vsulako/AFFBWheel/images/base_TLE5010.png

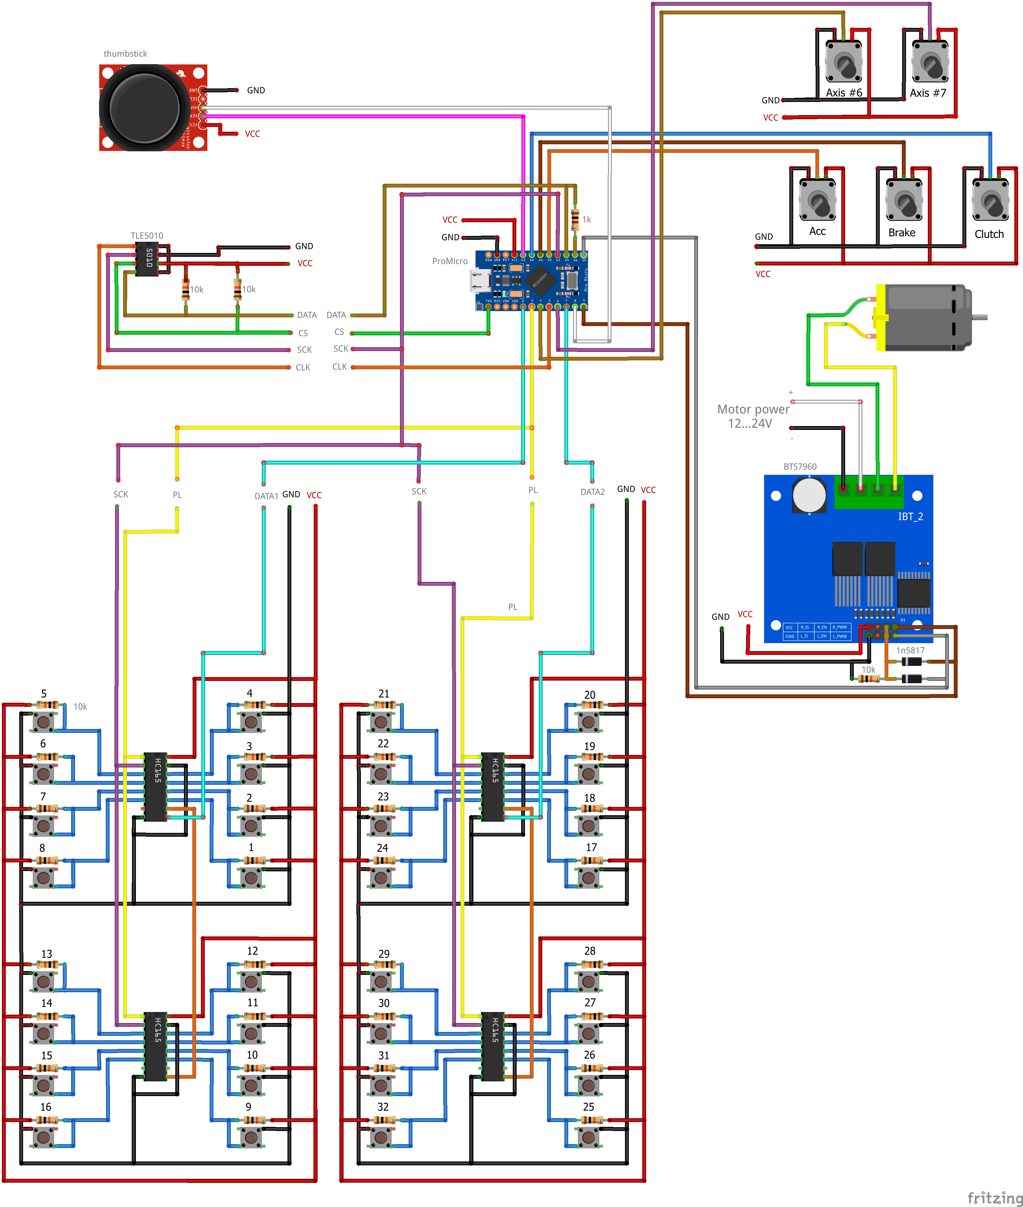
images/base_TLE5010.png
