vsulako/AFFBWheel/images/pedals_ADS1015_resistors.png

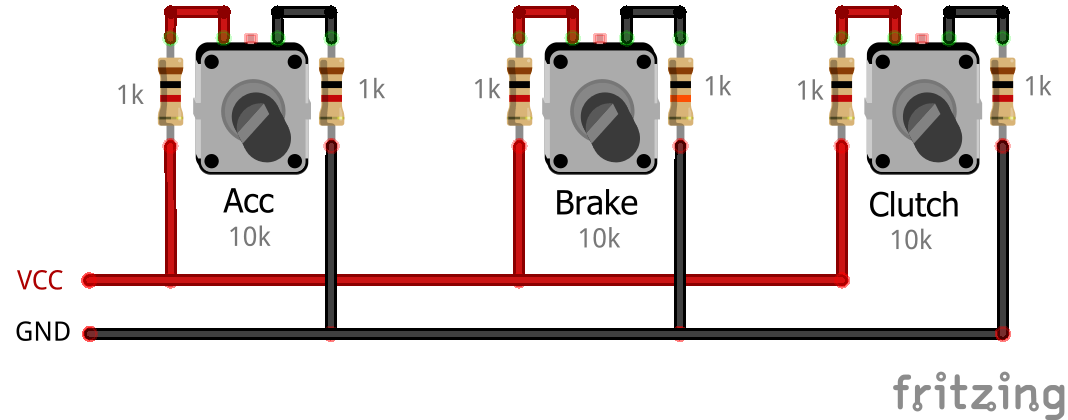
images/pedals_ADS1015_resistors.png
