vsulako/AFFBWheel/images/pedals_ADS1015_TL431.png

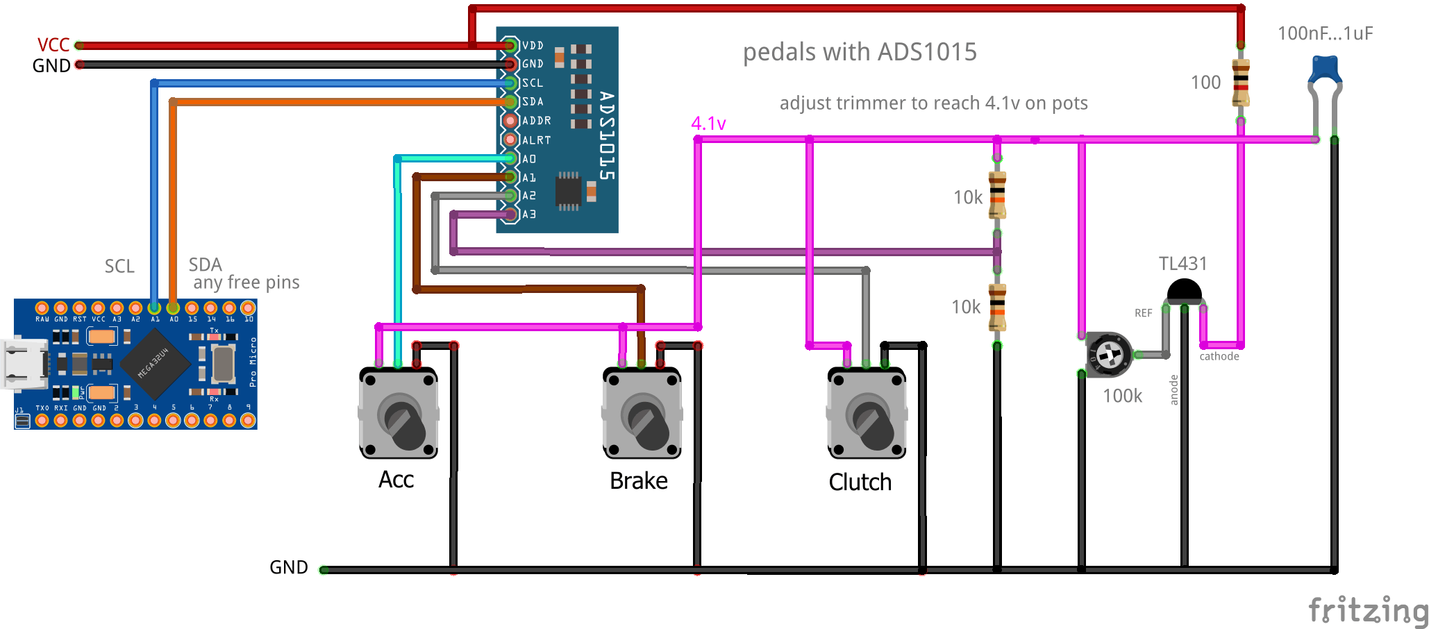
images/pedals_ADS1015_TL431.png
