vsulako/AFFBWheel/images/pedals_HC4052.png

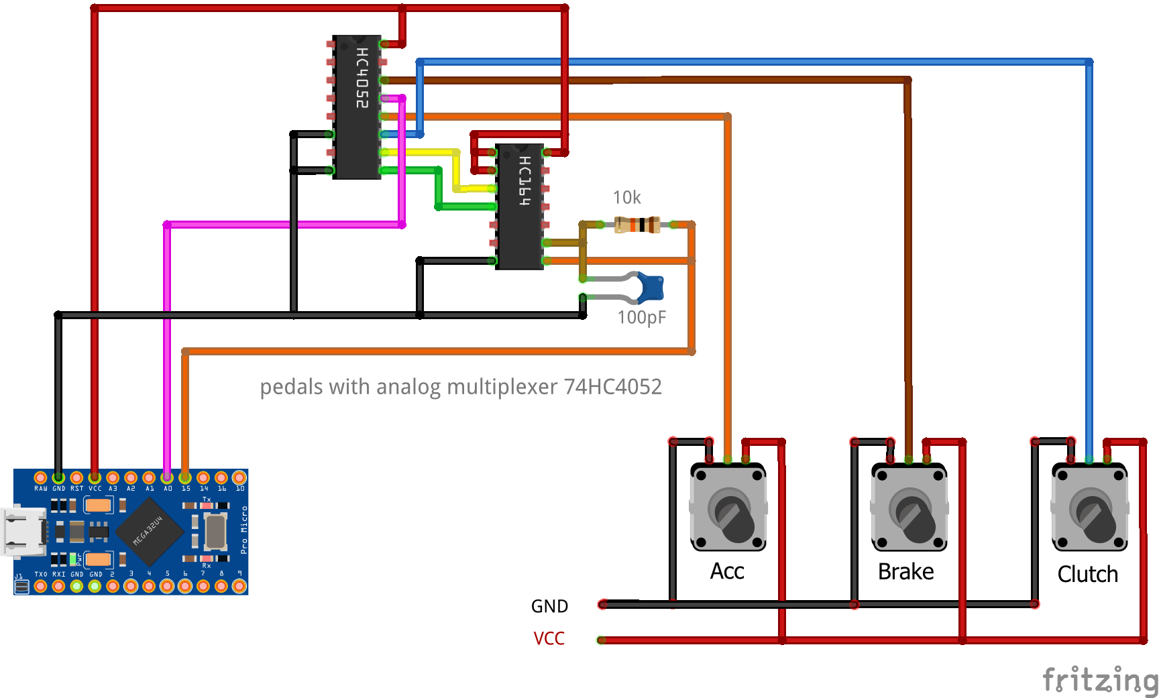
images/pedals_HC4052.png
