vsulako/AFFBWheel/images/pedals_HC4067.png

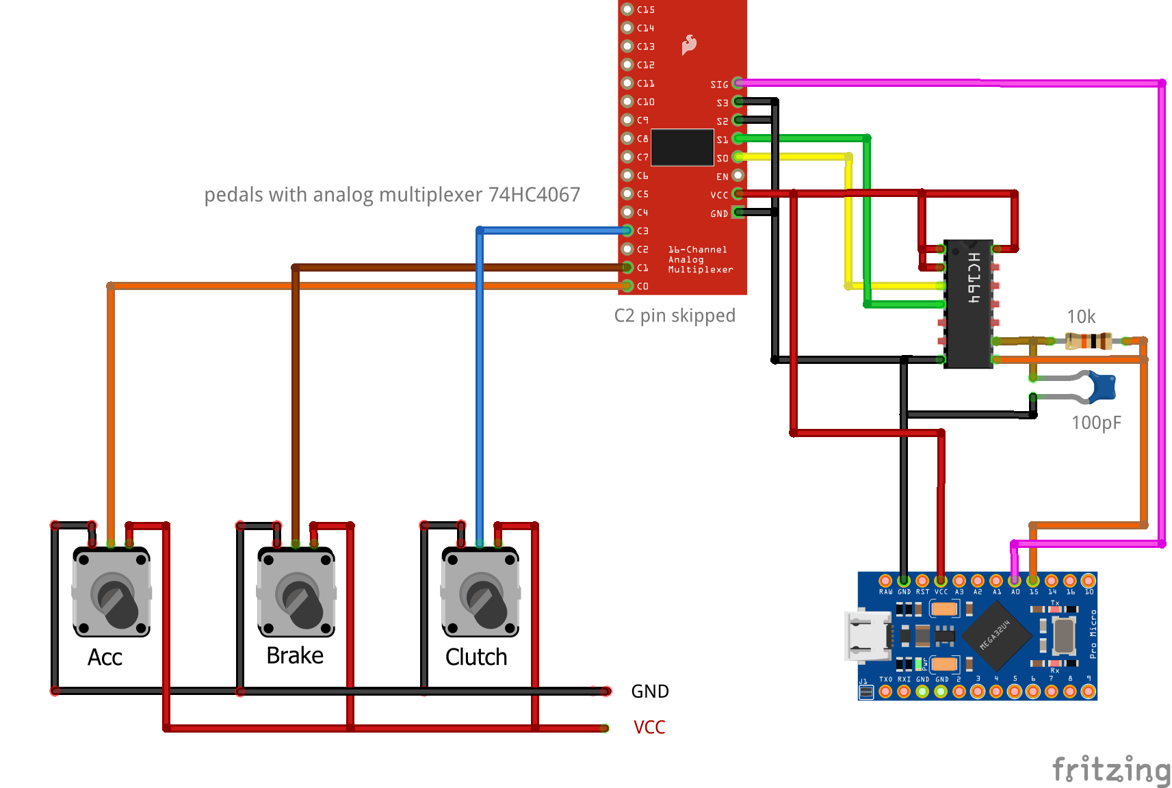
images/pedals_HC4067.png
