vsulako/AFFBWheel/images/pedals_MCP2304_4w_v3.png

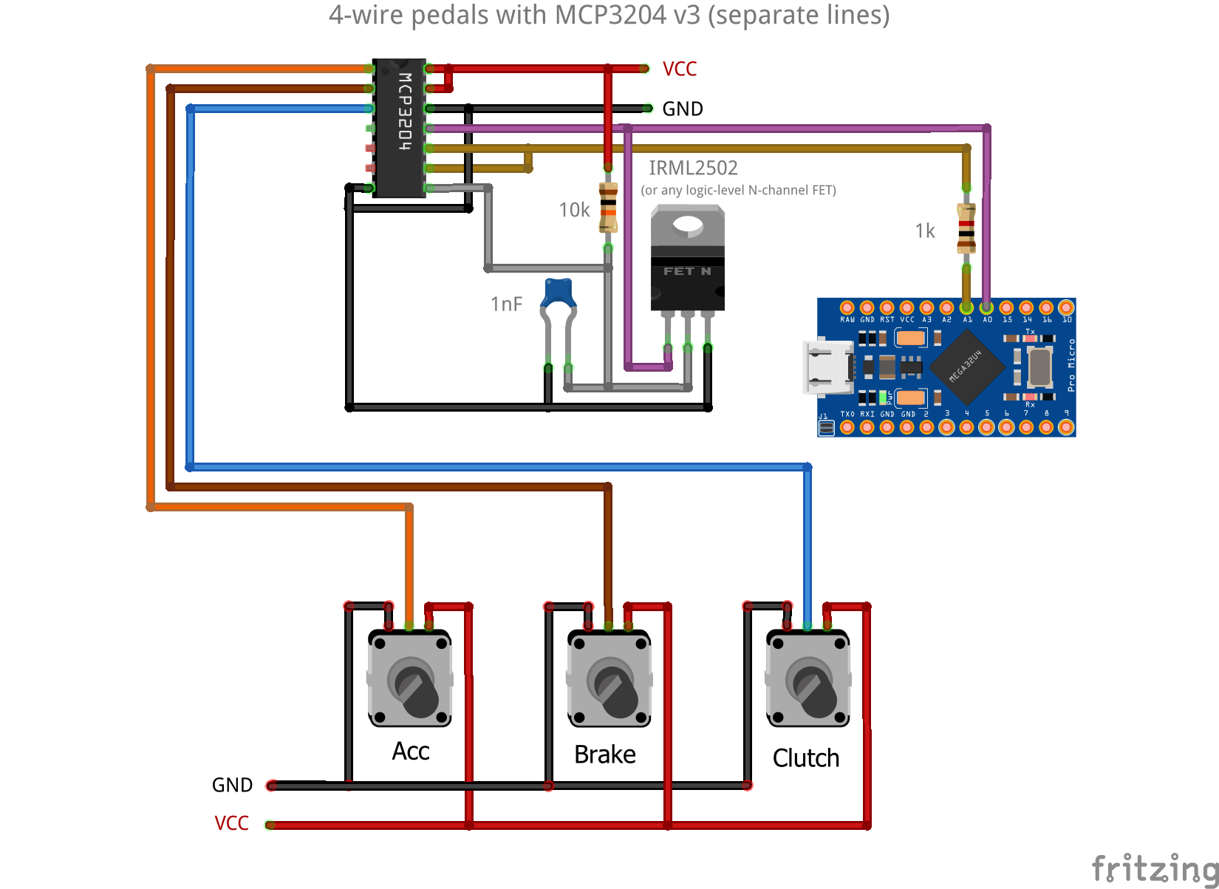
images/pedals_MCP2304_4w_v3.png
