vsulako/AFFBWheel/images/pedals_MCP2304_5w.png

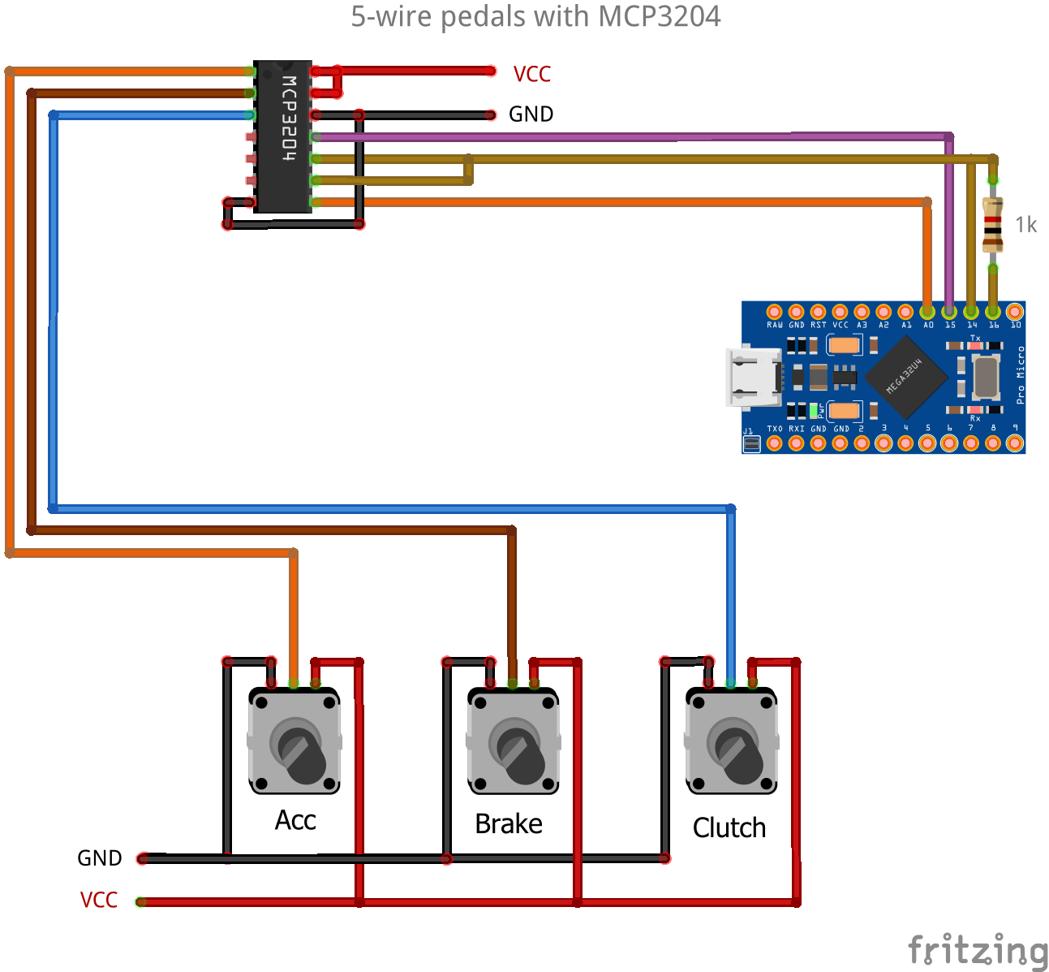
images/pedals_MCP2304_5w.png
