vsulako/AFFBWheel/images/pedals_MCP2304_6w.png

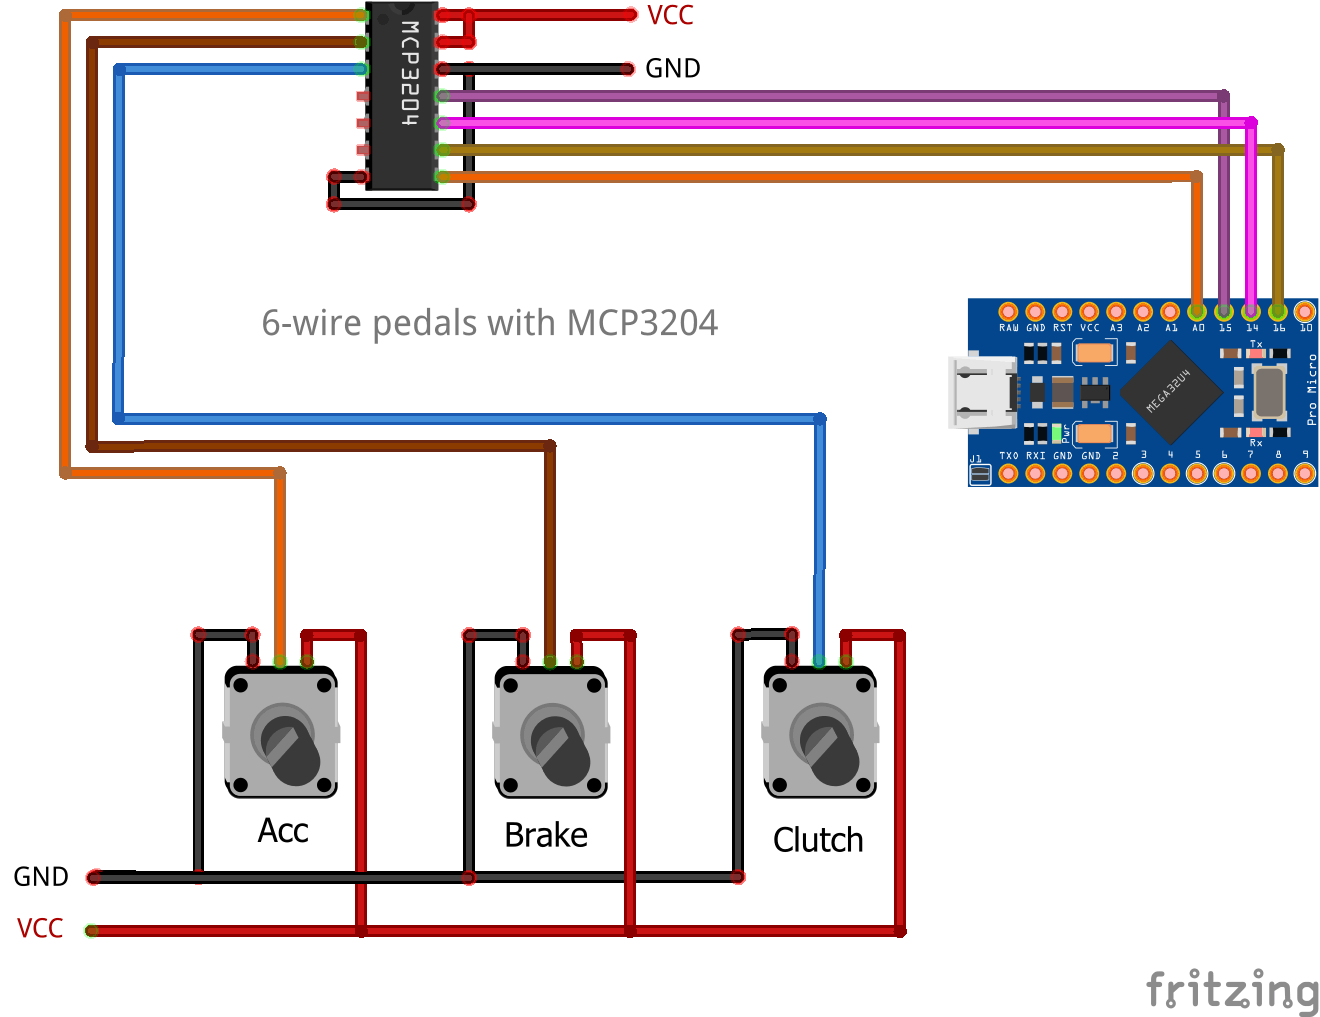
images/pedals_MCP2304_6w.png
