vsulako/AFFBWheel/images/pedals_MCP2304_TLE5010_4w_v1.png

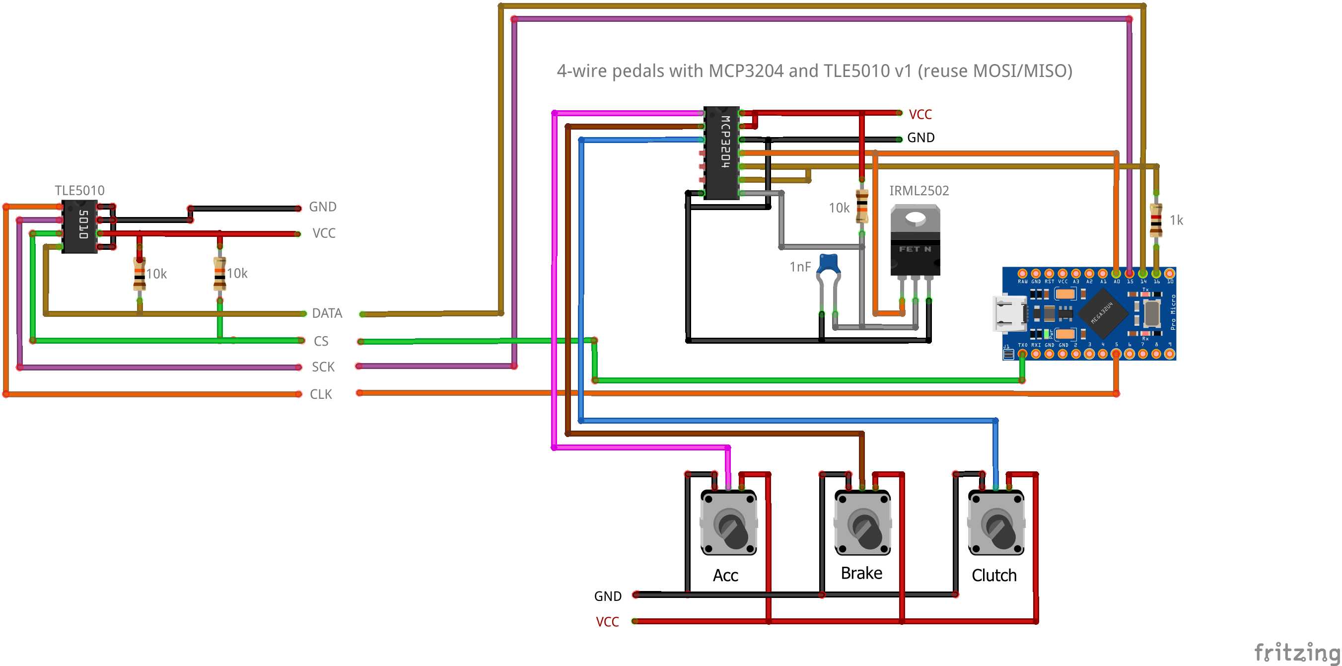
images/pedals_MCP2304_TLE5010_4w_v1.png
