vsulako/AFFBWheel/images/pedals_MCP2304_TLE5010_4w_v2.png

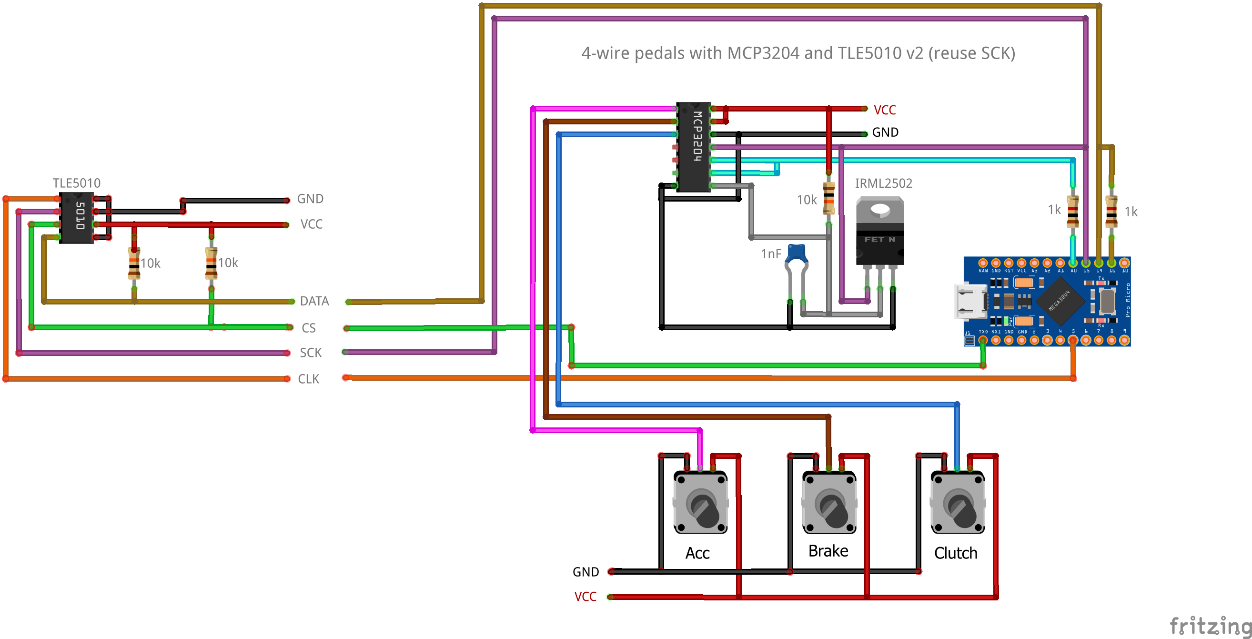
images/pedals_MCP2304_TLE5010_4w_v2.png
