vsulako/AFFBWheel/images/pedals_MCP2304_TLE5010_6w.png

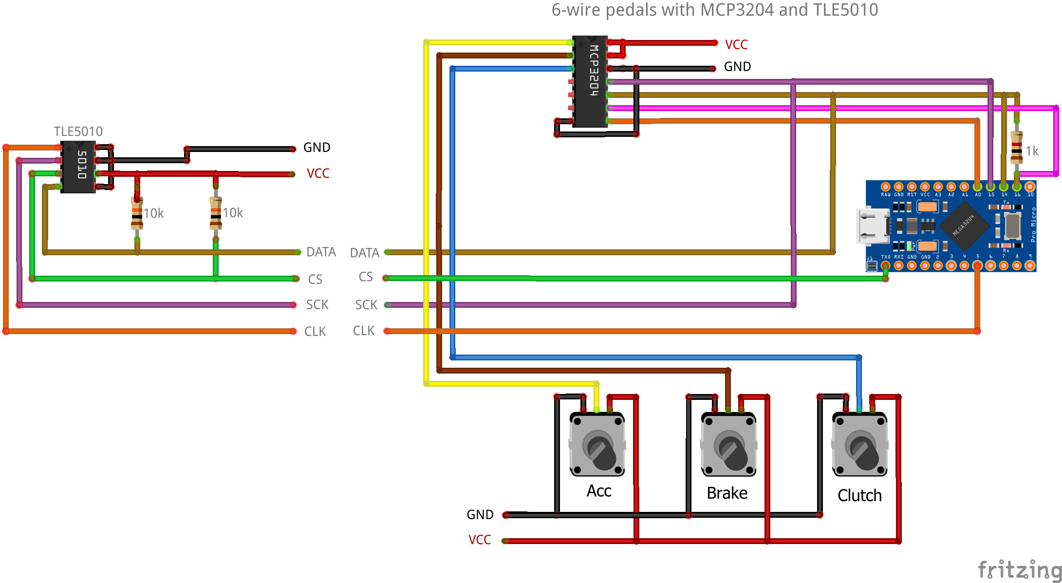
images/pedals_MCP2304_TLE5010_6w.png
