vsulako/AFFBWheel/(threads)

Thread 1 (2022-04-03):

stepper version???

gielbloks, 2022-04-03:
good day i am enjoying this info you share!

i have experience with steppers and power systems through
3d printing and cnc, this is the first sim rig i am building

i am building a sim wheel myself but want to use a double 3nm nema 23 beqause i have them lying around with open loop drivers,

for power i use 4 350 watt hp server psu's in series so 48 volt, otherwise the nema 23 are to slow
costing €20 euro per 10 pieces here

but can i use open loop system with an hall encoder you are using on the steering shaft? the steppers are going to be belt drive 1:4 so i have 24 nm at max, having a little reserve power is wished so the motors don't need to maxxed out and burn..

regards giel

vsulako, 2022-04-03:
Sorry, I think I do not understand your question well.

If you want to use stepper in sim wheel controller as feedback motor - I doubt it can be done easily.
I actually tried that once with disappointing results.
Usually, you can control stepper rotating speed and direction. When there's no control signal, it's standing still.
And it IS still - one almost cannot turn stepper's shaft by hand when it is powered.
So, who needs a sim wheel which only turns by itself, but cannot be turned by hand?
I tried to enable/disable stepper at high frequency, and also lower stepper's current. It somehow helped, but caused stepper to jerk a lot. It was unusable and I did not experiment further.
Of course, you can experiment yourself, but I cannot help with that.
At least, you will need to replace BTS7960 with stepper driver, and rewrite motor handling code to work with this driver.

"hall encoder" (I suppose, you mean TLE5010 or AS5600?) is merely a rotation angle sensor and have nothing to do with feedback motor.

gielbloks, 2022-04-03:
from the 3 d printing systems i always have the position the stepper is moved to
then it stays powered to prevent the moving when an other stepper is running ( the z axis height) is always holding position beqause otherwise it could fall down..sort of standby current ist is adjustable from 10 to 80% typically using 25..

my thoughts where change the pwm signal into a step /dir signal but as i read it isn't that easy..
i also have closed loop drivers but they will always move to the commanded position so i think this couldn't be used eighther or do you think it will?

i was thinking stepper motors are more rigid than dc.. i have a big wiper motor and a starter motor from a truck.. but if you put force on it i was thinking it would burn out in a very short time or am i afraid for nothing?

gielbloks, 2022-04-03:
ill work it out thanks

vsulako, 2022-04-03:
of course dc motor can burn if it is powered and blocked (stalls). I suggest to use external current limiter, or power source that will not exceed stall current of motor.

gielbloks, 2022-04-03:
thinking about another thing,is it also possible to add 10 potentiometers more on it for brake balance etc etc,i am building a full f1 wheel made the wheel itself in carbon/glass fiber when ready i can pull a mold from it so i can duplicate them for 30/50€ 80/100€ including pedalbox and steer base with room for a screen on the base or the steer itself,ill include a picture from the frontplate ( remember it is in the rough!!!)
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

vsulako, 2022-04-03:
You mean add 10 additional axes? No, there is a limit of 8 axes per generic controller.
But simplest solution is to use additional controller. a ProMicro with MMJoy2, or STM32F103C8 with FreeJoy firmware will allow to add 8 axes/128buttons more. If game/sim can use such number of axes, it will defininely work with multiple controllers.

gielbloks, 2022-04-04:
thankyou!!

Thread 2 (2022-04-06):

Hand brake axis.

lazenyuk-dmitry, 2022-04-06:
I haven't used your firmware yet. But it looks cool. I'm still waiting for accessories from AliExpress.

But I think it would be cool to add a pin to connect the handbrake potentiometer.

vsulako, 2022-04-06:
It is possible to add 2 more axes.
Will try to implement it later.

lazenyuk-dmitry, 2022-04-06:
> It is possible to add 2 more axes.

ok, that's what I'm planning to do now.

vsulako, 2022-04-06:
Added 2 analog axes similar to stick. No spare pins now :)

lazenyuk-dmitry, 2022-04-07:
А ты говоришь по русски. У меня с английским не очень. Напишу на руском.

Я думаю достаточно добавить только ручник. Я не понял у тебя совсем не осталось пинов свободных или не осталось свободных для осей? Вроде по схеме еще есть пины свободные. Потому что на свободный пин ты мог бы еще добавить подключение канала Z энкодера, как в этом проекте https://github.com/ranenbg/Arduino-FFB-wheel/issues/3. Можно искать автоматически центральное положение руля при подключении, по моему хорошая фича. Хотя ты может это планировал сделать. Правда энкодер с каналом Z стоит в 3 раза дороже.

Не знаю нужен ли thumbstick вообще. Можно конечно его вынести на руль для обзора в игре но можно так же это и кнопками в принципе делать. Возможно интереснее было бы использование этих осей в качестве КПП на осях, как здесь https://www.youtube.com/watch?v=aYYAbcPKN8g там в описании есть схема. Я слышал что есть КПП logitech которые именно так и работают на потенциометрах. Но опять же не знаю насколько это актуально и многим ли нужно. Ну а вообще тоже интересная фича. Или можно предоставить выбор использовать те оси как thumbstick или как shifter, например как настройку в программе или в прошивке.

Вот в общем добавить подключение Z канала энкодера и автоматический поиск центра. И можно сделать возможность подключения КПП на осях. И тогда в твоей прошивке неверно будет все)

vsulako, 2022-04-07:
Не осталось пинов ProMicro, которые оставались бы свободными во всех вариантах подключений. Дополнительные оси наверное не повредят (хотя увеличивается время опроса). Может быть, лучше сделать их отключаемыми.
Использовать Z канал энкодера и автопоиск центра не планировалось - у меня нет такого энкодера, проверять не на чем. Да и не вижу никакой проблемы выровнять руль вручную и нажать кнопку центровки.
Стик задумывался для обзора в ETS2. Это такие же оси как остальные, их можно использовать на что угодно.
Что до эмуляции КПП двумя осями... выглядит несколько сложно, в плане того как это все конфигурировать и настраивать. Тем более что непонятно, насколько это востребовано. Пока что этот проект использую только я, и то только в ETS2 :)

lazenyuk-dmitry, 2022-04-07:
> Пока что этот проект использую только я, и то только в ETS2 :)

Ну думаю будут пользоваться) Я обязательно попробую как получу arduino leonardo и прочие комплектующие.
Вообще не так много прошивок для arduino. А так вообще пины одни и те же что ProMicro что Leonardo?

Есть группа ВК с обсуждением самодельных рулей можешь заходить если интересно [Самодельный игровой руль. делимся опытом](https://vk.me/join/CbkLyOKf9HyRnVNvNuYgayWbtbIK9rxG7Yg=)

Closed 2022-04-07.

Thread 3 (2022-04-06):

As5600 incorrectly works

Fiesta228, 2022-04-06:
As5600 dont work with this sketch, but works good with testing skech.
Магнитный датчик угла не работает, даже не шумит при поднесении магнита на любое расстояние, вы сталкивались с таким? Может ли быть такое изза не подключенных других осей? Что делать?

Fiesta228, 2022-04-06:
> У вас не используются другие i2c устройства - ADS1015 или MCP23017?
> Обновил код  (файлы AFFBWheel.ino, bb_i2c.h, bb_i2c.cpp), попробуйте теперь.

Другие устройства не использовались, теперь все работает, спасибо.

Thread 4 (2022-04-22):

AS5600 Arduino Leonardo

mitiaborodada, 2022-04-22:
Приветствую! Никак не хочет работать датчик AS5600 с Arduino Leonardo. Подключаю пины датчика SDA и SCL к пинам ардуино - RXI TX0 соответственно.  В config.h прописываю:
#define I2C_PIN_SDA 0
#define I2C_PIN_SCL 1

Но ничего не работает, никакой реакции. Причём сам датчик работает на этой же ардуинке с проверочным кодом.
Естественно, SDA и SCL подключаю к ардуино к соответствующим пинам SDA и SCL:

#include <AS5600.h>
AS5600 encoder;
int Wheel;
void setup() {
Serial.begin(115200);
}
void loop() {
Wheel = encoder.getPosition();
Serial.println(Wheel);
}

Уже голову сломал. Буду очень благодарен за помощь.

vsulako, 2022-04-22:
Используете последний код прошивки? Ранее была проблема изза которой AS5600 не работал.

mitiaborodada, 2022-04-23:
Да, скачивал буквально вчера. Может быть проблема из-за того, что кроме датчика AS5600 больше ничего не подключаю при этом? Сначала думал, что датчик сгорел, на этой же ардуинке с тестовым кодом работает и данные читаются.

vsulako, 2022-04-23:
Нет, должно работать и без всего остального. Попробуйте подключить к другим пинам.
Строчки для энкодера комментировать не обязательно, они используются только если в  STEER_TYPE указан ST_ENCODER.

mitiaborodada, 2022-04-23:
Да, спасибо, всё получилось! Я исправил предыдущее свое сообщение.
 Остался последний вопрос.
Как мне использовать AS5600 на всех осях: руль + педали?

vsulako, 2022-04-23:
Датичк еще может не работать, если его подключить после старта (или в процессе работы у него пропадет питание), потому что при старте идет инициализация, а далее только опрос.
В этой прошивке поддержка AS5600 планировалась только на оси руля. На педалях можно разве что вместо потенциометров поставить датчики Холла.
а чтобы AS5600 ставить на педали и другие оси, понадобится доработка. AS5600 еще и не позволяет менять I2C адрес, так что понадобятся ухищрения - что-то вроде TCA9548, либо на каждый датчик хотя бы по отдельной SDA линии, либо что-то еще - а это будет много изменений и в подключениях, и в коде. А у меня всего один датчик, я даже попробовать не могу :)

vsulako, 2022-04-23:
Вообще ведь у AS5600 есть еще аналоговый выход, так что дополнительные датчики можно подключать как потенциометры - выход OUT вместо среднего контакта потенциометра. Но я это не пробовал.

mitiaborodada, 2022-04-24:
Кстати, пробовал использовать 4 датчика с помощью TCA9548A. Отлично всё работает.

Всё таки, что-то не так и не пойму пока источник проблемы. Вчера всего лишь перепаял другой провод на датчике. Подключаю к ардуинке и снова ничего не работает - никаких сигналов! Тут же заливаю тестовую прошивку, переключаю SDA и SCL на соответствующие пины Arduino SDA и SCL и вуаля - всё работает! Переключаю обратно и ничего не работает. Пробовал с другими пинами, тоже ничего не работает.
Ещё помучаюсь с этим датчиком и наверное буду переходить на обычный энкодер.

vsulako, 2022-04-24:
Есть предположение. Попробуйте в файле bb_i2c.cpp сверху изменить 4 строчки:

```
#define I2C_SDA_LOW   {pinModeFast(I2C_PIN_SDA, OUTPUT);__builtin_avr_delay_cycles(4);}
#define I2C_SDA_HIGH  {pinModeFast(I2C_PIN_SDA, INPUT);__builtin_avr_delay_cycles(4);}
#define I2C_SCL_LOW   {pinModeFast(I2C_PIN_SCL, OUTPUT);__builtin_avr_delay_cycles(4);}
#define I2C_SCL_HIGH  {pinModeFast(I2C_PIN_SCL, INPUT);__builtin_avr_delay_cycles(4);}
```
и посмотреть не заработает ли.

mitiaborodada, 2022-04-26:
Да, всё получилось! Спасибо огромное!
Вроде понял в чём была проблема. У меня датчики на 3,3 вольта. Я изначально подключал его к Arduino micro через преобразователь напряжения на 3.3 вольта. Всё работало без проблем, но на leonardo при подключении к пину 3.3 вольта и к RX TX работает не стабильно. Можно сказать, что вообще не работает. Даже с преобразователем не захотел работать. Но на свой страх и риск попробовал на 5 вольт подключить и о чудо, заработал на leonardo! Но лучше всё таки на 3.3. В итоге с вашими последними рекомендациями заработало на leonardo на 3.3 вольта, как и положено.

И всё таки хочу попробовать помучиться подключить AS5600 через TCA9548A и КПП по двум проводам (на каждую кнопку у меня резистор добавлен), опять же, если получится.

Ещё раз, большое спасибо!

vsulako, 2022-04-26:
Код в последнем сообщении увеличивает задержки при обмене по I2C, я предложил его для диагностики. Если работает и без него, то лучше задержки (__builtin_avr_delay_cycles) убрать.
Я был уверен что AS5600 (белый квадратный модуль) работает от 5в, так как контакт VCC соединен с первой ножкой чипа, и сразу его подключал к 5в. А оказывается, еще и со второй. Надо подумать что с этим делать. Вообще говоря, у меня он на леонардо и на 3.3в работает, но в руле promicro, там преобразователя 3.3 нет.
TCA9548A у меня нет в наличии, с ним помочь не могу. Для минимизации проблем можно повесить его на пины для аппаратного i2c и использовать готовые библиотеки. Код работы с осями педалей, по моему, должен быть вполне понятен, если что - спрашивайте.

vsulako, 2022-04-26:
Нашел - чтобы безопасно подключать модуль AS5600 к 5в, надо убрать резистор R1 (0ом).

vsulako, 2022-04-27:
Тут вот в чем дело. Я работаю с i2c устройствами через ручную манипуляцию пинами, так получается быстрее, и можно брать любые пины.
Но не все устройства могут работать достаточно быстро, поэтому приходится немного притормозить обмен, кое-где вставляя задержки. Я подобрал задержки под свои устройства, предполагая что все они одинаковые. Видимо, нет.
Предложенный код добавляет задержку в 4 такта на каждое действие с i2c. Попробуйте поуменьшать в нем значение для __builtin_avr_delay_cycles, от 4 до 1.

mitiaborodada, 2022-04-28:
Уменьшил задержку с 4 сразу до 1 - работает - так и оставлю! Видимо это особенность моих устройств, в первую очередь  моего экземпляра Arduino Leonardo, т.к. на микро всё работает по дефолту.

mitiaborodada, 2022-05-01:
Удалось реализовать педали на датчике AS5600 вместо резисторов. Удалил на плате датчиков 2 резистора: R1 (0 Ом) и R4

mitiaborodada, 2022-07-02:
Приветствую!
Я не знаю, что у меня происходит с датчиком AS5600, но он перестал работать на руле. (заказал себе TLE, посмотрю как он будет себя вести)
Суть в том, что AS5600 в один прекрасный день просто перестал реагировать на поворот магнита. Вообще никакие показания не считывает, как будто датчик мертв. Причём за день до этого было всё нормально.
При этом, заливаю тестовый скетч и просто "перетыкиваю" коннекторы с датчика на SDA и SCL на соответствующие пины Leonardo - датчика работает. Всё четко считывает. Что за магия, понять не могу!

Может есть какие-то идеи?

#include <AS5600.h>
AS5600 encoder;
int Wheel;
void setup() {
Serial.begin(115200);
}
void loop() {
Wheel = encoder.getPosition();
Serial.println(Wheel);
}

vsulako, 2022-07-02:
А задержки о которых тут речь выше, есть? которые __builtin_avr_delay_cycles
забыл их добавить, может, вы обновили прошивку?

если использовать "родные" i2c пины, то надо бы добавлять и "родной" i2c.
Примерно так: ищем код
```
#if STEER_TYPE == ST_AS5600
  #include "bb_i2c.h"
  #include "multiturn.h"

  AS5600_BBI2C AS5600;
  MultiTurn MT;

  #define SETUP_WHEEL_SENSOR setupAS5600();
  #define GET_WHEEL_POS (MT.setValue((AS5600.readAngle()-2048)<<(STEER_BITDEPTH-12)))
  #define CENTER_WHEEL MT.zero();

  void setupAS5600()
  {
     AS5600.begin();
  }
#endif
```
и меняем на
```
#if STEER_TYPE == ST_AS5600
  #include <AS5600.h>
  #include "multiturn.h"
  AS5600 encoder;

  MultiTurn MT;

  #define SETUP_WHEEL_SENSOR
  #define GET_WHEEL_POS (MT.setValue((encoder.getPosition()-2048)<<(STEER_BITDEPTH-12)))
  #define CENTER_WHEEL MT.zero();

#endif
```
В работе не проверено, просто поменял соответственно вашему коду.
И еще придется освободить пины 2 и 3, так как они и есть "родные" SCL/SDA (те которые выведены отдельно на Leonardo - это они же), если на них что-то будет - будет мешать.

mitiaborodada, 2022-07-02:
Семён Семёныч, точно!  Я же обновился, а про эти настройки забыл. Причём после обновления датчик какое-то время работал, а потом просто "сдох".
Спасибо тебе, добрый человек!

Closed 2022-07-02.

Thread 5 (2022-04-27):

Compilation errors.

lazenyuk-dmitry, 2022-04-27:
Привет. У меня есть ошибки во время компиляции. Но мой arduino leonardo прошивается и определяется в устройствах. Но не работает программа для настройки руля, ошибка при старте. Я скачал все дополнительные библиотеки для компиляции. Сейчас у меня подключен только энкодер.

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

vsulako, 2022-04-27:
Компилятор предупреждает о мелочах(повторные определения, убрал их), это не мешает компиляции и не связано с этой ошибкой. Не знаю в чем может быть дело.  Устройство видно, данные идут, связь должна быть. А что если запустить от администратора?

lazenyuk-dmitry, 2022-04-27:
> А что если запустить от администратора?

Пробовал не помогает. Все так же. Может быть дело в определении порта?
Порт выбирается после подключения? Или как это реализовано у тебя?

vsulako, 2022-04-27:
Порты там не используются, связь через HID-репорты. Есть возможность проверить на другом компьютере?

lazenyuk-dmitry, 2022-04-28:
Проверил на ноутбуке там работает. На моем компе не хочет. Даже если я не подключаю arduino к ПК то все равно ошибка "Device cannot be opened", а на ноутбуке такой ошибки нет при отключенном arduino, там открывается программа без ошибок и просто написано "No connection". Похоже на то что он пытается подключиться к какому то устройству но не к arduino. Я уже и удалил драйвера лишние и все устройства отключил кроме мыши и клавиатуры и пробовал удалять устройства в диспетчере и пробовал загружать в безопасном режиме... Все так же в "Device cannot be opened". Есть идеи?) Не хочу переустанавливать винду. Да и нет 100% гарантии что это поможет.

vsulako, 2022-04-28:
Идей пока нет. Похоже, это как-то связано с ОС, почему-то windows не дает доступа к USB HID. Или в компоненте, который использую для связи, какой-то плавающий глюк. Пока не повторю у себя, ничего не могу сказать, а на моих компьютерах работает. Можно же настраивать и через компорт, командами - там тоже самое, хотя не так наглядно.
Какая версия Windows?

lazenyuk-dmitry, 2022-04-28:
Windows 10. И я проверял на ноутбуке с  windows 10 там работает.

Мы можем связаться с вами в телеграм или вк может как то выявить этот баг. Может смогу как то дебаг запустить у себя и предоставить инфу вам. В общем можно связаться более удобным способом и разобраться с этим возможно)

lazenyuk-dmitry, 2022-04-28:
Я выяснил что это не связанно с твоей программой)

На этом форуме https://issuetracker.delphi-jedi.org/view.php?id=5894 скачал HID tester и он выдает ту же ошибку.

Вот есть детальная информация) Может ты хоть что то поймешь. Буду копаться.
```
------------------------------------------------------------------------------
Exception log with detailed tech info. Generated on 28.04.2022 23:02:17.
You may send it to the application vendor, helping him to understand what had happened.
 Application title: Melloware HID Tester
 Application file: C:\Users\Dima\AppData\Local\Temp\Rar$EX00.442\HIDTester.exe
------------------------------------------------------------------------------
Exception class: EControllerError
Exception message: Device cannot be opened.
Exception address: 00535FDE
------------------------------------------------------------------------------
Main thread ID = 12068
Exception thread ID = 12068
------------------------------------------------------------------------------
Exception stack
Stack list, generated 28.04.2022 23:02:17
[00535FD9]{HIDTester.exe} JvHidControllerClass.TJvHidDevice.CtlCreate (Line 735, "JvHidControllerClass.pas" + 46)
[00537A8D]{HIDTester.exe} JvHidControllerClass.FillInList (Line 1709, "JvHidControllerClass.pas" + 28)
[00537AEA]{HIDTester.exe} JvHidControllerClass.TJvHidDeviceController.DeviceChange (Line 1725, "JvHidControllerClass.pas" + 5)
[00537961]{HIDTester.exe} JvHidControllerClass.TJvHidDeviceController.EventPipe (Line 1651, "JvHidControllerClass.pas" + 8)
[004575B8]{HIDTester.exe} System.Classes.StdWndProc (Line 13878, "System.Classes.pas" + 8)
[0051A25F]{HIDTester.exe} Vcl.Forms.TApplication.ProcessMessage (Line 10164, "Vcl.Forms.pas" + 23)
[0051A2A2]{HIDTester.exe} Vcl.Forms.TApplication.HandleMessage (Line 10194, "Vcl.Forms.pas" + 1)
[0051A5E1]{HIDTester.exe} Vcl.Forms.TApplication.Run (Line 10332, "Vcl.Forms.pas" + 26)
[00598710]{HIDTester.exe} HIDTester.HIDTester (Line 16, "" + 4)
------------------------------------------------------------------------------
Call stack for main thread
Stack list, generated 28.04.2022 23:02:17
[77E10C2C]{ntdll.dll   } ZwGetContextThread
------------------------------------------------------------------------------
System   :  Workstation, Version: 6.2, Build: 23F0, ""
Processor: AMD, AMD Ryzen 5 1400 Quad-Core Processor           , 3200 MHz MMXex MMX SSE SSE2 SSE3 SSE41 SSE42 SSE4A 64 bits DEP
Memory: 16311; free 10712
Display  : 1920x1080 pixels, 32 bpp
------------------------------------------------------------------------------
List of loaded modules:
[00400000] C:\Users\Dima\AppData\Local\Temp\Rar$EX00.442\HIDTester.exe
           1.0.0.0 - 1.0.0.0
           Unit versioning information:
             JCL\source\common JclResources.pas 3717 2012-02-12 08:43:23 +0100 (dim. 12 fÃ©vr. 2012)
             JCL\source\common JclBase.pas 3759 2012-03-04 19:39:47 +0100 (dim. 04 mars 2012)
             JCL\source\windows JclWin32.pas 3796 2012-05-23 15:57:30 +0200 (mer. 23 mai 2012)
             JCL\source\common JclLogic.pas 3599 2011-09-03 00:07:50 +0200 (sam. 03 sept. 2011)
             JCL\source\common JclStringConversions.pas 3599 2011-09-03 00:07:50 +0200 (sam. 03 sept. 2011)
             JCL\source\common JclCharsets.pas 3599 2011-09-03 00:07:50 +0200 (sam. 03 sept. 2011)
             JCL\source\common Jcl8087.pas 3599 2011-09-03 00:07:50 +0200 (sam. 03 sept. 2011)
             JCL\source\common JclMath.pas 3599 2011-09-03 00:07:50 +0200 (sam. 03 sept. 2011)
             JCL\source\common JclStreams.pas 3773 2012-04-08 18:49:18 +0200 (dim. 08 avr. 2012)
             JCL\source\common JclAnsiStrings.pas 3668 2012-01-03 20:03:51 +0100 (mar. 03 janv. 2012)
             JCL\source\windows Snmp.pas 3599 2011-09-03 00:07:50 +0200 (sam. 03 sept. 2011)
             JCL\source\windows JclSecurity.pas 3599 2011-09-03 00:07:50 +0200 (sam. 03 sept. 2011)
             JCL\source\common JclDateTime.pas 3599 2011-09-03 00:07:50 +0200 (sam. 03 sept. 2011)
             JCL\source\common JclFileUtils.pas 3771 2012-03-22 17:29:05 +0100 (jeu. 22 mars 2012)
             JCL\source\windows JclShell.pas 3599 2011-09-03 00:07:50 +0200 (sam. 03 sept. 2011)
             JCL\source\common JclIniFiles.pas 3599 2011-09-03 00:07:50 +0200 (sam. 03 sept. 2011)
             JCL\source\common JclSysInfo.pas 3759 2012-03-04 19:39:47 +0100 (dim. 04 mars 2012)
             JCL\source\common JclUnicode.pas 3772 2012-04-08 18:32:43 +0200 (dim. 08 avr. 2012)
             JCL\source\common JclWideStrings.pas 3759 2012-03-04 19:39:47 +0100 (dim. 04 mars 2012)
             JCL\source\common JclStrings.pas 3770 2012-03-11 18:27:44 +0100 (dim. 11 mars 2012)
             JCL\source\windows JclRegistry.pas 3660 2011-12-29 01:21:39 +0100 (jeu. 29 dÃ©c. 2011)
             JCL\source\common JclSynch.pas 3759 2012-03-04 19:39:47 +0100 (dim. 04 mars 2012)
             JCL\source\common JclUnitVersioning.pas 3653 2011-12-27 22:47:24 +0100 (mar. 27 dÃ©c. 2011)
             JCL\source\windows JclConsole.pas 3724 2012-02-12 23:30:08 +0100 (dim. 12 fÃ©vr. 2012)
             JCL\source\common JclSysUtils.pas 3794 2012-05-15 12:16:16 +0200 (mar. 15 mai 2012)
             JCL\source\windows JclPeImage.pas 3797 2012-05-23 15:57:42 +0200 (mer. 23 mai 2012)
             JCL\source\common JclUnitVersioningProviders.pas 3599 2011-09-03 00:07:50 +0200 (sam. 03 sept. 2011)
             JCL\source\windows JclTD32.pas 3599 2011-09-03 00:07:50 +0200 (sam. 03 sept. 2011)
             JCL\source\windows JclHookExcept.pas 3757 2012-03-04 19:12:39 +0100 (dim. 04 mars 2012)
             JCL\source\windows JclDebug.pas 3783 2012-04-20 22:48:14 +0200 (ven. 20 avr. 2012)
[65B50000] C:\Windows\System32\CoreUIComponents.dll
           6.2.17763.1 - 10.0.17763.1
           Microsoft Core UI Components Dll
[6C9D0000] C:\Windows\SYSTEM32\wintypes.dll
           6.2.17763.1 - 10.0.17763.2920 (WinBuild.160101.0800)
           Библиотека DLL основных типов Windows
[6D8A0000] C:\Windows\System32\dbghelp.dll
           6.2.17763.1 - 10.0.17763.1 (WinBuild.160101.0800)
           Windows Image Helper
[6E930000] C:\Windows\System32\CoreMessaging.dll
           6.2.17763.55 - 10.0.17763.55
           Microsoft CoreMessaging Dll
[701F0000] C:\Windows\SYSTEM32\HID.dll
           6.2.17763.1 - 10.0.17763.2920 (WinBuild.160101.0800)
           Библиотека пользователя HID
[70200000] C:\Windows\System32\TextInputFramework.dll
           6.2.17763.1 - 10.0.17763.1 (WinBuild.160101.0800)
           "TextInputFramework.DYNLINK"
[72A80000] C:\Windows\WinSxS\x86_microsoft.windows.common-controls_6595b64144ccf1df_6.0.17763.55_none_07590d51410af084\comctl32.dll
           6.10.17763.1 - 6.10 (WinBuild.160101.0800)
           Библиотека элементов управления взаимодействия с пользователем
[73400000] C:\Windows\SYSTEM32\WINSTA.dll
           6.2.17763.1 - 10.0.17763.1 (WinBuild.160101.0800)
           Winstation Library
[73E00000] C:\Windows\SYSTEM32\DEVOBJ.dll
           6.2.17763.1 - 10.0.17763.1 (WinBuild.160101.0800)
           Device Information Set DLL
[74820000] C:\Windows\SYSTEM32\ntmarta.dll
           6.2.17763.1 - 10.0.17763.2920 (WinBuild.160101.0800)
           Поставщик Windows NT MARTA
[74A80000] C:\Windows\system32\dwmapi.dll
           6.2.17763.1 - 10.0.17763.2920 (WinBuild.160101.0800)
           Интерфейс API диспетчера окон рабочего стола (Майкрософт)
[74B70000] C:\Windows\SYSTEM32\apphelp.dll
           6.2.17763.1 - 10.0.17763.2920 (WinBuild.160101.0800)
           Клиентская библиотека совместимости приложений
[74E00000] C:\Windows\SYSTEM32\PROPSYS.dll
           7.0.17763.1 - 7.0.17763.2920 (WinBuild.160101.0800)
           Система страниц свойств (Майкрософт)
[74FC0000] C:\Windows\SYSTEM32\version.dll
           6.2.17763.1 - 10.0.17763.1 (WinBuild.160101.0800)
           Version Checking and File Installation Libraries
[75050000] C:\Windows\SYSTEM32\IPHLPAPI.DLL
           6.2.17763.1 - 10.0.17763.2920 (WinBuild.160101.0800)
           API вспомогательного приложения IP
[75290000] C:\Windows\SYSTEM32\wtsapi32.dll
           6.2.17763.1 - 10.0.17763.1 (WinBuild.160101.0800)
           Windows Remote Desktop Session Host Server SDK APIs
[752D0000] C:\Windows\system32\uxtheme.dll
           6.2.17763.1 - 10.0.17763.2920 (WinBuild.160101.0800)
           Библиотека тем UxTheme (Microsoft)
[75380000] C:\Windows\SYSTEM32\winspool.drv
           6.2.17763.1 - 10.0.17763.1 (WinBuild.160101.0800)
           Драйвер диспетчера очереди Windows
[753F0000] C:\Windows\SYSTEM32\msimg32.dll
           6.2.17763.1 - 10.0.17763.1 (WinBuild.160101.0800)
           GDIEXT Client DLL
[75400000] C:\Windows\System32\CRYPTBASE.dll
           6.2.17763.1 - 10.0.17763.1 (WinBuild.160101.0800)
           Base cryptographic API DLL
[75410000] C:\Windows\System32\SspiCli.dll
           6.2.17763.1 - 10.0.17763.1 (WinBuild.160101.0800)
           Security Support Provider Interface
[75550000] C:\Windows\System32\oleaut32.dll
           6.2.17763.1 - 10.0.17763.1 (WinBuild.160101.0800)
           OLEAUT32.DLL
[755F0000] C:\Windows\System32\SetupApi.dll
           6.2.17763.1 - 10.0.17763.2920 (WinBuild.160101.0800)
           Windows Setup API
[75A40000] C:\Windows\System32\MSCTF.dll
           6.2.17763.1 - 10.0.17763.2920 (WinBuild.160101.0800)
           Серверная библиотека MSCTF
[75B80000] C:\Windows\System32\combase.dll
           6.2.17763.1 - 10.0.17763.1 (WinBuild.160101.0800)
           Microsoft COM для Windows
[75E00000] C:\Windows\System32\comdlg32.dll
           6.2.17763.1 - 10.0.17763.2920 (WinBuild.160101.0800)
           Библиотека общих диалоговых окон
[75F00000] C:\Windows\System32\bcryptPrimitives.dll
           6.2.17763.1 - 10.0.17763.1 (WinBuild.160101.0800)
           Windows Cryptographic Primitives Library
[75F70000] C:\Windows\System32\user32.dll
           6.2.17763.1 - 10.0.17763.2920 (WinBuild.160101.0800)
           Многопользовательская библиотека клиента USER API Windows
[76110000] C:\Windows\System32\KERNELBASE.dll
           6.2.17763.1 - 10.0.17763.1 (WinBuild.160101.0800)
           Библиотека клиента Windows NT BASE API
[76370000] C:\Windows\System32\gdi32full.dll
           6.2.17763.55 - 10.0.17763.55 (WinBuild.160101.0800)
           GDI Client DLL
[76650000] C:\Windows\System32\shlwapi.dll
           6.2.17763.1 - 10.0.17763.2920 (WinBuild.160101.0800)
           Библиотека небольших программ оболочки
[766A0000] C:\Windows\System32\shcore.dll
           6.2.17763.1 - 10.0.17763.2920 (WinBuild.160101.0800)
           SHCORE
[76730000] C:\Windows\System32\msvcrt.dll
           7.0.17763.1 - 7.0.17763.1 (WinBuild.160101.0800)
           Windows NT CRT DLL
[768B0000] C:\Windows\System32\MSASN1.dll
           6.2.17763.1 - 10.0.17763.1 (WinBuild.160101.0800)
           ASN.1 Runtime APIs
[768C0000] C:\Windows\System32\ole32.dll
           6.2.17763.1 - 10.0.17763.1 (WinBuild.160101.0800)
           Microsoft OLE для Windows
[769C0000] C:\Windows\System32\bcrypt.dll
           6.2.17763.1 - 10.0.17763.2920 (WinBuild.160101.0800)
           Библиотека криптографических примитивов Windows
[76A40000] C:\Windows\System32\shell32.dll
           6.2.17763.55 - 10.0.17763.1 (WinBuild.160101.0800)
           Общая библиотека оболочки Windows
[76F90000] C:\Windows\System32\msvcp_win.dll
           6.2.17763.1 - 10.0.17763.1 (WinBuild.160101.0800)
           Microsoft® C Runtime Library
[77010000] C:\Windows\System32\powrprof.dll
           6.2.17763.1 - 10.0.17763.2920 (WinBuild.160101.0800)
           DLL модуля поддержки профиля управления питанием
[77070000] C:\Windows\System32\advapi32.dll
           6.2.17763.1 - 10.0.17763.2920 (WinBuild.160101.0800)
           Расширенная библиотека API Windows 32
[770F0000] C:\Windows\System32\ucrtbase.dll
           6.2.17763.1 - 10.0.17763.1 (WinBuild.160101.0800)
           Microsoft® C Runtime Library
[77220000] C:\Windows\System32\sechost.dll
           6.2.17763.1 - 10.0.17763.1 (WinBuild.160101.0800)
           Host for SCM/SDDL/LSA Lookup APIs
[772A0000] C:\Windows\System32\win32u.dll
           6.2.17763.1 - 10.0.17763.1 (WinBuild.160101.0800)
           Win32u
[772C0000] C:\Windows\System32\CRYPT32.dll
           6.2.17763.1 - 10.0.17763.2920 (WinBuild.160101.0800)
           API32 криптографии
[77460000] C:\Windows\System32\cryptsp.dll
           6.2.17763.1 - 10.0.17763.1 (WinBuild.160101.0800)
           Cryptographic Service Provider API
[774E0000] C:\Windows\System32\PSAPI.dll
           6.2.17763.1 - 10.0.17763.1 (WinBuild.160101.0800)
           Process Status Helper
[774F0000] C:\Windows\System32\windows.storage.dll
           6.2.17763.1 - 10.0.17763.2920 (WinBuild.160101.0800)
           API хранения Microsoft WinRT
[77B00000] C:\Windows\System32\IMM32.DLL
           6.2.17763.1 - 10.0.17763.1 (WinBuild.160101.0800)
           Multi-User Windows IMM32 API Client DLL
[77B30000] C:\Windows\System32\profapi.dll
           6.2.17763.1 - 10.0.17763.1 (WinBuild.160101.0800)
           User Profile Basic API
[77B50000] C:\Windows\System32\RPCRT4.dll
           6.2.17763.1 - 10.0.17763.2920 (WinBuild.160101.0800)
           Библиотека удаленного вызова процедур
[77C10000] C:\Windows\System32\GDI32.dll
           6.2.17763.1 - 10.0.17763.1 (WinBuild.160101.0800)
           GDI Client DLL
[77C40000] C:\Windows\System32\cfgmgr32.dll
           6.2.17763.1 - 10.0.17763.1 (WinBuild.160101.0800)
           Configuration Manager DLL
[77C80000] C:\Windows\System32\imagehlp.dll
           6.2.17763.1 - 10.0.17763.1 (WinBuild.160101.0800)
           Windows NT Image Helper
[77CA0000] C:\Windows\System32\KERNEL32.DLL
           6.2.17763.1 - 10.0.17763.1 (WinBuild.160101.0800)
           Библиотека клиента Windows NT BASE API
[77D80000] C:\Windows\System32\kernel.appcore.dll
           6.2.17763.1 - 10.0.17763.1 (WinBuild.160101.0800)
           AppModel API Host
[77DA0000] C:\Windows\SYSTEM32\ntdll.dll
           6.2.17763.1 - 10.0.17763.1 (WinBuild.160101.0800)
           Системная библиотека NT
------------------------------------------------------------------------------
Active Controls hierarchy:
TListBox "DevListBox"
TUsagesForm "UsagesForm"
```

lazenyuk-dmitry, 2022-04-28:
Это короче жесть) Е..на рот этого казино) Иначе и не сказать.

Нашел решение на этом форуме каким то чудом)
https://stackoverflow.com/questions/53761417/createfile-over-usb-hid-device-fails-with-access-denied-5-since-windows-10-180

Установил эти обновления https://support.microsoft.com/en-us/topic/march-1-2019-kb4482887-os-build-17763-348-f7a9f207-0627-1fb9-cca7-29bb7b26027f для винды и все заработало. Я уже что только не делал) И по удалял все лишнее.

В общем теперь работает)

lazenyuk-dmitry, 2022-04-29:
> Какая у вас точно версия win 10, до номера сборки?

```
Название ОС:                      Майкрософт Windows 10 Pro
Версия ОС:                          10.0.17763 Н/Д построение 17763
Тип системы:                       x64-based PC
```

Вот какие обновления стоят:
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

KB4482887 - исправило проблему.

vsulako, 2022-04-29:
1) Если речь  о замене VID/PID и имени устройства, то это можно сделать, заменив значения в hardware/arduino/avr/boards.txt :

```
	leonardo.build.vid=....
	leonardo.build.pid=...
	leonardo.build.usb_product="..."
```
Вот [тут](https://cxem.net/mc/mc207.php) (в комментариях) я сделал прошивку для leonardo, для имитации Logitech G25, с драйвером. Была проблема что драйвер вставал со сложностями. И протокол обратной связи там был свой, я его частично реализовал но что-то он мне не очень понравился. Тогда стал делать этот вариант, уже под стандартный драйвер. Тем временем ту прошивку уже без меня доработали под энкодер, и устранили проблему с драйвером, ценой отключения com-порта.
2) Да можно было бы, в той прошивке как раз и был D-pad. Просто подумал что d-pad это же  такие же  4 кнопки, только данные о нем немного иначе передаются. А в играх кнопки все равно назначать, так какая разница - что  "кнопка N", что "Dpad влево". По крайней мере в ETS, а в другое я особо не играл :) Если надо, то можно бы добавить.

lazenyuk-dmitry, 2022-04-29:
> hardware/arduino/avr/boards.txt

Это где находится?

lazenyuk-dmitry, 2022-05-02:
Привет. Я тут поэкспериментировал.

Меняю VID PID название руля. Прошиваю прошивку которая эмулирует G25 и руль видит Forza Horizon 4 даже без драйверов видит. Пока не могу протестить обратную связь, жду запчасти. Интересно будет ли без драйверов работать. И так же руль видит Logitech Gaming Software но не видит твоя программа AFFBWheelGUI для конфига руля.

Затем все делаю так же но прошиваю твою прошивку AFFBWheel. Если поставить драйвера то Logitech Gaming Software видит руль и так же видит его AFFBWheelGUI но не видит руль FH 4 и с драйверами и без. Так думаю тут еще что то нужно изменить в прошивке. Ты можешь подсказать что? Я хотел бы добиться чтобы руль видела AFFBWheelGUI и FH 4 и протестить что будет с FFB.

Я еще нашел как вариант через эмуляцию контроллера XBOX360 можно в FH 4 на руле поиграть. Но тут тоже вопрос как будет работать FFB и вообще как будет управляться. Как все соберу конечно проверю.

Проблема в том что FH 4 если не распознает руль то и никак его настроить не дает. Например dirt 2, 3. Дает настроить руль в раскладке для клавиатуры. И FFB работать должен) Я играл давно в dirt на дешевом руле вибрация там работала)

lazenyuk-dmitry, 2022-05-02:
> 2) Да можно было бы, в той прошивке как раз и был D-pad. Просто подумал что d-pad это же такие же 4 кнопки, только данные о нем немного иначе передаются. А в играх кнопки все равно назначать, так какая разница - что "кнопка N", что "Dpad влево". По крайней мере в ETS, а в другое я особо не играл :) Если надо, то можно бы добавить.

Проверил в dirt на дешевом руле. Там если просто через реeстр поменять название руля на Logicool G25 Racing Wheel USB например то в настройках выбираешь руль и крестовина дает возможность перемещаться по пунктам в меню. Но все равно нужно через какой то Xpadder биндить ESC и ENTER чтобы полноценно рулем в меню управлять, ну тогда можно и крестовину забиндить) Разницы особо нет.

lazenyuk-dmitry, 2022-05-02:
я подменил wheelHIDDescriptor на тот который в G25Wheelenc проекте и тогда FH 4 видит руль. Но понятно что тогда AFFBWheelGUI не видит руль) Вот как бы изменить так дескриптор чтобы и там и там работало

lazenyuk-dmitry, 2022-05-02:
Ты можешь изменить дескриптор в файле [hidDescriptor.h](https://github.com/vsulako/AFFBWheel/blob/master/AFFBWheel/hidDescriptor.h) в своем проекте таким образом чтобы в свойствах контроллера появился Dpad пусть он не работает. Я хочу проверить не поэтому ли игра FH 4 не видит руль с твоей прошивкой. Просто можешь скинуть мне код или измененный файл? У меня не получается перестает определяться устройство.

Я пробовал удалить из проекта G25Wheelenc Dpad в дескрипторе, но у меня еще и кнопки пропали в свойствах) Но руль перестал в FH 4 определяться. Думаю возможно с Dpad ом он будет определяться и на твоей прошивке.

vsulako, 2022-05-02:
Добавил возможность включить крестовину, и заодно еще аналоговый шифтер и кнопки на резисторах.
Драйвер Logitech с этой прошивкой работать, по моему, не будет, у Logitech свой протокол обратной связи.
Тут лучше бы наверное найти другой известный руль поддерживаемый играми, с обратной связью по стандартному протоколу (который работает и без установки собственных драйверов) и представляться им.

lazenyuk-dmitry, 2022-05-03:
Спасибо!) Как появилась крестовина в FH 4 стал определяться руль подменой VID PID без установки драйверов) Пока под Logicool G25. Только пока не знаю будет ли FFB работать в таком раскладе, если что можно поискать другие VID PID рулей как вы и сказали.

У меня вопрос еще как рассчитывать `ENCODER_PPR` ? У меня должен быть 600 P/R это типа за один оборот. Но я вписывал 600 как то маловато. Я запутался `PPR` `PR`.

Смотрю прошивку допиливаешь) Люди интересуются. Не думаешь для донатов реквизиты оставить? Я думаю кто ни будь может поддержать копейкой.

mitiaborodada, 2022-05-03:
@lazenyuk-dmitry Дмитрий, я с тобой согласен! Это один из лучших открытых проектов, где автор любезно откликается и допиливает свою прошивку. Готов донатить! Так что, автор @vsulako, давай реквизиты.

vsulako, 2022-05-04:
PPR должно быть написано на самом энкодере.
Это количество импульсов одного датчика на один оборот, иначе говоря - количество щелей в диске энкодера.
Маловато - это как? При вращении руля на один оборот, насколько изменяется значение Raw? Должно примерно на 8тыс (8192).

насчет донатов - пока об этом не думал. Руль так-то делал для себя, сюда выложил просто на случай если кому будет интересно, или может коллективный разум чего умное посоветует. А какой сервис можно в нынешнее время использовать? просто номер карты - как-то стремно, да и менять ее скоро.

RockKenny, 2022-05-04:
> PPR должно быть написано на самом энкодере. Это количество импульсов одного датчика на один оборот, иначе говоря - количество щелей в диске энкодера. Маловато - это как? При вращении руля на один оборот, насколько изменяется значение Raw? Должно примерно на 8тыс (8192).
>
> насчет донатов - пока об этом не думал. Руль так-то делал для себя, сюда выложил просто на случай если кому будет интересно, или может коллективный разум чего умное посоветует. А какой сервис можно в нынешнее время использовать? просто номер карты - как-то стремно, да и менять ее скоро.

Наши сервисы:
https://www.donationalerts.com/
https://boosty.to/boostbg

lazenyuk-dmitry, 2022-05-04:
> А какой сервис можно в нынешнее время использовать?

В наше время не понятно немного) Ну я не думаю что тебе нужен прям для донатов сервис типа бусти. Думаю хватит каких нибудь Яндекс деньги. Ну Гугл думаю поможет выбрать.

lazenyuk-dmitry, 2022-05-27:
> найти другой известный руль поддерживаемый играми, с обратной связью по стандартному протоколу

Можешь помочь в этом вопросе? Что то я ничего такого найти не могу. Даже как загуглить не знаю)

Мои варианты не работают) Как логитек не работает отдача.

lazenyuk-dmitry, 2022-05-27:
Вот такое нашел. Наверно стоит попробовать сделать. https://gimx.fr/wiki/index.php?title=Main_Page
Должно работать вроде. Выдать можно руль за Logitech и не только.

vsulako, 2022-05-30:
С gimx как я понял нужно их устройство.
как будет время попробую поэкспериментировать с рулями из списка поддерживаемого форзой https://support.forzamotorsport.net/hc/en-us/articles/360001984148-FH4-Supported-Wheels-and-Devices надо бы найти их VID/PID. (вообще довольно странно, что симулятор поддерживает только определенный список рулей).
Есть еще мысль добавить в прошивку поддержку логитековской ОС, чтобы могло работать как G25. Но тут, возможно, придется пожертвовать ком-портом.

lazenyuk-dmitry, 2022-05-30:
Gimx можно собрать самом ещё. У них есть инструкция. Нужно Teensy 2.0 но он
дорогой. Дешевле на Arduino Leonardo или Pro Micro и ещё CP2102. Не так и
дорого выходит

пн, 30 мая 2022 г., 15:01 vsulako ***@***.***>:

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

lazenyuk-dmitry, 2022-05-31:
> Есть еще мысль добавить в прошивку поддержку логитековской ОС, чтобы могло работать как G25. Но тут, возможно, придется пожертвовать ком-портом.

Ну лишь бы потом ваш код не превратился в "ГОВНОКОД" из за кучи ифов и излишней нагруженности)

Я пишу только на Java Script) Опыта в плюсах и ардуино нету. Но вот думал может быть как то можно получать сигналы по протоколу логитека и скармливать той логике что у вас есть? Я потестил немного через Serial.print() если поменять vid pid на твоей прошивке, тогда все определяется как нужно и руль крутится в софте логитека и твоя прога работает для настройки. Но значения -16383..16383 не приходят. Вот может как то это поправить только можно. Тестил через [WheelCheck](https://www.beamng.com/threads/where-to-dl-wheelcheck-or-force-curve-modifier-without-registering-to-iracing-etc.56754/).

Кстати тестил прошивку под G25 опять же через WheelCheck и фидбек работает как с драйвером догитека так и без него.

lazenyuk-dmitry, 2022-05-31:
И опять же на лету я так понимаю не поменять pid vid придется прошивать или под G25 или нет. Если PID VID поменять то тогда не работает фидбек для твоей прошивки. Я так понимаю сразу по другому идут команды от пк.

vsulako, 2022-06-01:
Попробовал vid/pid от  других рулей - трастмастеры, фанатеки, логитеки. Похоже, что ОС по спецификации HID/PID никто не использует (кроме DIY проектов), у всех какой-то свой обмен данными. В лучшем случае было что форза видела руль и можно было управлять, но без ОС.

> как то можно получать сигналы по протоколу логитека и скармливать той логике что у вас есть

такая вот мысль и была, благо что логитековский протокол имеется и драйвер G25 более-менее работает.

lazenyuk-dmitry, 2022-06-01:
> В лучшем случае было что форза видела руль и можно было управлять, но без ОС.

У меня такой же результат.

vsulako, 2022-06-02:
Вот еще что есть: https://forzatools.weebly.com/
Правда, проверить не удалось - в FH4 из стима не помогает, а FH5 у меня не запускается.

lazenyuk-dmitry, 2022-06-02:
> Вот еще что есть: https://www.youtube.com/watch?v=29EQNUGKFFk

Я и думал найти эмулятор руля какой то... Но по этой теме нет ничего или я не нашел.

vsulako, 2022-06-04:
Таки сделал режим G25 отдельной [веткой](https://github.com/vsulako/AFFBWheel/tree/g25test). Пока для пробы.
Прописываем VID/PID 0x046D и 0xC299, устанавливаем драйвер версии 5.10. Обнаружится как неработающее устройство, ставим на него драйвер "Составное устройство", появится компорт и игровой контроллер. На контроллер может потребоваться поставить драйвер "Logitech G25 Racing Wheel USB (HID)" Логитековская панель в свойствах джойстика может не появиться, но это ничего, там все равно ничего интересного. FH4 видит, ОС есть.
логитековский протокол ОС транслируется в стандартные эффекты. там есть некоторые особые, но в реальности ни разу не видел чтобы они применялись.
Получаемые команды от ОС выводятся в компорт, можно посмотреть что там игры говорят.
GUI пока не работает. У G25 другой дескриптор без ReportID, скрестить не вышло. надо переделывать работу с GUI и
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

Thread 6 (2022-04-28):

H-Shifter with 2 wires

mitiaborodada, 2022-04-28:
Пытаюсь разобраться в коде (если честно не силён в этом), чтобы понять как можно использовать h-shifter на 2 провода.
У меня на выходе шифтера , при переключении передач,  образуется сопротивление, которое зависит от номера передачи.
Я пробовал в тестовых программах, использующие библиотеку joystic, ипользовать мой h-shifter. Там очень легко можно реализовать под мои нужды. В вашем коде, пока не понимаю как это сделать. Пока только понял, что нужно сделать изменения в AFFBWheel.ino в секции  "reading buttons".

vsulako, 2022-04-28:
Для начала понадобится пин с аналоговым входом. На promicro лишних нет, но на Leonardo есть еще три незадействованных. Например, пусть это будет A4.
Далее, пусть схема подключений условно такова:

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

Ваша может отличаться, но принцип одинаков.
При нажатии одной из кнопок напряжение на A4 меняется. Измерив его, можно узнать, какая из кнопок нажата.
Если нажато несколько кнопок, понять это будет сложно, но для КПП сойдет - там одномоментно нажимается только одна.
Если измерять это напряжение функцией analogRead(A4), получится примерно так:
1 кнопка - 720, 2 - 670, 3 - 600, 4 - 495, 5 - 330, ни одна кнопка не нажата - 1023. (вообще это можно просто взять и проверить отдельным скетчем)

теперь к коду.
Опрос кнопок проходит в функции readButtons.
Состояние кнопок хранится в виде битовой маски в переменной wheel.buttons, это 32-битное целое число.
Каждый бит означает одну кнопку, 1 - кнопка нажата, 0 - не нажата.
К концу выполнения функции состояние всех кнопок записывается в эту переменную.
У нас 5 кнопок, так что выделим под них 5 бит под номерами, скажем, 27-31.
Чтобы не заморачиваться, вставим наш код в самый конец функции и будем перезаписывать состояние кнопок новыми данными, вне зависимости от того что там прочиталось до этого. Антидребезг тоже будет игнорирован, ну да и ладно.

Так что, идем в самый конец функции readButtons, и добавляем чтение A4, выяснение какая кнопка нажата (добавим еще допуск плюс-минус 20) и установку соответствующих бит в wheel.buttons:

```
int val=analogRead(A4);
bitWrite(wheel.buttons, 27, ((val>700) && (val<740)));
bitWrite(wheel.buttons, 28, ((val>650) && (val<690)));
bitWrite(wheel.buttons, 29, ((val>580) && (val<620)));
bitWrite(wheel.buttons, 30, ((val>475) && (val<515)));
bitWrite(wheel.buttons, 31, ((val>310) && (val<350)));

```
Навскидку как то так. Для другого количества кнопок все будет аналогично.

mitiaborodada, 2022-04-28:
Ну как готовый... Сам делал))) 6 передач + задняя.
Спасибо за подсказку. Первая проба прошла почти удачно. Все кнопки работают, фиксируются, но при этом почему-то также срабатывают оси  Y и Z  При этом всё отключено - руль и педали.
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

vsulako, 2022-04-28:
Оси срабатывают, как раз потому что к ним ничего не подключено, Так они висят в воздухе и ловят каждый чих. Это нормально. Когда будут подключены, ничего такого не будет.

mitiaborodada, 2022-05-01:
Подключил все оси. Всё работает как надо! Спасибо за подсказку как сделать КПП на 2 провода.

mitiaborodada, 2022-05-09:
Оказалось, что у меня был комплекс проблем и главная из них БП. Он просто давал чудовищные шумы! Из-за этого аналоговые входы давали непредсказуемые значения. Когда заменил БП, то всё встало на свои места.

По данной схеме КПП у меня получились такие данные резисторов (может кому пригодится, кто будет делать такой же.): подтягивающий резистор - 10 кОм, резисторы на кнопках взял по 2.2 кОм. Работает идеально!

Closed 2022-05-01.

Thread 7 (2022-05-01):

Педали на датчиках AS5600

mitiaborodada, 2022-05-01:
На Arduino Leonardo с вашей помощью  удалось реализовать педали на датчиках AS5600.
При запуске программы AFFBWheelGUI всё работает как надо: руль, педали, кнопки.
Но, когда запускаю тот же ETS2, то в ней педали работают как кнопки - либо педаль включена, либо выключена.
Проверил и откалибровал в стандартной виндосовской настройке игровых устройств.  Тут тоже как и в  AFFBWheelGUI  всё настраивается и калибруется.
Но в игре не работает. Пробовал в игре BeamNG - та же история, что и в ETS.
В чём может быть проблема?

vsulako, 2022-05-02:
Очень странно. Если в свойствах контроллера Windows ось работает правильно, то и игры должны ее так видеть. Не знаю, в чем дело.
С шумом осей от мотора тоже не сталкивался. Питание мотора отвязано от питания контроллера? У меня контроллер питается от USB, а мотор от отдельного БП.

mitiaborodada, 2022-05-03:
Вот и мне странно. Проект затянулся, всякий раз вылазит новый баг :)  Контроллер питается от USB, мотор от своего БП.
Ещё помучаюсь и проверю как будет рнаботать на Arduino micro.
Сейчас основная проблема - это шум педалей и при подключении КПП постоянный дрейф на аналоговом входе, даже когда не включена ни одна передача. Должно быть значение 1023, а оно постоянно дрейфует.

vsulako, 2022-05-03:
А когда передачи включены, шум есть?
И если вместо AS5600 на педали подключить потенциометр, будет ли шум?

vsulako, 2022-05-04:
Если это только на аналоговом выходе, а цифровой в порядке - то можно его на ось руля применить.

Thread 8 (2022-05-01):

Обратная связь не работает (?)

mitiaborodada, 2022-05-01:
Приветствую!
Почему-то в играх не работает обратная связь. Т.е. она ка бы есть, руль при крайних положениях останавливается - мотор его удерживает. При столкновениях и каких-то неровностях тоже дёргается, но нет возврата руля, когда на скорости делаешь поворот. Колёса должны возвращать руль в прямое положение, но этого не происходит.
Есть идеи, почему так? Если бы обратная связь не работала, то всё остальное так же бы не работало.

vsulako, 2022-05-02:
Остановка руля на крайних положениях сделана независимо от команд обратной связи, игры ею не управляют.
Для проверки работы ОС можно использовать Fedit, ссылка есть в readme - там можно создать и запустить все доступные эффекты ОС.
В играх которые я пробовал, тоже не было этого эффекта возврата руля на повороте, как на реальном автомобиле. Сопротивление на поворотах было, тряска при столкновениях была, а возврата не было. Честно говоря, не знаю - то ли игры этого не умеют, то ли дело в чем-то другом.

lazenyuk-dmitry, 2022-05-03:
Я спросил в группе в ВК у ребят, они говорят что должен быть такой эффект как на реальном авто. Предполагают что проблема в прошивке.

@mitiaborodada в какой игре у вас проблема такая проблема? И вы можете это проверить на других прошивках? Я пока не могу этого сделать не все детали есть.
https://github.com/ranenbg/Arduino-FFB-wheel вот эта с открытым кодом, будет удобнее исправить если там все работает.
https://www.youtube.com/watch?v=aYYAbcPKN8g&t=6s а эта уже условно бесплатная, здесь в коде покопаться не получиться если что.

Если на этих прошивках работает все тогда проблема в прошивке. А возможно что то в настройках нужно покрутить.

mitiaborodada, 2022-05-03:
@lazenyuk-dmitry я проверял в ETS, BeamNG и TestDrive Unlimited, везде результат один и тот же.
На других прошивках пока не могу проверить, т.к. у меня нет обычного энкодера, есть только датчики AS5600.
https://github.com/ranenbg/Arduino-FFB-wheel  с этой можно попробовать, если удастся приспособить мои датчики.
Всё таки, думаю, что всё дело в прошивке. Прошивка vsulako меня вполне устраивает, но хотелось бы возврат руля после поворотов.  В любом случае спасибо @vsulako за открытый проект и что очень быстро отвечаете!

lazenyuk-dmitry, 2022-05-04:
Я тут немножко почитал по эффектам.

За возврат руля в положение в котором стоят колеса должен отвечать эффект `SPRING` или `DAMPER`. Больше по описанию похоже что SPRING должен возвращать руль в нужноное положение. Нужно проверить работу этих эффектов наверно.

@mitiaborodada  попробуйте сделать следующие.
- через [AFFBWheelGUI](https://github.com/vsulako/AFFBWheelGUI), на вкладке `Force Feedback` сделайте больше `Min Force`, `All` возможно появится нужный эффект и в игре можно эти настройки проверить.
- само собой [протестите эффекты](https://github.com/vsulako/AFFBWheel#testing-software)
- ну и можно поиграться с ползунками в настройках.
Возможно что то получиться.

@vsulako есть еще настройка, например у Logitech:
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
`centering spring` - я так понял это в играх где плохо работает FFB или не реализован возврат руля. То есть даже когда машина стоит на месте и ты поворачиваешь руль то он стремиться в центральное положение вернуться. Обычно ее не включают. Но реализовать можно, может в каких то играх понадобится.

https://support.thrustmaster.com/en/kb/107-en/#:~:text=A%20damper%20force%20controls%20how,on%20a%20spring%2Dmass%20system.
https://www.reddit.com/r/simracing/comments/9oqd7g/question_regarding_centering_spring/

vsulako, 2022-05-04:
Про эффекты.
Есть вот такой документ: https://www.usb.org/sites/default/files/pid1_01_0.pdf
Там вот как раз все об эффектах обратной связи, и как они должны описываться в HID-дескрипторе.
Таких эффектов придумали аж 12 штук.
Вот скажем CONSTANT - элементарно, игра просто говорит "нужно такое-то усилие в такую-то сторону" и все.
А вот RAMP - тут усилие должно в течение некоторого времени изменяться от одного значения к другому.
SINE - усилие изменяется по синусоиде с задаваемыми параметрами.
SPRING - усилие зависит от отклонения от некоторого условного центра, чем больше значение оси отклоняется от центра, тем больше возвращающее усилие, по линейной зависимости.
DAMPER - тут усилие зависит от разницы угловых скоростей, иначе говоря - чем больше скорость отклоняется от некоторой заданной, тем больше противодействующее усилие.
FRICTION - это должно ощущаться как трение, на практике - это усилие постоянной величины, всегда направленное против движения.
И игры должны давать команды устройству на управление этими эффектами, создавать их, удалять, изменять параметры.
В программе Fedit с этим прямо наглядно можно поиграться.

Ирония в том, что по сути, почти все эти эффекты не нужны.
Ну вот та же пружина. Ну хорошо, этот эффект возвращает ось в центр. А толку-то? В реальности все действует совсем не так.
Вот автомобиль стоит. Выворачиваем руль в сторону - он не возвращается. Теперь плавно нажимаем на газ - и только тогда колеса начинают испытывать сопротивление, выравнивающее их, что и передается на руль, когда он возвращается в центр. Такое усилие зависит от скорости движения, от свойств дороги (на льду, например, будет совсем не так как на асфальте, и если яма попадется - должно дернуть), и может еще от чего . На простой эффект возвращающей пружины это никак не походит. С остальными эффектами то же самое - они все синтетические.
Больше всего знает от том, что должно происходить с обратной связью, какое усилие должно возникать на руле - только сама игра. Только там можно все это просчитать правильно, учитывая все параметры.
Вот и выходит, что из всего набора эффектов игре по сути нужен только самый простой - CONSTANT. Чтобы игра могла получить данные о положении руля, и обратно сообщить, какое усилие создать. И все это как можно чаще, этак раз в миллисекунду. Быстродействия компьютера на это вполне хватит. И так можно проэмулировать вообще все эти эффекты.
BeamNG, к примеру, ровно так и делает. Это даже у них в справке написано. Так делает ETS2 последних версий - ранее там все еще использовались эффекты пружины и демпфера, а теперь - только CONSTANT.
Я это смотрел выводя все поступающие команды.

И потому совершенно непонятно, почему, например, в современном ETS2 нет этого эффекта возврата руля. Если хоть какие-то эффекты есть - должно работать все, потому что оно все делается через одну и ту же команду создания эффекта CONSTANT. Такое впечатление что игра этого не умеет.
Кстати, не помню, было ли так в BeamNG, там как мне показалось, самая продвинутая модель. надо попробовать.

насчет centering spring - это в драйверах заводских рулей бывает такая опция. Что можно включить дополнительный эффект возвращающей в центр пружины, которым игры управлять не будут. Обычно это советуют выключать, потому что этим должна командовать сама игра. А вообще оно существует для игр без обратной связи, чтобы получить эффект как на руле без ОС, с обычной пружиной для возврата.
В стандарте HID/PID ничего такого нет, и на совсем старые игры я и не рассчитывал, так что такого добавлять не стал.

Кстати, готового руля с ОС у меня никогда не было, я потому и начал делать свой :) Потому нет образца для подражания.
Я пробовал пару доступных тогда других прошивок - RFR Ai-Wave и EMC, и насколько помню, в ETS они действовали довольно похоже.

lazenyuk-dmitry, 2022-05-04:
У меня тоже нет руля с ОС) Сегодня пришли основные запчасти. Буду собирать)

RockKenny, 2022-05-04:
Проверил BeamNG на Logitech momo. Эффект выравнивания руля при движении есть. Если я правильно понял задачу. На стопе повёрнутый руль не выравнивается.

vsulako, 2022-05-04:
Да, сейчас опробовал - в BeamNG работает. На скорости руль сам старается выровняться, чем больше скорость - тем сильнее.

mitiaborodada, 2022-05-04:
> Да, сейчас опробовал - в BeamNG работает. На скорости руль сам старается выровняться, чем больше скорость - тем сильнее.

Т.е. на вашей прошивке возврат в центр на скорости работает? Видимо я в игре достаточную скорость не набирал. Всё пока тестирую на не закрепленных КПП, руле и педалях (((

vsulako, 2022-05-04:
В BeamNG - определенно. Хотя я там в настройках задрал для нее уровень.
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
А вот в ETS2 что-такое есть если выкрутить на максимум настройку "возврат руля на низкой скорости", будто бы пытается, но никак не может. Там еще есть "возврат руля на высокой скорости", и эта как будто даже не работает. Есть сопротивление на поворотах, но возврата не происходит.

mitiaborodada, 2022-05-04:
Ага, понятно! Настройки беру на заметку. Как только всё закреплю, тоже видео выложу. Есть что показать в плане механики)))  Много чего хочется реализовать, например, механизм автоматического отщёлкивания поворотников. Можно конечно готовый механизм использовать от каких-нибудь Жигулей, но это не наш метод) Но это уже другая тема.

mitiaborodada, 2022-05-30:
У меня ещё такой вопрос по обратной связи. В ETS2 и ATS, когда у грузовика заглушешь двигатель, то руль начинает дёргаться мелкой дрожью, даже. Это присходит, даже если после этого выйти в меню. Как только снова запускаешь движок, дрожь прекращается. Почему так, с чем может быть связано? Это только у меня?

lazenyuk-dmitry, 2022-05-30:
У меня так же в city car driving вроде. Попробуй в программе для настройки убавить эффект friction, он второй снизу. Я уменьшал процентов на 20 можно вообще вырубить попробовать. На emc прошивке так же у меня)

vsulako, 2022-05-30:
У меня вроде такого нет.

mitiaborodada, 2022-05-31:
А вот у меня вопрос-идея. Можно ли сделать искусственную "пружину" для тех игр, где нет возврата руля в центр, как например, в ETS2? Допустим по нажатию кнопки во время игры включать этот эффект.

lazenyuk-dmitry, 2022-05-31:
> А вот у меня вопрос-идея. Можно ли сделать искусственную "пружину" для тех игр, где нет возврата руля в центр, как например, в ETS2? Допустим по нажатию кнопки во время игры включать / отключать этот эффект.

А вот с этим фиксом можете проверить? https://github.com/vsulako/AFFBWheel/commit/c49b4807198ac339c320e7df1ce2ae53413ceba4

Возможно будет работать этот эффект.

Пружину в принцине можно сделать.. Но я думаю это не так прикольно будет.

Thread 9 (2022-05-23):

Помехи от отключенных осей.

lazenyuk-dmitry, 2022-05-23:
Привет. Я тут начал собирать базу. Планирую еще сделать КПП которую можно будет отключать и подключать. И у меня еще остается свободная одна ось. Я думаю вынести оставшиеся кнопки на КПП и ось как крутилку, может пригодиться. Но я так понимаю что я буду ловить помехи если не подключу КПП с этой осью? А оси отключаются только в прошивке или замыканием на минус? Можно ли что то с этим сделать? Или можно было бы возможность в GUI отключить оси.

vsulako, 2022-05-23:
да запросто. Можно в прошивке, можно замыканием на минус, а можно и в  GUI - просто поставьте для оси максимум равным минимуму и все.

Closed 2022-05-23.

Thread 10 (2022-05-28):

Подключение драйвера мотора

lazenyuk-dmitry, 2022-05-28:
Привет @vsulako, заполни что ли профиль на гите а то не знаем даже как тебя звать)

В общем потестил я еще прошивку EMC и был немного удивлен, руль стал более тугим, пропала пустота в центре, и в целом отдача стала лучше и мощнее в раза так 2-3. Стал лучше эффект возврата руля в центр, да и вообще руль более нагруженным стал, стало заметно тяжелее крутить руль когда машина стоит на месте. В Dirt 2 по гравию у меня на твоей прошивке руль работает как перфоратор) На EMC лучше стало. И вот решил я попробовать немного по экспериментировать со схемой подключения на твоей прошивке. И так подключаю я `-5 v` на контакты `L_EN` и `R_EN`, вместо подтяжки, и стал фидбек мощнее и приятнее как то как на EMC прям. Еще можно просто перекинуть резистор подтяжки с `GND` на `VCC` на драйвере мотора, если захочешь проверить, но мне так нравиться отдача больше.  Но есть нюанс, на твоей прошивки при таком подключении руль постоянно тяжелый, нагружен, а на EMC на рабочем столе или в настройках игры он легкий. Ниже расскажу почему так, ну я предполагаю) Но это не точно)

Вот как это выглядит на схеме EMC:
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

На схеме EMC есть провод от контакта `8` до контактов `L_EN R_EN` я думаю что в нем все дело. Я померял тестером и на контакте  `8` появляется +5V именно тогда когда должны включаться моторы, наверно поэтому руль свободный вне игры.
Ты можешь добавить такой же контакт в прошивку? Вроде еще есть свободные пины на плате? Просто попробуй выдавать +5V на L_EN и R_EN именно когда должны включаться моторы. Можешь это сделать в отдельной ветке? Я потестирую, да и ты тоже можешь, а потом смержишь в мастер ветку. Ну и попробуй так реально отдача мощнее и приятнее.

И вот еще момент... Есть эффект `Endstop` он отвечает за ограничение угла руля? Если я правильно понял) Так вот мне не хватает этого эффекта и он ведет как то себя странно. Я ставлю его до 200 процентов, например 150 и тогда становится чуть мощнее, но если ставлю выше, например 300-400 то тогда есть небольшой упор и потом руль прокручивается без усилия. Так вот можно ли как то этот эффект сделать мощнее? Я хотел бы более сильного ограничения в упоре.

У меня если что два мотора 775 остальное ка на схеме драйвер мотора  BTS  и Arduino Leonardo.

lazenyuk-dmitry, 2022-05-28:
Если есть вопросы пиши или в ВК.

lazenyuk-dmitry, 2022-05-29:
Я сделал вывод 5V на 5 пин когда включается отдача и стало работать как на EMC один в один. Эффект возврата руля в центр стал прям намного сильнее и теперь я думаю в  beamng drive не придется повышать настройки фитбека чтобы все работало. Может на неделе попробую сделать получше и сделать пул реквест.

vsulako, 2022-05-30:
> на контакте 8 появляется +5V именно тогда когда должны включаться моторы
Так у меня же это сделано электрически. Два диода и резистор рядом с BTS7960. Когда на одном из каналов PWM есть +5 - на L_EN/R_EN тоже присутствует +5, когда на обоих 0 - на EN тоже 0 и питание с мотора снимается. Как раз против постоянной "нагруженности", странно что у вас она есть.
Я пробовал управление через отдельный пин, но не понравилось то что руль становится "нагруженным" при любом значении ОС отличном от 0. Впрочем если надо то добавить несложно.

Эффект Endstop посмотрю.

> два мотора 775
интересно, как это механически сделано? оба мотора крутят один вал? Не получается ли так что один из них всегда халявит?

vsulako, 2022-05-30:
Добавил возможность задать пин для управления мотором (+5в когда усилие есть, 0 когда нет) в config.h (раскомментировать `#define MOTOR_ENABLE_PIN      5`) и поправил работу усиления эффектов.

lazenyuk-dmitry, 2022-05-31:
> поправил работу усиления эффектов

Спасибо стало лучше) Прокручиваться руль перестал в упоре.

lazenyuk-dmitry, 2022-05-31:
> Так у меня же это сделано электрически. Два диода и резистор рядом с BTS7960. Когда на одном из каналов PWM есть +5 - на L_EN/R_EN тоже присутствует +5, когда на обоих 0 - на EN тоже 0 и питание с мотора снимается. Как раз против постоянной "нагруженности", странно что у вас она есть.

Я это понял схему с диодами) Но когда напрямую подается питание на EN контакты тогда правда фидбек мощнее.
Если у вас как то получиться иначе решить это то было бы интересно. Наверно через диоды с контакта 9 и 10 не хватает питания на EN контакты.

lazenyuk-dmitry, 2022-05-31:
> Я пробовал управление через отдельный пин, но не понравилось то что руль становится "нагруженным" при любом значении ОС отличном от 0. Впрочем если надо то добавить несложно.

Так может так и должно быть?) Когда на месте машина стоит и крутишь руль он должен туго крутиться.

lazenyuk-dmitry, 2022-05-31:
> интересно, как это механически сделано? оба мотора крутят один вал? Не получается ли так что один из них всегда халявит?

Да тут все просто) Я так вот сделал.
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

Вроде не филонят моторы. Проверял по отдельности моторы в половину где то меньше по одному давят.

vsulako, 2022-05-31:
Ну это игра должна решать, насколько тяжело или легко должен крутиться руль. Рулю неизвестно, грузовик там в игре или велосипед, есть усилитель или нет :)
Я подумал что торможение при подаче питания на руль получается паразитное, и хорошо бы от него избавиться.
Ну вот при 0% все понятно - мотор надо выключить. При 100% - включить на всю. А если скажем игра говорит что нужно усилие 1% направо, она чего хочет? Наверное, очень слабое усилие вправо по сравнению с 0%.
Но из-за особенностей реализации получается что в нагрузку с 1% вращения направо остальные 99% периода ШИМ происходит торможение, которого нет при 0%. Должно ли быть так? Не знаю.

Насчет падения на диодах - не думаю, по даташиту BTS7960 у него цифровые входы, все что больше примерно 1.75в считается за 1.

lazenyuk-dmitry, 2022-06-01:
> Насчет падения на диодах - не думаю, по даташиту BTS7960 у него цифровые входы, все что больше примерно 1.75в считается за 1.

Я думал что там падение идёт. Я думал что там маловато напряжения.

А получается 5 пин это ШИМ? А можно ли как то не тупо 0 или 5В подорвать, а ШИМ сигнал?

vsulako, 2022-06-01:
>как то не тупо 0 или 5В подавать, а ШИМ сигнал

В теории можно (кроме случая когда применяется TLE5010, там на 5м пине выход тактового сигнала), только зачем? Попробовать сделать настраиваемую "тяжесть" руля?

lazenyuk-dmitry, 2022-06-01:
> В теории можно (кроме случая когда применяется TLE5010, там на 5м пине выход тактового сигнала), только зачем? Попробовать сделать настраиваемую "тяжесть" руля?

Да нет. Просто вы писали выше про паразитное торможение руля. Вот я и подумал может как то можно сделать интереснее а не подавать 0 или 5В.

Типа так как сейчас вы сделали на 5 пин подачу сигнала если есть усилие. Так вот возможно можно регулировать это усилие с помощью ШИМ сигнала? И прилагать усилие которое хочет игра.

vsulako, 2022-06-01:
Ну да, можно, это же еще один способ подключения BTS7960, когда есть только один канал ШИМ.
Тогда ШИМ подается на оба EN, а вот на L_PWM/R_PWM - напротив, подаются 0 или 5в без ШИМ в зависимости от требуемого направления. В этом случае мотор будет отпускаться в холостой части периода. Я так не пробовал, но по моему, будет то же самое что и в случае с диодами.

vsulako, 2022-06-01:
ну вот [измененный файл](https://github.com/vsulako/AFFBWheel/blob/altmotorpwm/AFFBWheel/motor.cpp), можно пробовать.  пин 5 на EN,  9 и 10 - на PWM.

lazenyuk-dmitry, 2022-06-01:
> ну вот [измененный файл](https://github.com/vsulako/AFFBWheel/blob/altmotorpwm/AFFBWheel/motor.cpp), можно пробовать. пин 5 на EN, 9 и 10 - на PWM.

Да все так как вы и говорили, работает как на диодах. Мне больше нравится вариант с питанием по 5 пину. И кажется это более правильный вариант. В Assetto Corsa так лучше чувствуется авто и легче управлять. А ещё если выключить ABS то когда давишь по тормозам на скорости, то руль становиться лёгким.

lazenyuk-dmitry, 2022-06-01:
А вот ещё момент небольшой. Когда в край выкручивает руль до упора с усилием, а endstop эффект стоит на 100%, то вроде все хорошо стопорит прям. А вот если выкручивает до упора с маленькими усилием, то руль как бы упирается а потом отскакивает назад и снова упирается и отскакивает, и снова, и это похоже на перфоратор) дребезжит в крайнем положении. Можно ли как то это сделать получше? Чтобы не было такого дребезга а держало руль.

lazenyuk-dmitry, 2022-06-02:
> Есть предположение.
> в основном файле, в строке 295 попробуйте поменять

Вроде помогло) Вы это добавите в мастер ветку?

Closed 2022-06-01.

Thread 11 (2022-05-31):

Программное отключение поворотников, используя обычные кнопки.

mitiaborodada, 2022-05-31:
Я тут сделал механизм отщёлкивания поворотников, поставил 2 кнопки, но они естественно работают не так как нужно, пришлось придумывать алгоритм. В этом деле не силён, но главное работает и алгоритм  себя отлично показал в игре.

Суть его проста. Когда включается поворотник, замыкается соответствующая кнопка. Когда при возврате руля кнопка отщёлкивается нужно, чтобы в игре поворотник выключился. Програмно реализовал повторное виртуальное кратковременное включение кнопки, чтобы отключить сигнал поворота. Автор, может моя идея понравится и реализуете данную функцию лучшим образом, чем я.

В начале файла AFFBWheel.ino поставил глобальные переменные:
bool wr = false;
bool wl = false;
bool flag = false;
int my_timer = 0;
bool Flag_RightSwitch = false;
bool Flag_LeftSwinch = false;

В файле AFFBWheel.ino в конце секции readButtons() прописал такой код:

bool RR = digitalRead(4)^1; //если включен правый поворот, то состояние = 1
bool RL = digitalRead(7)^1; //если включен левый поворот, то состояние = 1

if ((RR) && (flag==0) && (Flag_RightSwitch==0)) {
  flag = true;
  Flag_RightSwitch = true;
  my_timer = 0;
  wr = 1;
} else
 if ((RL) && (flag==0) && (Flag_LeftSwinch==0)) {

   flag = true;
   Flag_LeftSwinch = true;
   my_timer = 0;
   wl = 1;
 }

 if(Flag_RightSwitch){
  if ((flag)&&(RR!=1)){
    if(my_timer < 200){
      wr = 0;
    } else wr = 1;
  my_timer++;
  }

  if(my_timer >= 400){
    wr = 0;
    my_timer = 0;
    flag = false;
    Flag_RightSwitch = false;
  }
 } else

 if(Flag_LeftSwinch){
  if ((flag)&&(RL!=1)){

    if(my_timer < 200){
      my_timer++;
      wl = 0;
    } else wl = 1;
  my_timer++;
  }

  if(my_timer >= 400){
    wl = 0;
    my_timer = 0;
    flag = false;
    Flag_LeftSwinch = false;
  }
 }

bitWrite(wheel.buttons, 10, wr);
bitWrite(wheel.buttons, 11, wl);

lazenyuk-dmitry, 2022-05-31:
@mitiaborodada, вы можете сделать пул реквест. Тогда автору будет проще понять что вы сделали и где что написали. Так же он может там прокомментировать ваш код или улучшить, или даже принять ваши изменения. Это будет удобнее)

https://git-scm.com/book/ru/v2/GitHub-%D0%92%D0%BD%D0%B5%D1%81%D0%B5%D0%BD%D0%B8%D0%B5-%D1%81%D0%BE%D0%B1%D1%81%D1%82%D0%B2%D0%B5%D0%BD%D0%BD%D0%BE%D0%B3%D0%BE-%D0%B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

Информацию найти не сложно. Да и делается это тоже просто все.

vsulako, 2022-05-31:
Насколько понимаю, в механизме у вас кнопки поворота нажаты, когда рычаг поворотника находится в крайнем положении, когда возвращается в среднее - кнопки отпускаются.
А в играх поворотники включаются и выключаются кратким нажатием кнопки.
Так что вы имитируете короткое нажатие кнопки руля всякий раз как реальная кнопка нажимается или отпускается, так?

По моему, подобная функция есть в Joytokey и ей подобных программах.

mitiaborodada, 2022-06-01:
> Насколько понимаю, в механизме у вас кнопки поворота нажаты, когда рычаг поворотника находится в крайнем положении, когда возвращается в среднее - кнопки отпускаются. А в играх поворотники включаются и выключаются кратким нажатием кнопки. Так что вы имитируете короткое нажатие кнопки руля всякий раз как реальная кнопка нажимается или отпускается, так?
>
> По моему, подобная функция есть в Joytokey и ей подобных программах.

Да, совершенно верно - кнопка отпускается, после кратковременной паузы происходит короткое нажатие кнопки. Не стал использовать таймер с прерыванием (да и не силён в этом), а использовал обычный счётчик. Главное, что работает. Главное в настройках игры убрать галку автоматическое отключение поворотников.

Thread 12 (2022-06-10):

Потенциометры и группа для обсуждений

lazenyuk-dmitry, 2022-06-10:
Привет. У меня тут два вопроса есть.

1. Что можно использовать вместо дешевых потенциометров для педалей? Какие то магнитные датчики может? И может что то даже что было бы удобнее монтировать в педали. Или может какие то хорошие потенциометры можешь рекомендовать?

2. Ты не думал завести группу для обсуждений и тд? Думаю было бы нормально. У кого то может есть вопросы или сложности или какие то идеи интересные и не только по прошивке. И было бы еще интересно таким способом получать уведомления о каких то фиксах и новых фичах в прошивке. А то я смотрю ты много чего исправил, а я и не знаю) Мне лично нравиться то как группы в "телеграмм" работают, там и закреплять сообщения можно, что удобно было бы для каких то оповещений и тд. Ну и не создавать issues по мелким вопросам.

vsulako, 2022-06-10:
1. ну даже не знаю. У меня в педалях самые обычные потенциометры WH148 (да и сами педали от б\у руля, пробовал делать полностью свои - получилось неудобно). Понятно что скользящий контакт стирается и со временем будут работать хуже, но поменять их легко и стоят дешево. И монтировать удобно (хотя много зависит от конструкции педали)  - сверлим отверстие, вкручиваем, связываем с педалью через тягу или зубчатую передачу, все. Хотя все равно сложно рассчитать так чтобы использовать все 270 градусов поворота. Как то пробовал датчики Холла (OH49, SS495) - ничего, работают, тоже дешевые, потенциально вечные, подключаются прямо вместо потенциометров, но там больше требований к монтажу (отдельно магнит на оси закрепить, отдельно датчик, да чтобы зазор был одинаковый, да чтобы рядом ничего магнитного...) Вроде есть датчики Холла в виде крутилки, но чего-то очень дорогие. Еще тензодатчики есть (loadcell), могут замерять давление. Есть несколько штук, поигрался с ними, в планах добавить поддержку. Одни плоские - эти, похоже, можно прямо на педаль прикрутить под накладку и готово. Другие в виде бруска, работают на изгиб - но тут не знаю, как их в педаль вкрутить.
2. а вот прямо тут чего то такое есть: https://github.com/vsulako/AFFBWheel/discussions

lazenyuk-dmitry, 2022-06-10:
> 1. Еще тензодатчики есть (loadcell), могут замерять давление

Ну это на педаль тормоза актуально. И да можно добавить поддержку.

lazenyuk-dmitry, 2022-06-10:
> 1. да и сами педали от б\у руля, пробовал делать полностью свои - получилось неудобно)

Как сделаю свои попробую поделюсь чертежами если что)

mitiaborodada, 2022-06-10:
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

Я на педали поставил датчик AS5600 в режиме аналогового варианта, подключается как  переменный резистор. С корпусом не стал заморачиваться и использовал обычные крышки от пластиковых бутылок - датчики как раз отлично там сидят
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
.

lazenyuk-dmitry, 2022-07-18:
@vsulako, Все же думаю как бы сделать педали так чтобы они более плавно передавали сигнал. У меня педали на потенциометрах WH148. Так вот все же сложно задействовать весь оборот потенциометра, поэтому как то немного рвано выглядят показания с потенциометра. AS5600 крепить как то сложновато. Вот есть были бы решения типа ужу готовые на AS5600. Типа потенциометр но магнитный. И вообще может можно сопротивление потенциометра попробовать меньше или больше, чтобы более плавный сигнал получить?

lazenyuk-dmitry, 2022-07-18:
> 1. Как то пробовал датчики Холла (OH49, SS495)

А как вы их подключали и как можно установить на педали?

lazenyuk-dmitry, 2022-07-19:
@vsulako, спасибо. Все вроде понятно и без рисунков. Попробую заказать потенциометры на 180 градусов и SS49E. Поэкспериментировать.

Closed 2022-06-10.

Thread 14 (2022-06-27):

??

Brunno93, 2022-06-27:
wich version of delphi may i use to open GUI without errors? or, maybe you can create an exe program for calibrations

vsulako, 2022-06-27:
I used delphi 10.4.
complied exe are here: https://github.com/vsulako/AFFBWheelGUI/releases

Brunno93, 2022-06-28:
Many thanks, now i can adjust as i wish. i was using arduino IDE to adjust.
so, is it possible to add Multiplexers (ex: 4051) for buttons instead of HC165 (its difficult to find in my country) and a way to active, configure H_shifter on GUI.

vsulako, 2022-06-28:
With 4051 at least 7 pins are required to read 32 buttons, it seems too much.
What about ordering online? HC165 and MCP23017 are available worldwide on Ebay or Aliexpress.
also I think of adding support for i2c expanders PCF857x.
configuring h-shifter in GUI - you mean analog h-shifter? maybe sometime later.

Brunno93, 2022-06-28:
4051 was for example only, but there is 4067 that have 16 in/output pins.
yes, analog H-Shifter, its looks perfect for me in particular.
I'm trying to understand each peace of code, i was thinking in a way that the program auto detect if some components are attached or not, for example, Analog H-shifter, pedals (accelerator, brake and clutch)

vsulako, 2022-06-28:
Still, 4067 need 4 pins for addressing and 1 for input, that takes at least 6 pins for 32 buttons. My setup (with Promicro) even does not have so much free pins.
Sure, it can be done, but for me, shiftin registers and i2c expanders look way more convenient for buttons input.

I think autodetecting is not possible. Components are too simple to tell something like 'i'm here'. Analog input will measure voltage, no matter if it has potentiometer connected or not. Only difference - if nothing is connected, it will receive noise which is not reliably distinguishable from useful signal.

Thread 15 (2022-06-29):

HC165

lazenyuk-dmitry, 2022-06-29:
Привет. Я тут подключил кнопки пока только по 1линии (DATA1)

И они работают но не правильно. У меня постоянно нажата кнопка 9 а вместо кнопки 13(вроде бы 13) нажимается кнопка 1.
И перепутаны кнопки вместо кнопки 1 нажимается 2 и тд 2 это 3, 3-4, 4-5....

Я использую  `SN74HC165N`.
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

В чем может быть дело. Вроде собрано все правильно. Или у меня неправильный какой то HC165 но я нашел только такой.
Не охото все разматывать) Но вроде все правильно. Как будто смещены кнопки.

vsulako, 2022-06-29:
ой, похоже закралась ошибка. Обновил код, попробуйте теперь.

lazenyuk-dmitry, 2022-06-29:
Вот здесь https://github.com/vsulako/AFFBWheel/commit/4360836bd9587b872d9a16cf1384bb67b19e3e8c инпут лаг у кнопок начинается, в этом коммите.

vsulako, 2022-06-29:
странно. я лага не наблюдаю. и коммит этот никак с кнопками не связан...
а если загрузить настройки по умолчанию?

lazenyuk-dmitry, 2022-06-30:
У меня похоже как то выставился Debounce у кнопок, я не выставлял. Теперь все нормально) Спасибо.

Closed 2022-06-30.

Thread 20 (2022-08-01):

Совместимость с оптическим энкодером

Mozasvit, 2022-08-01:
Возможно ли, использовать в качестве энкодера родной оптический энкодер?

vsulako, 2022-08-01:
Родной - то есть от руля? насколько я знаю, там обычные энкодеры и используются, так что должно работать.

lazenyuk-dmitry, 2022-08-01:
@Mozasvit , не понятно немного, про что вы? Вы хотите оптический энкодер как в принтере использовать? На схеме энкодер тоже оптический. Принцып лишь бы был одинаков '+', '-' и фазы 'А' и 'В'.

Вот схема с энкодером от принтера но это из другого проекта. Но принцып тот же.

http://steeringwheel.aggress.ru/index.php?cmtx_sort=2&fl=electro

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

Mozasvit, 2022-08-01:
Здравствуйте, я не электронщик. Вот и интересуюсь. Нашел проект на странице мододелов Logitech MOMO.
В руле используется оптический энкодер,  а в описании оговариваются инкрементальные и магнитные.

vsulako, 2022-08-01:
Это разные свойства.
Есть инкрементальные, а есть абсолютные, отличаются тем что у абсолютных есть определенное нулевое положение, они сложнее, дороже, и подключаются тоже сложнее.
Скорее всего, у вас и есть инкрементальный оптический энкодер. У него должен быть диск со щелями, которые расположены в радиальном направлении - от центра к краям, без каких-либо мудреных рисунков. Количество этих щелей на диске - PPR энкодера. И 4-5 выходов: плюс, минус, и два-три датчика, скорее два чем три.

Mozasvit, 2022-08-01:
Так и есть!
Спасибо!

Closed 2022-08-02.

Thread 21 (2022-08-16):

Сдвиговые регистры.

Mozasvit, 2022-08-16:
Здравствуйте. Это снова я - неэлектронщик.

В инструкции написано брать 4 сдвиговых регистра 74hc165. На AliExpress продаются всякие разные. Взял sn74hc165n. Они подходят, или надо другие искать?

lazenyuk-dmitry, 2022-08-16:
@Mozasvit, у меня такие же. Все работает отлично.

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

Mozasvit, 2022-08-16:
Я собрал частичный макет схемы, но руль выдает какую то ахинею.

lazenyuk-dmitry, 2022-08-16:
Если интересно, я распаявал сразу на минус перемычку и сопротивления 10к сразу на регистре а потом припаявал провода. Так удобнее. Фото жаль нету.

lazenyuk-dmitry, 2022-08-16:
> Я собрал частичный макет схемы, но руль выдает какую то ахинею.

Какую?

Mozasvit, 2022-08-16:
Фото будет позже. Нет доступа.

Показания энкодера руля скачут как бешеные. Допускаю неправильное подключение его в схему, там немного иная цветовая маркировка.

Показания осей педалей скачут. Возможно из-за шума. Я подцепил для пробы только один потенциометр.

Но GUI приложение из описания говорит мне, что кнопки 25, 26 нажаты, хотя кнопки не подключались вообще.

vsulako, 2022-08-16:
> В инструкции написано брать 4 сдвиговых регистра 74hc165. На AliExpress продаются всякие разные. Взял sn74hc165n. Они подходят, или надо другие искать?

Если в названии есть 74hc165 - это все одно и то же: https://www.chipfind.ru/crossreference/search.htm?s=74hc165 (разница в производителе и в несущественных мелочах)
Но для неэлектронщика, наверное, было бы проще использовать I2c расширители - меньше соединений и меньше возможности что-то напутать.

Mozasvit, 2022-08-16:
С учётом времени на доставку китайцами, этот вариант я опробую не скоро.

vsulako, 2022-08-16:
С энкодером: попробуйте добавить подтяжки на линии A и B энкодера. (т.е. резисторы 1-10кОм, от A/B к +5в)
С осями: неподключенные оси будут ловить шум, а что с подключенной?
С кнопками: вы случайно не включили ли функцию аналоговых кнопок? (не раскомментировано ли `#define APB`) В файле конфигурации для примера как раз стоят кнопки 25 и 26.

Mozasvit, 2022-08-16:
Аналоговы кнопки в настройках вроде не  трогал.

Позже проверю все методы. Сейчас нет доступа к плате.

Потенциометр, подключенный к пину педали газа, не реагирует на прокручивания.

Mozasvit, 2022-08-16:
Ещё нюанс.
Я как истинный неэлектронщик развел плату для этого проекта.
Это могло сказаться на конечном результате

lazenyuk-dmitry, 2022-08-16:
> Ещё нюанс.
> Я как истинный неэлектронщик развел плату для этого проекта.
> Это могло сказаться на конечном результате?

Что значит "развел плату"?

lazenyuk-dmitry, 2022-08-16:
> Показания осей педалей скачут. Возможно из-за шума. Я подцепил для пробы только один потенциометр.

В GUI можно пока отключить не используемые оси. Там галочка ставиться. Чтобы не мешало.

Mozasvit, 2022-08-16:
Я - "нарисовал", китайцы - "распечатали".

lazenyuk-dmitry, 2022-08-16:
> Потенциометр, подключенный к пину педали газа, не реагирует на прокручивания.

Странно. Если можете покажите как подключили.

Mozasvit, 2022-08-16:
Все посмотрю когда прийду домой.
Спасибо.

Closed 2022-08-18.

Thread 25 (2022-09-11):

Что то не понятное с кнопками.

lazenyuk-dmitry, 2022-09-11:
@vsulako, привет. Я тут сделал КПП это кнопки с 17 по 32. Теперь при подключении КПП перестают работать кнопки на руле 9-16, работает только 16 кнопка а 15 кнопка тригерит кнопку 9... Вобще какая то дичь. После отключения КПП все нормально.
На на КПП у меня кнопки 17,19 и 18,20 это преключатели ВКЛ-ВКЛ. Теперь когда нажимаю 29 кнопку то все остальные отключаются, а при нажатии  кнопки 28 включается 29, 31, 32. Не понятно что то. Проблема с кнопками с 17 по 32. Что то с прошивкой или у меня?

vsulako, 2022-09-11:
Кнопки на регистрах HC165? Проверил у себя, ничего такого нет. Наверное, что-то в соединениях.

lazenyuk-dmitry, 2022-09-11:
> Кнопки на регистрах HC165? Проверил у себя, ничего такого нет. Наверное, что-то в соединениях.
>

Да на регистрах HC165... Странно. Вроде как то проверял было нормально.... Вроде бы.

lazenyuk-dmitry, 2022-09-12:
@vsulako я нашел баг. Смотри регистры работают по парно можно сказать. Баг проявляется если подключить все кнопки, то есть все 4 регистра. Проблема проявляется при постоянном зажатии одной, двух кнопок.

1. Подключите все 4 регистра все 32 кнопки.
2. На одном из регистров зажмите одну или две кнопки на постоянно.
3. На втором парном регистре понажимайте кнопки, при нажатии некоторых кнопок проявляется баг. То есть если зажали на постоянно кнопки 17-24 то при нажатии некоторых кнопок 25-32 будут глючить кнопки.

Если подключить только кнопки 1-16 то этот баг я не видел. Проверьте пожалуйста. У меня вроде последняя версия прошивки и GUI.

vsulako, 2022-09-12:
У меня не повторяется. Зажимаю 17-18, все 25-32 работают как ожидается, хоть по одной, хоть все вместе.
Проверьте нет ли плохого контакта на линии PL (ножки 1 на микросхемах, желтые линии на схеме) и на линии от ножки 10 первого регистра на ножку 9 второго (оранжевый цвет на схеме).
Возможны глюки, если второй регистр в цепочке отсутствует, но у вас как я понимаю все четыре на месте.

lazenyuk-dmitry, 2022-09-12:
А PL SCK никак не прозвонить мультиметром? Начал прозванивать провода, да вроде все нормально... Не понятно в чем дело.

vsulako, 2022-09-12:
К сожалению, мультиметром  разве что только прозвонить. А посмотреть что там происходит - это нужно осциллограф с памятью, а лучше логический анализатор.
Кнопки 1-16, когда подключены отдельно, работают правильно?

lazenyuk-dmitry, 2022-09-13:
Я вообще не понимаю в чём дело. Все правильно вроде.

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

Вот так вот все у меня распаяно на регистрах. Больше вроде и путаться нечему.

Все нормально работает но вот кнопки 25-32 ни в какую. Бесовщина какая то.

lazenyuk-dmitry, 2022-09-13:
> Кнопки 1-16, когда подключены отдельно, работают правильно?

1-16 все правильно... А не может быть то что у меня длинный кабель до КПП? 130 см кабель. Может конденсатор нужно больше припаять? Или что? Я уже не знаю.

lazenyuk-dmitry, 2022-09-13:
Попробовал конденсатор больше... Такая же фигня.

vsulako, 2022-09-13:
Да, 104 это 100нф. Его должно быть вполне достаточно.
Впрочем для проверки можно попробовать подключить проводами покороче.
Именно 25-32 не работают? А 17-24 как?
Попробуйте подключить заведомо рабочую цепочку, которые у вас сейчас на 1-16 на место 17-32, и посмотреть как будет работать. Вроде у вас там разъем на них есть так что это должно быть несложно.

lazenyuk-dmitry, 2022-09-13:
> Именно 25-32 не работают? А 17-24 как?

Да вот пока не трогаю 25-32 все нормально вроде. Например зажимаю 18-19 все норм. Жму 27 гаснут 18-19 и загораются 27, 29-30.

lazenyuk-dmitry, 2022-09-13:
> которые у вас сейчас на 1-16 на место 17-32

Это блин сложно будет... Я уже поменял регистры на 17-32 кнопках.

lazenyuk-dmitry, 2022-09-13:
Да нет... Вроде не может быть такого я уже и кнопки отпаял. Причем если кнопки 17-24 не трогать то 25-32 работают нормально...

lazenyuk-dmitry, 2022-09-13:
Поменял местами линии data1 и data2 результаты такие же только наоборот. Теперь глюки на кнопках 1-16

lazenyuk-dmitry, 2022-09-13:
> И впрямь непонятно.
> А посмотрите мультиметром, что на ногах у регистров когда это происходит.
> Зажать 18, 19, 27, чтобы 18-19 погасли и загорелись 27,29,30 и посмотреть какое напряжение на ножках соответствующих 18,19,27,29,30. По идее на тех кнопках что действительно нажаты должно быть 0, а на ненажатых около +5.  Вряд ли будет иначе но вдруг.

Да все так и есть как и ожидается...

vsulako, 2022-09-13:
Выходит, глюки привязаны именно к этой цепочке регистров, что-то там не так.
Насчет длины кабеля - непонятно. По идее не должно так быть, но надо пробовать, подключите проводами покороче.
Может, все разобрать и снова собрать? Поменяв местами регистры например

lazenyuk-dmitry, 2022-09-13:
Нашел я кажется в чем дело.... От части вы были правы... Это провод PL. Я кинул перемычку 20см от базы до КПП на PL линию и все вроде стало работать корректно.

Что делать?

vsulako, 2022-09-13:
То есть если подключить другими проводами то все работает? Может, с длинным кабелем что-то не так, один провод скажем перебит где-то?

lazenyuk-dmitry, 2022-09-13:
> То есть если подключить другими проводами то все работает? Может, с длинным кабелем что-то не так, один провод скажем перебит где-то?

Сомневаюсь.. я использую провода от интернет кабеля покупал в магазине. И я их уже звонил. Я только на PL сделал перемычку и все. Может не хватает мощи?

Щас прозвонил провод на PL все ок. Выходит дело в длине.

vsulako, 2022-09-13:
Странно что SCK работает а PL нет.  А сопротивления у всех жил одинаковые? она может звониться но иметь большое сопротивление. Если там есть запасные жилы можно другую взять, или несколько в параллель.
И еще непонятно почему глючит именно после нажатия кнопки.  Сопротивления резисторов на кнопках какие?

vsulako, 2022-09-13:
Проверьте заодно и эти резисторы, вдруг там какой бракованный попался.

lazenyuk-dmitry, 2022-09-13:
> Проверьте заодно и эти резисторы, вдруг там какой бракованный попался.

Проверял. На кнопках резисторы 8.9, 9.15, 10. Ну это я думаю погрешность. И норма. Наверно)

Провода жилы что PL что SCK 1ом сопротивление. Не в силах дело.

lazenyuk-dmitry, 2022-09-13:
Нельзя там просто подтяжку сделать? Или что?

vsulako, 2022-09-13:
Да попробовать можно, только не уверен что поможет. Еще один резистор 1-10к с PL регистра к +5в. Хуже быть не должно, во всяком случае.

lazenyuk-dmitry, 2022-09-13:
> Да попробовать можно, только не уверен что поможет. Еще один резистор 1-10к с PL регистра к +5в. Хуже быть не должно, во всяком случае.
>
> а так-то можно вообще обойтись без PL, поставив еще резистор, диод и конденсатор.

Блин ну кажется все работает. На 10к не помог а на 1к все пошло. Можно даже не на сами регистры а на линию PL прицепить подтяжку. А как подобрать сопротивление? Или это собо ни на что не влияет?

На SCK тоже можно подтяжку сделать? Я погугли немного вроде подтяжки можно и на PL и SCK сделать. Что то похожее находил. Можете это узнать? Если что можно ссылочку или картинку.

Я на днях буду все в порядок приводить.

Спасибо.

lazenyuk-dmitry, 2022-09-13:
И не плохо было бы добавить подтяжки в документацию.

vsulako, 2022-09-13:
Можно и на SCK. Точно так же - через резистор к 5в. Хуже не будет. С 1к работает - ну и ладно, чего там еще подбирать. обычно для сигналов годится что угодно в районе 1-50к (выше уже помехи может ловить, а ниже - потребление становится ощутимым)
Вообще я в недоумении. Подтяжки там не должны требоваться нигде кроме кнопок, выход ардуино должен без проблем справляться. Попробовал у себя на двухметровом кабеле - все работает. Правда, у меня регистры в SMD исполнении, но по моему разницы быть не должно. И PL с SCK сигнальные входы, потреблять должны самый мизер. Не понимаю.

lazenyuk-dmitry, 2022-09-13:
Я тоже не знаю почему так) но ещё все соберу с подтяжками и протестирую.

lazenyuk-dmitry, 2022-09-13:
Пишут вроде что на каких то регистрах есть внутри уже подтяжки) я хз я не сильно электронщик.

lazenyuk-dmitry, 2022-09-15:
У меня продолжается какая то фигня с кнопками.... Я уже не знаю что делать с ними. Подпаял подтяжки припаял кнопки. Глючат по прежнему. Половина кнопок нормально работает а половина гонит. Поэтому мне показалось что работают. Но на самом деле нет.

vsulako, 2022-09-15:
может, это микросхема? что если их поменять местами?

lazenyuk-dmitry, 2022-09-15:
Уже нету идей никаких

vsulako, 2022-09-15:
Одна цепочка работает а вторая нет.  надо искать чем вторая отличается от первой.
Подключить короткими проводами чтобы исключить влияние кабеля.
временно убрать второй регистр в цепочке, ногу 10 первого притянуть резистором к VCC. Должны работать первые 8 кнопок.
потом подключить второй регистр, без кнопок. все также должны работать первые 8, а вторые 8 - не работать.
потом по одной добавлять кнопки.

lazenyuk-dmitry, 2022-09-15:
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

А вротой регистр подпаять с подтяжками на кнопки?

vsulako, 2022-09-15:
Наверное лучше сначала без, а потом их постепенно добавлять. Тогда эти кнопки без подтяжек будут видеться как нажатые.

lazenyuk-dmitry, 2022-09-15:
Первый регистр в цепочке работает нормально. Подключаю второй на втором включены все кнопки. Тыкаю подтяжку на 3 ногу и все кнопки гаснут, на двух регистрах. И вообще как то второй регистр живёт своей жизнью.

lazenyuk-dmitry, 2022-09-15:
Вообще все как гирлянда мигает на втором гегистре

vsulako, 2022-09-15:
А есть возможность заменить второй полностью? вместе с резисторами, проводами - чтобы все другое?

lazenyuk-dmitry, 2022-09-15:
> А есть возможность заменить второй полностью? вместе с резисторами, проводами - чтобы все другое?

Да. Но я его менял до этого в паре с первым. Почему то даже просто пальцами до ножек дотрагиваясь начинается какая то не понятная фигня.

vsulako, 2022-09-15:
Без подтяжек реагирование на пальцы - это нормально, для того там подтяжки и нужны.

lazenyuk-dmitry, 2022-09-15:
Все так же и с другим регистром. Только цепляю подтяжку на 3 ногу. Гаснут пару кнопок на втором регистре и те что были включены на первом тоже гаснут. Бесовщина какая-то.

vsulako, 2022-09-15:
А до этого первый регистр и другая цепочка работают как положено? отрабатывают все кнопки в любых комбинациях
и только после того как прицепляется подтяжка ко второму регистру, даже без нажатия соответствующей кнопки начинаются глюки?

lazenyuk-dmitry, 2022-09-15:
> А до этого первый регистр и другая цепочка работают как положено? отрабатывают все кнопки в любых комбинациях
> и только после того как прицепляется подтяжка ко второму регистру, даже без нажатия соответствующей кнопки начинаются глюки?
>

Да все регистры кроме последнего работают хорошо. Постедний даже если без подтяжек подключить и проживать на остальных кнопки, то на последнем мигают кнопки. Но остальные при этом работают отлично.

vsulako, 2022-09-15:
Очень странно. С подтяжками что-то не так, что ли?
Ну а если его подключить без подтяжек и на входы для кнопок подавать GND или VCC?
GND должно включать соответствующую кнопку а VCC гасить. Остальные кнопки на нем могут моргать, но та к которой подключается - должна работать, и не влиять на кнопки на других регистрах.

lazenyuk-dmitry, 2022-09-15:
> Очень странно. С подтяжками что-то не так, что ли?
> Ну а если его подключить без подтяжек и на входы для кнопок подавать GND или VCC?
> GND должно включать соответствующую кнопку а VCC гасить. Остальные кнопки на нем могут моргать, но та к которой подключается - должна работать, и не влиять на кнопки на других регистрах.

То же самое. Подаю vcc так же отрубает кнопки другого регистра. Без понятия что делать.

vsulako, 2022-09-15:
Я тоже...
Эксперимент: отсоединить от второго регистра поочередно PL, SCK  и ту что идет к 9й ноге. Будет ли также отрубать кнопки у первого?

lazenyuk-dmitry, 2022-09-15:
Смотри... Почему то иногда нормально работает второй регистр, а  иногда глючит, как будто зависит от того как его держишь. Как будто какие то помехи.

И есть такой глюк гадание 29-32 тригерит 25-28, то есть нажатие 29 так же нажимает 25 и так далее. Как будто один ряд на регистре тригерит второй. А иногда все нормально работает. Что такое не понимаю.

lazenyuk-dmitry, 2022-09-15:
То вообще на втором регистре часть кнопок не срабатывает то работает. Не понимаю нифига в чем проблема. Может какие помехи ловит?

lazenyuk-dmitry, 2022-09-15:
Я не совсем разобрался но там вроде бы есть вроде как цикл который опрашивает регистры. Так вот я читал что стоит делать паузу в опросах небольшую 40мс где то чтобы фильтровать помехи то ли что. У вас это реализовано? Я просто не знаю уже в чем дело.

vsulako, 2022-09-16:
Если зависит от того как держать то это похоже на плохой контакт.
Паузы там вообще ни к чему. Это разве что против дребезга на кнопках, но тут явно не то.  У меня работает без пауз, да и у вас три из четырех работают. Очевидно же что проблемный этот четвертый. Если бы была проблема в коде - она проявлялась бы на обеих цепочках. Ну или не переезжала бы при замене цепочек местами.
Пересоберите всю эту часть заново из всего нового, включая провода. Есть же первая цепочка которая работает правильно, вот точно такую же надо сделать вторую. Конденсатор можно пока убрать.

lazenyuk-dmitry, 2022-09-16:
В чем может быть дело? Я дотрагиваясь до провода PL и все работает тогда.

lazenyuk-dmitry, 2022-09-16:
Блин похоже что дело в кабеле. У меня кабель от интернета и концевики RJ45, кабель 8 жил проволоки медной. Заменил на кабель от usb простой. И все работает. Ну и он по короче. Что получается что кабель не подходит почему то? А у меня так все хорошо складывалось на этих кабелях и разъёмах... Обидно... Теперь что то переделывать нужно. На интернетовской кабеле работают педали и ручник нормально и остальные оси тоже. У вас какой кабель используется? Мне нужно 8 жил на КПП.

lazenyuk-dmitry, 2022-09-16:
Ты можешь объяснить почему на витой паре не работает а с обычным usb кабелем работает? Я не понимаю... Вроде провод да провод чего такого...

lazenyuk-dmitry, 2022-09-16:
Странно... Если по два провода витой пары пустить на PL SCK DATA вместо одного то тоже все работает.

Я даже так предполагаю что хватит два провода только на PL и все будет работать. Может у тебя есть идеи по этому поводу) дичь какая то.

vsulako, 2022-09-17:
У меня кабель телефонный плоский, КСПВ 4х0.4, и телефонные разъемы RJ12.
Восьмижильная витая пару UTP5 показалась слишком жесткой.
Причин чтобы на UTP5 не работало не вижу вообще никаких. Кроме подозрений что одна из жил повреждена.

lazenyuk-dmitry, 2022-09-17:
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

Я уже менял провод. Оно то работает но глючит.

lazenyuk-dmitry, 2022-09-18:
Вообще интересно как то... Подключаю DATA и PL на одну пару, то есть голубой и бело-голубой. И у меня глючат кнопки но стоит только перенести подключение на разные витые пары так все отлично работает. Это какие то помехи?

lazenyuk-dmitry, 2022-09-18:
Я тут уже начал фигнёй страдать. Подрубаю сопротивление 1к 10к в разрыв линии PL и все работает. Ещё можно и на DATA кинуть в разрыв сопротивление. Я не понимаю почему но работает. Думаю даже так и оставить.

Василий, может быть напишем научную работу по дичи с витой парой? 😄

lazenyuk-dmitry, 2022-09-18:
Короче установил сопротивление 1к в разрыв PL, все собрал и все работает. Странно. Очень интересно но ничего не понятно.

Подскажи форум электронщиков где можно задать такой вопрос. Интересно есть ли разумное объяснение этому.

vsulako, 2022-09-18:
Мне тоже непонятно. Посмотреть бы что там происходит, но нечем. И сам потыкать не могу.
форумы.. ну наверное radiokot.ru easyelectronics.ru cxem.net

lazenyuk-dmitry, 2022-09-18:
Пробовал играть в Assetto Corsa с КПП все отлично Буг ушел. В разрыв сопротивление 1к на PL.

Closed 2022-09-18.

Thread 26 (2022-09-14):

Подключение двух двигателей на один вал.

lazenyuk-dmitry, 2022-09-14:
@vsulako Василий снова привет) я что то задался все же вопросом правильно ли я подключил два двигателя. У меня просто они смотанны параллельно и подключены к BTS. Вопрос, работают ли они на полную? Как это можно проверить? И может быть есть варианты подключения более грамотные? Например драйвер мотора с выходами на два двигателя?

Наверно можно замерить ампераж или что на моторах под нагрузкой?

lazenyuk-dmitry, 2022-09-14:
Было бы хорошо если можно снять больше мощности с моей конструкции)

vsulako, 2022-09-14:
К сожалению, тут не могу сказать, не знаю. У меня двигатель один и тот слабый. По моему, параллельного подключения достаточно. Не думаю что BTS чем-то может ограничивать.
Ну можно наверное сравнить как работает с BTS и если напрямую подключить моторы к БП. Измерить ток через каждый мотор.

lazenyuk-dmitry, 2022-09-15:
Кстати, я заказывал вот здесь.

https://sl.aliexpress.ru/p?key=g8CNF2

3000 оборотов 24В блока питания на 10А вроде хватает, все работает. Вышло не дорого два мотора.

Говорят вроде лучше брать меньше оборотов для руля.

vsulako, 2022-09-15:
Меньше оборотов - видимо, чтобы не городить чересчур большой или многоступенчатый редуктор.
Судя по табличке в описании, 775 на 24в под обычной нагрузкой жрет 2А, а в пике при заблокированном роторе -13А. Как в реальности - неизвестно.
Получается в пике 26А на два двигателя, БП может не вытащить, да и контакты на BTS поплавиться могут.
Может, имело бы смысл добавить еще один такой же БП, и заодно еще один BTS, по одному на каждый двигатель.
Еще тут вопрос - возможно ли будет удержать такой руль, он еще вырвется да чего-нибудь поломает, ладно если свой вал, а если пальцы?

Вообще это тема для исследований - два мотора на один вал.
https://electronix.ru/forum/index.php?app=forums&module=forums&controller=topic&id=122546#comments
Вроде как при этом один мотор получается ведущий а другой ведомый, и часть мощности может теряться.
Зачем-то предлагают добавлять подбираемое сопротивление на один из двигателей, или соединять их последовательно. Даст ли это что-нибудь - не знаю.

lazenyuk-dmitry, 2022-09-18:
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

Скорее всего советую последовательно подключить потому что для последовательного соединения I=I1=I2 то есть типа сила тока на каждом моторе должна быть одинаковая и максимальная, в теории. Но напряжение делиться U=U1+U2.

Ну вроде у меня, ни блок, ничего не греется, ни соединения. Думаю ничего пока делать не буду. Ну я смотрел вроде таблицу для двигателя 3000 оборотов 24В там 3.2А потребление. Поэтому блок на 10 взял. Да и большее что я нашел это блок на 10А я взял модель блока типа от ноутбука чтобы все компактно и аккуратно было.

Closed 2022-09-20.

Thread 27 (2022-09-20):

База директ драйв с мотор колесом от гироскутера.

Iurii-Dolgorukii, 2022-09-20:
Добрый день. Перейду сразу к делу)))
Собрал базу ДД использовав мотор колесо от гироскутера. Работает, вроде не плохо. Но у меня две платы стм, на одной прошивка ВНМ, другая управляет мотором. Управляющий сигнал аналоговый, имеет много шумов, да и не хорошо это, два мк тратить на это дело.
Вопрос в следующем:
-Можно ли эту прошивку применить на стм32? (для тестов имеется Ф401, 407, 411. Ф103с8т6).
-если убрать из прошивки все оси, алгоритм управления бтс, оставив только ось руля, на сколько меньше памяти в ардуино она станет занимать? (библиотека, которую я применил для бк мотора, занимает тоже много места).
ну и кратенькое видео)))
баранка блютуз, с есп32
https://youtu.be/760Q2IoW_f8

vsulako, 2022-09-20:
- на STM32 не получится.
- думаю, можно освободить минимум треть флеша(около 10к), а может и больше.

Iurii-Dolgorukii, 2022-09-20:
А можете подсказать, где именно распологаются данные для направления руля? Я не силён в программировании, по этому сложно разобраться, что именно в Вашей прошивке я должен оставить))

vsulako, 2022-09-20:
Что такое - данные для направления руля?

Вот тут: https://github.com/vsulako/AFFBWheel/blob/master/AFFBWheel/AFFBWheel.ino

В строке 224 начинается основной цикл.
Данные о положении руля передаются в строке 246 -  `wheel.axisWheel->setValue(GET_WHEEL_POS);`
(GET_WHEEL_POS определяется ранее в зависимости от используемого датчика положения)
`readAnalogAxes();` и `readButtons();` - это опрос других осей и кнопок, можно убрать.
`processUsbCmd();` - работа с GUI.
Из важного остается `wheel.update();` - это обмен данных по USB с компьютером, и `processFFB();` - обработка обратной связи.
Далее  `processSerial();` - обработка команд из компорта.

Управление двигателем находится в https://github.com/vsulako/AFFBWheel/blob/master/AFFBWheel/motor.cpp

vsulako, 2022-09-20:
Что у вас за библиотека для мотора?

Iurii-Dolgorukii, 2022-09-20:
Мне сложно сформулировать.
для управления мотором у меня переменная (int S;), максимальное усилие равно -50/50. вращение влево/вправо.
[code]
    motor.move(S);

[/code]
можно из вашего кода получить информацию подобного рода?))

Iurii-Dolgorukii, 2022-09-20:
но может возникнуть проблема с энкодером наверно, этой библиотеке как и вашей он нужен. Возможен кофликт?

lazenyuk-dmitry, 2022-09-20:
@vsulako, у него библиотека для управления мотором эта https://simplefoc.com/ она поддерживает STM и говорит там она всего 20 процентов а на ардуино 70 вроде занимает.

Я нашел такую библиотеку, кто то перенес библиотеку для ардуино на СТМ, https://github.com/billydragon/STM32_FFBJoystick думаю можно по быстрому склепать из двух библиотек прошивку)

Вожножно можно договориться с Василием если ему это интересно)

Iurii-Dolgorukii, 2022-09-20:
спасибо, буду пробовать)

vsulako, 2022-09-20:
> Возможен кофликт?
С бесколлекторными двигателями не работал, но как я понимаю, там нужно знать абсолютное положение оси руля?
Возможно, придется чтото переписывать.
Может, будет проще взять за основу нечто вроде вот этого? https://github.com/YukMingLaw/ArduinoJoystickWithFFBLibrary

lazenyuk-dmitry, 2022-09-20:
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

Эта библиотека как раз есть под СТМ я кинул ссылку выше.

Iurii-Dolgorukii, 2022-09-20:
при первом включении контроллер вращает двигатель параллельно считывая энкодер, для определения электрического угла. Далее работает по командам.

Iurii-Dolgorukii, 2022-09-20:
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

она выглядит вроде просто, но куда энкодер подключать?)) игре он ведь нужен

Iurii-Dolgorukii, 2022-09-20:
> Что у вас за библиотека для мотора?

https://simplefoc.com/

lazenyuk-dmitry, 2022-09-20:
> она выглядит вроде просто, но куда энкодер подключать?)) игре он ведь нужен

Наверно через библиотеку. https://github.com/bubulindo/STM32Encoder типа этой.

lazenyuk-dmitry, 2022-09-20:
И кстати если у вас получиться можно выложить проект на гитхаб. Будет полезно.

Iurii-Dolgorukii, 2022-09-20:
Попробую как и раньше, методом тыка))))
Если будут идеи, то мой стенд всегда готов к испытаниям. Микроконтроллеры тоже

vsulako, 2022-09-20:
> она выглядит вроде просто, но куда энкодер подключать?)) игре он ведь нужен
Это же только основа. Энкодер или другой датчик надо добавлять вручную, там есть примеры.

Хотя наверное все равно ничего не выйдет. Попробовал собрать минимальный скетч с библиотекой SimpleFOC - заняло 89% флеша. Не влезет.

lazenyuk-dmitry, 2022-09-20:
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

Это на ардуино? А у тебя нету СТМ?

Iurii-Dolgorukii, 2022-09-20:
На стм бы влезло я думаю...

vsulako, 2022-09-20:
Вот с STM к сожалению не знаком. Валяются пара F103С8T6, но пока до них не добрался чтобы поизучать :(

Iurii-Dolgorukii, 2022-09-20:
> И кстати если у вас получиться можно выложить проект на гитхаб. Будет полезно.

Это разумеется

Iurii-Dolgorukii, 2022-09-20:
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

А что значит минимальный?
Simplefoc считывает энкодер, у ребят надо спросить, может можно вывести данные энкодера, чтобы не подключать ещё одну библиотеку

vsulako, 2022-09-20:
> А что значит минимальный?
Только то что описано тут: https://docs.simplefoc.com/code
и то пришлось убрать датчик тока.

lazenyuk-dmitry, 2022-09-20:
Я попробую что нибудь написать под СТМ на библиотеках) правда никогда не писал на плюсах. Ну может быть что то получиться с библиотеками. Стало чёт интересно поковыряться)

Просто если что можно объединить усилия если кто то тоже думает склепать проектик)

Iurii-Dolgorukii, 2022-09-20:
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

Там если за комментировать все строчки связанные с serial Port, то можно немного памяти сэкономить

Iurii-Dolgorukii, 2022-09-20:
У меня занимает 74 процента.

vsulako, 2022-09-20:
> Там если за комментировать все строчки связанные с serial Port, то можно немного памяти сэкономить

```
#include <SimpleFOC.h>

BLDCMotor motor = BLDCMotor(11, 9.75);
// Encoder(pin_A, pin_B, PPR)
Encoder sensor = Encoder(2, 3, 2048);
// channel A and B callbacks
void doA(){sensor.handleA();}
void doB(){sensor.handleB();}
// instantiate motor
BLDCDriver3PWM driver = BLDCDriver3PWM(9, 5, 6, 8);

// instantiate sensor
// instantiate current sensor
//InlineCurrentSense current_sense = InlineCurrentSense(0.01, 50, A0, A2);

void setup() {

    sensor.init();
  // hardware interrupt enable
  sensor.enableInterrupts(doA, doB);

  //current_sense.linkDriver(&driver);
  // init current sense
  //current_sense.init();

  // init sensor
  // link motor and sensor

// pwm frequency to be used [Hz]
  driver.pwm_frequency = 20000;
  // power supply voltage [V]
  driver.voltage_power_supply = 12;
  // Max DC voltage allowed - default voltage_power_supply
  driver.voltage_limit = 12;
  // driver init
  driver.init();

  // link motor and driver
  // link driver and the current sense

  // link motor and current sense
  motor.linkSensor(&sensor);

  // init driver
  // link the motor to the driver
  motor.linkDriver(&driver);
  // link driver and the current sense

  // link the motor to current sense
//  motor.linkCurrentSense(&current_sense);

  // set control loop type to be used
  motor.controller = MotionControlType::velocity;
  // initialize motor
  motor.init();

  // init current sense

  // align encoder and start FOC
  motor.initFOC();
}

void loop() {
  // FOC algorithm function
  motor.loopFOC();

  // velocity control loop function
  // setting the target velocity or 2rad/s
  motor.move(2);
}
```
Вот это я собирал. Энкодер, мотор, драйвер, больше ничего. И все равно 89%.
Оно конечно можно вынести все это в отдельную ардуину и с ней как-то общаться, но у вас и сейчас как я понимаю то же самое.

Iurii-Dolgorukii, 2022-09-21:
Да, тоже самое. Но через analogRead. А он шумит зараза. В нулевой точке нет отключения драйвера стабильного. Мотор дрожит. А если канал отключения драйвера исключить, то тяжело вращать мотор. Так как мосфеты нижних плечей открыты и обмотки мотора между собой замкнуты

Iurii-Dolgorukii, 2022-09-21:
А вы можете из прошивки вашей исключить всё лишнее, сколько она интересно займёт

Iurii-Dolgorukii, 2022-09-21:
Кстати я датчик тока не использую, я подобрал значение в Limit. voltage при котором максимальное потребление не привыкает 4 ампера. У меня бп при 4,5 в защиту уходит))))

Iurii-Dolgorukii, 2022-09-21:
Кстати я датчик тока не использую, я подобрал значение в Limit. voltage при котором максимальное потребление не привыкает 4 ампера. У меня бп при 4,5 в защиту уходит))))

Iurii-Dolgorukii, 2022-09-21:
// pwm frequency to be used [Hz] driver.pwm_frequency = 20000;
На ардуино частота фиксированная, эта строчка не сработает

vsulako, 2022-09-21:
> Да, тоже самое. Но через analogRead. А он шумит зараза. В нулевой точке нет отключения драйвера стабильного. Мотор дрожит. А если канал отключения драйвера исключить, то тяжело вращать мотор. Так как мосфеты нижних плечей открыты и обмотки мотора между собой замкнуты

Хм. А зачем через analogRead? Прошивка с контроллером закрыта и приходится тупо измерять что она выдает на канал управления двигателем? Что такое прошивка ВНМ мне чего-то найти не удалось.
По идее если на выходе сигнал ШИМ, то можно его анализировать и получать более точное значение.

> А вы можете из прошивки вашей исключить всё лишнее, сколько она интересно займёт

могу, но это надо повозиться. Мне кажется даже если оставить только самое основное, будет не меньше 35-40%.
Но вариант с двумя контроллерами мне кажется можно было бы сделать. Со связью не аналоговым сигналом а скажем через SPI. Туда значение усилия для мотора, обратно данные с энкодера. Второй контроллер может быть каким-нибудь Uno или Nano - для них кстати SimpleFOC меньше получается, около 70%.

vsulako, 2022-09-21:
Ориентировочно:
Если оставить только ось руля и ОС - получается около 45%.
Если еще порезать ОС до одного эффекта - около 35%
В лучшем случае, думаю, еще до 30% можно довести.

Iurii-Dolgorukii, 2022-09-21:
Да, прошивка закрыта.
https://github.com/hoantv/CarSimulatorFirmware
Я не знаю, получится ли получить точные значения не теряя в скорости. По выходному pwm работает у меня

vsulako, 2022-09-21:
Зависит от частоты. Будет задержка в один период, т.к. определить значение можно только после окончания периода. И чем выше частота, тем больше будет потеря в точности.

lazenyuk-dmitry, 2022-09-21:
> могу, но это надо повозиться. Мне кажется даже если оставить только самое основное, будет не меньше 35-40%.
> Но вариант с двумя контроллерами мне кажется можно было бы сделать. Со связью не аналоговым сигналом а скажем через SPI. Туда значение усилия для мотора, обратно данные с энкодера. Второй контроллер может быть каким-нибудь Uno или Nano - для них кстати SimpleFOC меньше получается, около 70%.

Может быть это разумнее решение будет? Если что то новое пилить это много очень работы будет. Плюс еще бы хорошо сделать GUI для всего этого дела. А тут все готовое. Тем более если Василий готов помочь. Это только написать проект для управления двигателем получается нужно? Ну и допилить прошивку AFFBWheel чтобы она могла взаимодействовать со вторым МК? Так получается? И это наверно будет лучше. Уже есть готовый проверенный проект, оттестирован.

@Iurii-Dolgorukii И что у вас с педалями? Они не они работают как отдельное устройство? Кнопки на руле я так понимаю работают отдельно от базы?

Чтобы для STM что то годное делать научиться это наверно только учиться пол года нужно) Так что вот такие мои мысли. Это будет надежнее, две платы ардуино и нормальное общение между ними реализовать, и получите все фишки и плюшки данной прошивки и так же какие то обновления и какаю никакую поддержку.

Если урезать прошивку все равно не поможет то и не нужно)

Iurii-Dolgorukii, 2022-09-21:
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

Ну оно у меня так и работает на двух мк. Педали, кнопки на руле это не проблема, можно отдельно на про микро реализовать. В управлении двигателем ничего допиливать не надо, библиотека работает из коробки)))
Ей точные данные необходимо подавать

Iurii-Dolgorukii, 2022-09-21:
Попробую через spi, у гайвера на сайте вчера попадалась библиотека с примерами

lazenyuk-dmitry, 2022-09-21:
> Ну оно у меня так и работает на двух мк. Педали, кнопки на руле это не проблема, можно отдельно на про микро реализовать. В управлении двигателем ничего допиливать не надо, библиотека работает из коробки)))\nЕй точные данные необходимо подавать

Ну просто можно все сделать лучше. Добиться лучшей работы.

Iurii-Dolgorukii, 2022-09-21:
Не просто можно, а необходимо)))

lazenyuk-dmitry, 2022-09-21:
Вся надежда только на Василия если хочешь все сделать хорошо и быстро.

lazenyuk-dmitry, 2022-09-23:
https://github.com/o-devices/bldc-ffb-wheel

Нашел такой проект.

Iurii-Dolgorukii, 2022-09-24:
> [https://github.com/o-devices/bldc-ffb-колесо](https://github.com/o-devices/bldc-ffb-wheel)
>
> Нашел такой проект.

видел, он тоже закрыт

Thread 34 (2023-04-12):

Пропуск шагов энкодера

neSecret, 2023-04-12:
Использовал в схеме энкодер 600 импульсов на оборот. Соотношение поворотов руля к энкодеру примерно 3.75. При резких поворотах ардуино начинает пропускать шаги энкодера и центр руля сбивается. Если проблема в высоком разрешении энкодера, то как её можно решить без его замены?

vsulako, 2023-04-12:
К сожалению, у меня такого энкодера нет, проверить не могу.
Но и при таких параметрах должно бы работать нормально.
Энкодер подключен на пины 0-1?
Видел ваше сообщение на 3dtoday, вы написали что собрали по схеме автора поста - но у него несколько другая прошивка.
Без замены энкодера... а нельзя ли уменьшить соотношение передачи? Или перенести энкодер на ось руля, чтобы соотношение было 1:1?

neSecret, 2023-04-12:
> К сожалению, у меня такого энкодера нет, проверить не могу. Но и при таких параметрах должно бы работать нормально. Энкодер подключен на пины 0-1? Видел ваше сообщение на 3dtoday, вы написали что собрали по схеме автора поста - но у него несколько другая прошивка. Без замены энкодера... а нельзя ли уменьшить соотношение передачи? Или перенести энкодер на ось руля, чтобы соотношение было 1:1?

Энкодер подключен на пины 0-1. Я использовал вашу модифицированную прошивку. Нашёл её в группе Logitech MOMO Racing Modifications (ссылка на архив: https://disk.yandex.ru/d/ATp07dvzKeadaQ). Схему подключения и установки энкодера там же.
Может проблема в скорости обработки сигнала в ардуино? Она просто не успевает считывать столько шагов.
Установить на вал руля, к сожалению, не возможно, потому что из него выходят провода к кнопкам :(

neSecret, 2023-04-12:
Хотел взять такой же энкодер, но с меньшим разрешением, и увидел, что цены на них сильно увеличились за последние пару лет...

neSecret, 2023-04-12:
> В той прошивке я не делал работу с энкодером, ее добавил уже другой автор.
>
> Вот, попробовал навскидку переделать ее под библиотеку Encoder, которую использую я. Проверить в действии не могу, так что попробуйте вы. Для компиляции понадобится установить в Arduino IDE эту библиотеку: https://github.com/PaulStoffregen/Encoder (она есть и в менеджере библиотек, надо просто ее найти и установить) [diy_g25_enc.zip](https://github.com/vsulako/AFFBWheel/files/11212173/diy_g25_enc.zip)

Я правильно понял, что я могу просто залить эту прошивку в плату? Все калибровочные данные в eeprom сохранятся?

vsulako, 2023-04-12:
Ну, должны бы.

Thread 35 (2023-05-10):

servo motors...

cartaio, 2023-05-10:
Hi i work a lot with servo motors and i have one that could be used as a wheelbase... but they are controlled with a DIR+/- pin and a PULSE+/- pin... can your code be adapted? or do i need to write all by myself?

vsulako, 2023-05-10:
I think it can be adapted.
here is branch with quick changes:  https://github.com/vsulako/AFFBWheel/tree/pwmdir
in config.h uncomment `#define MODE_PWMDIR`
if necessary, dir and pwm logic can be inverted.

cartaio, 2023-05-10:
thanks... i should have an arduino laying around somewhere... i'll try asap and try to make some prototype to share this summer! if it works should be a cheap build... the servo is around 250€ with included drive...

cartaio, 2023-05-29:
Hi just had a couple of hours to dedicate to the project... in pulse and direction i have problem with holding torque... just too high to use it... i think the solution should be to use analog input for torque and a direction pin... same question as above... is it doable or i need to program it my self?

cartaio, 2023-05-29:
so i tried with a manual pwm signal on the analog in and the drive doesn't like it... tried with a potenziometer to regulate from 0 and +5 and it works so i think with a dac should work pretty easly... i should have a mcp4725 somewhere... the direction pin works fortunatly so should be only to send instead of the pwm signal, i need a value to send to the dac to scale from 0 to +5/10 the drive have a parameter to scale it up... so even 5v is ok

vsulako, 2023-05-29:
Sorry, I don't understand. Did not work with servo motors.
What is "analog input for torque"? Servo allows to control torque with analog signal on separate pin?
If drive does not like PWM, but works with analog, may be a simple capacitor or RC lowpass filter will do?

cartaio, 2023-05-30:
Yes the drive i have has pwm for position control and analog for speed or torque control... i tried using something but as a read online, to have a clean signal and a good force feedback you need a dac unfortunately... if you want i can send you the manual of the drive...

vsulako, 2023-05-30:
I think it is possible to use I2c DAC like MCP4725, but I don't have any to test if it will work with my bitbang I2c implementation.

I assume, torque value should be equal to pwm value?
FFB produces only one value - force, there is no separate speed and torque values. So, it is not possible to order "rotate slow, but with high torque", or vise versa - "fast, but with low torque".

vsulako, 2023-05-30:
I updated pwmdir branch to use MCP4725 (according to datasheet, not tested).
Force value is sent to DAC, scaled to 12 bit.
Try if it works.

cartaio, 2023-05-30:
I made it work with pwm... i found a parameter on the drive that smooth the signal but it works more or less... i think woth the dac should be perfect... i have a strange behavior when everything is off(wheel check and game closed) i get the wheel to bounce left and right, with wheel check set to simple spring i get vibrations around 0 point... is there a parameter for a deadzone?

vsulako, 2023-05-30:
No, wheel axis does not have deadzone. May be force is too strong, and even very low FFB force near center cause axis to move? try to lower effect gain.

cartaio, 2023-05-30:
I will try tomorrow, i 3d printed an adapter for a wheel now and tomorrow with the dac should be better... thank you for your time!

cartaio, 2023-05-31:
the DAC is outputing always 0v despite the force value... i tried a new software with the adafruit library and it works... then i used bb i2c and it does not... i'm trying to find why... i'll keep you updated.

cartaio, 2023-06-01:
no luck for today... i made some research, and i'll try to do something later... some info i found on the dac attached...
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

vsulako, 2023-06-01:
1. May be i2c address is wrong. I set it as 0x60, but datasheet says, A1/A2 can be factory set to be not zero. Also, not sure about A0, if it is 0 or 1. Did you use same address 0x60 with another library?
2. another possibility is that MCP4725 cannot work at too high speed.  try to set I2C_DELAY in config.h from 1 to higher value, 10-20 or so, it will slow down bitbang i2c.
3. last suggestion is to use hardware i2c. unfortunately, there's not enough space left in flash for adding wire.h library, so something must be sacrificed. and it will require to free pin 3.
code for hw can be like this:

```
void writeDAC(uint16_t value)
{
  value &= 0x0FFF; //clear first 4 bits for fast & normal modes
  Wire.begin();
  Wire.setClock(400000);
  Wire.beginTransmission(MCP4725_ADDR);
  Wire.write(value>>8);    
  Wire.write((uint8_t)value);    
  Wire.endTransmission();   
  Wire.end();
}
```

cartaio, 2023-06-02:
Update! I removed part of the serial output in the main program, fitted the code and it works perfectly... now i will adapt my old pedals bolt the wheel and try it in game... the dac remove the noise that the motor had with pwm... do you have some standard parameter to put in the gui for FF? Or 1024 everywhere is a good starting point?... thanks for the help!

vsulako, 2023-06-02:
1024 for FFB effect gains is default starting point. It means coefficient 1:1, i.e.: if force is 50%, output PWM value will be also 50%.
Most games use only constant force effect.

Thread 36 (2023-06-14):

AS5600 isnt registering position

Highlight8, 2023-06-14:
can you help me the as5600 as you said i did every thing the same but im unable to resolve the issue and i think i connected it correctly too can you show me how you connected it please

im sharing the code which customized with your help
and i had a doubt about where to change the i2c code in config.h but i did what i think was appopriate

all other things are working fine except this idk if its an issue with the board because it randomly registers some times

[New WinRAR ZIP archive.zip](https://github.com/vsulako/AFFBWheel/files/11745266/New.WinRAR.ZIP.archive.zip)

vsulako, 2023-06-14:
Connection diagram is in readme: https://github.com/vsulako/AFFBWheel/raw/master/images/AS5600.png
It seems that your config is correct, if I2c SDA/SCL pins are 0-1.

Try to increase I2C_DELAY value in config.h, to 10 or 20.
If you have free pins, also try to change I2c pins from 0-1 to another ones.

Highlight8, 2023-06-19:
thanks for the advice i tried it but the as5600 dosnt work with the test code so im assuming its faulty sorry for the issue thankyou very much for replying im very grateful

Closed 2023-06-19.

Thread 37 (2023-06-19):

Rotary encoder isnt registering position

Highlight8, 2023-06-19:
So assuming the as5600 was faulty and i bought this rotary encoder 600 ppr but the thing also does not work so im assuming its a fault in the sketch can you please rectify it (i have made correct connections according to the sketch and it still does not work)
[rotary issue.zip](https://github.com/vsulako/AFFBWheel/files/11789979/rotary.issue.zip)

sorry for the trouble im a student and was doing this as a summer project and bought everything out of my strict budget

Highlight8, 2023-06-19:
i also tried the trick with connecting vcc with a Resistor to A and B

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
like this

vsulako, 2023-06-20:
Your configuration is correct - I checked it in hardware with encoder connected to 0-1 pins.
If connections are correct and encoder is ok  - I can only suppose that something is wrong with arduino pins.

It can be checked with a couple of wires by manually simulating encoder signal: without encoder connected, connect pin 0 to GND, connect pin 1 to GND, disconnect pin 0, disconnect pin 1. This sequence should register as encoder step.
If it does not react, may be pins 0-1 are faulty.

Can you move encoder wires phase A/B to pins 2-3 for testing? (it will require disconnecting button pins PL and DATA1 and disabling 74HC165 buttons)
Here is full code for this setup. (buttons are disabled, encoder moved to 2-3) I checked it also in hardware.
[enc_pin2-3.zip](https://github.com/vsulako/AFFBWheel/files/11807510/enc_pin2-3.zip)

Highlight8, 2023-06-28:
yes the encoder does give output when simulated manually

i tried it still doesnt work (the vcc resistor connection)

im confused why everything else works but this doesnt

vsulako, 2023-06-28:
> yes the encoder does give output when simulated manually
ok, so arduino board and code seem to be ok.

> i tried it still doesnt work (the vcc resistor connection)
Try pulling to GND, not to VCC, as in picture above. If possible, use 1kOhm resistors.

> i already tried it with 2 encoders i bought
what is exact model name of these encoders?

Highlight8, 2023-06-29:
>Try pulling to GND, not to VCC, as in picture above. If possible, use 1kOhm resistors.
i did it again with 1k ohm tried it also with vcc

>what is exact model name of these encoders?
YTO6-OP-600B-2M-5-24V

and im sending this link
(its the same product but i did'nt buy it from here)

https://dientuvietduc.com/product/encoder-yt06-600b-op-2m-600-xung-hai-k%C3%AAnh-ab-5-24v/

vsulako, 2023-06-29:
Looks like ordinary encoder. It should work. I dont understand.

Let's look if it outputs anything at all.
Here is simplest testing sketch.

```
void setup() {

  pinMode(0,INPUT_PULLUP);
  pinMode(1,INPUT_PULLUP);

  attachInterrupt(digitalPinToInterrupt(0), change, CHANGE);
  attachInterrupt(digitalPinToInterrupt(1), change, CHANGE);

  Serial.begin(9600);
}

void change()
{
  Serial.print(digitalRead(0));
  Serial.print(digitalRead(1));
  Serial.println();
}
void loop()
{

}
```
Connect encoder's A/B to 0/1 pins without resistors, power it, upload code, open Serial monitor and slowly rotate encoder.
Normally it should react like that:
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

If it does not print anything, add resistors to VCC, restart Serial monitor and try once more.

If it still does not react:
- remove these 2 lines from sketch "pinMode(0, INPUT_PULLUP);
- upload
- move resistors to GND
- rotate again.

If it still does not react...

I did a little research in google, and found that some encoders, despite stated minimum voltage 5v, cannot really work with 5v.
They have 7805 regulator inside, which requires at least 6-7v input to produce stable 5v, otherwise it just does not work properly.
Can you power encoder from another source with voltage higher than 5v? of course, in that case encoder's VCC and arduino's VCC must be separate (but GNDs connected).
Also, just to be sure that arduino's pins will not be damaged, connect A/B through resistors ~1kohm

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

Highlight8, 2023-06-30:
i also had researched what you found and had previously tried it with 9v but it didnt work

but then you said it can b done till 12v i got soo excited as your research was correct about the encoders working on a higher voltage i connected a 12v adapter i had lying around with the diagram you had given

And it started working with the test sketch.. i mean it was giving output

but once i uploaded the afbbwheel sketch it stopped working and the gui wheel was rotating by itself towards the right side

(without my input)

basically
it doesnt respond with the afbbwheel sketch but works with test sketch

Highlight8, 2023-06-30:
Okay so it does respond and works i just connected the A and B to the 12v of the adapter with a 10k resistor

but idk when turning to left it takes more rotations whil turining to right it takes less rotations
can this be fixed??

Thread 38 (2023-07-19):

AFFBWheel with hoverboard wheel

oiler2016, 2023-07-19:
Hey.

Is there a possibility for you to make an implementation to make it possible to use the hoverboard wheel together with the hoverboard's controller board? Currently it is commonly used VESC+STM32 or Odrive to control hoverboard motor and use for force feedback. This scheme also requires an incremental encoder and a few more absolute encoder models. The controller board of the hoverboard itself already has an STM32 and all the necessary circuitry. In the hoverboard wheel, in addition to phase 1, phase 2 and phase 3, there is also a hall sensor for each phase. Therefore, it would not be necessary to use another controller besides the original one of the hoverboard itself. Here is a link talking a little about the board of the hoverboard itself:

https://github.com/lucysrausch/hoverboard-firmware-hack

If you can't do this implementation, could you give me some guidance to get started?

Congratulations on your project!

vsulako, 2023-07-22:
This will require rewriting everything from scratch.
This project is for ATMega32U4, it will not work on STM32.
And as I see from pinout image, hoverboard controller does not have USB, so I don't think it can be used as gaming controller.

But, may be there is a simpler way.
Unfortunately, I don't have a hoverboard to play with, so I can only suggest.

There is an example of hoverboard control via UART, I2c, analog signal or PPM signal at https://github.com/p-h-a-i-l/hoverboard-firmware-hack
So, with this firmware hoverboard can just receive force value for rotation from separate gaming controller.

UART seems to be most convenient. Atmega32U4 cannot produce true analog signal, PPM or I2c require additional coding.
And luckily, ATmega32U4 has hardware UART, which is unused in AFFBWheel. At Leonardo/ProMicro boards it is placed on pins 0/1 (initially these pins are for encoder, so encoder should be moved to 2/3 pins)
So, UART is simplest to implement.
At hoverboard controller, use UART3 at PB10/PB11 - because these pins are 5v tolerant on STM32F103.

As for software change, all is needed is to rewrite motor.cpp to send rotation commands via UART to hoverboard controller instead of forming PWM signal.
HW UART on Leonardo/ProMicro is addressed as Serial1.
Example of UART code is on hoverboard-firmware-hack page.
I did not understand why there are 2 values - speed and steer. Method is needed to convert FFB force value (-16383..16383) to speed/steer values (-1000...1000), I think it will need some experimenting.

oiler2016, 2023-07-30:
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

Thanks for the answer!

In fact, in my first question, I didn't want to mention that the whole project should be rewritten. I suggested one extra implementation only.

About the hoverboard firmware asking for steering and speed: there is a way to disable the steering request and that way only the speed is sent, and that's how I'm doing it.

I am trying to do as per your guidance. I adjusted the Encoder for pins 2/3 of the Arduino Leonardo, but I'm having problems mapping from -16383 to 16383 to -1000 to 1000. Debugging through the Arduino serial I see that the mapping only occurs when the wheel is getting close to the extremes. For example:

I configured the wheel at 1080º and when I turn it, getting close to 540º, the mapping starts to be done. Likewise for -540º. And in this scenario (-16383 to 16383 to -1000 to 1000), when reaching the extreme, the wheel spins uncontrolled in the same direction instead of pushing towards the center. But if in the Arduino Leonardo code I put the mapping -16383 to 16383 for 1000 to -1000, then when reaching one of the extremes the wheel makes an effort to return to the center, but it is the only FFB effect that occurs. All others do not appear to be activated.

Debugging directly from the hoverboard board, I also see that the mapping values only activate near the extremes of the wheel.

In the firmware part of the hoverboard board apparently everything is OK with the settings. I tested it with the Arduino code that accompanies the project https://github.com/EFeru/hoverboard-firmware-hack-FOC and it works perfectly.

I'll keep trying to rewrite the motor.cpp, but I think it will take time.

vsulako, 2023-07-30:
> if in the Arduino Leonardo code I put the mapping -16383 to 16383 for 1000 to -1000, then when reaching one of the extremes the wheel makes an effort to return to the center, but it is the only FFB effect that occurs.

I think you see the work of endstop. It is always on (in fact, it is not an FFB effect at all)
It limits wheel rotation in configured range.
When you turn wheel beyond limits, backward force is produced until wheel returns back to set range.
Obviously, if motor direction is reversed, wheel will endlessly spin in opposite direction, so, reversed mapping -16383..16383 to 1000...-1000 seems to be correct.
Don't expect returning to center, it's the job of Spring effect.
From your description, I can suggest that endstop is working. Other effects also should work.

> All others do not appear to be activated.
How do you test them? In a game, FEdit, or Wheelcheck?

oiler2016, 2023-08-01:
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

I did new tests. I kept the mapping from -16383 to 16383 to 1000 to -1000 and tested it in Euro Truck simulator 2 and Assetto Corsa.

In ETS2 collision effects do not happen. Too many effects are apparently happening, but there is a lack of control in the wheel at times. Watch the video that shows the problem:

https://youtu.be/Ii2QsOZQkjA

In Assetto Corsa this same problem occurs and there are also no collision effects and no track effects either.

I tried tests on WheelCheck and the effects enable, but do not disable even selecting the option in the program. See the video please:

https://youtu.be/RSyODf52Xfs

I just edited the motor.cpp, added the mapping (map function) and inserted the settings and the Send method from the example file: https://github.com/EFeru/hoverboard-firmware-hack-FOC/blob/main/Arduino/hoverserial /hoverserial.ino

In the rewritten motor.cpp, the Send method sends the Steering value zero and the mapped speed via serial: Send(0,mapedForce). I'm using only two wires from the Arduino Leonardo to connect to the hoverboard's motherboard: GND and TX (connected to the motherboard's RX).

In the videos you can see a noise that I believe is from the power supply. Later I will get a stronger source.

I am confident that your project can become the solution for hoverboard motherboard use in force feedback projects.

vsulako, 2023-08-01:
Second video with wheel not stopping makes me think it is a communication issue.
May be, arduino sends too much commands, they are all put in STM32 buffer and hoverboard does not stop until it executes them all.

Please try:
- repeat process shown on video with Wheelcheck, and when wheel is disabled but does not stop, disconnect TX wire. If i am right, it will still not stop.
- set baud rate for UART as high as possible (250000, 500000, 1000000, 2000000 - which one still will work)
- after you send a command to hoverboard with `Serial1.write()`, let's wait for a couple of milliseconds:  add  `delayMicroseconds(2000)` and see if it helps. It is dirty, but just for finding where problem is.

Also, I prefer [FEdit ](https://gimx.fr/wiki/index.php?title=Force_Feedback) for testing FFB effects. In a game you don't really know what game is trying to tell. FEdit allows to create any effect with any parameters, isolated. Try to create a single Constant force effect with 1-2 seconds duration and see will it perform it and stop or not.

`fvaout` command in AFFBWheel can also be useful, it outputs FFB value to Rz axis in realtime, and you can use an app like VKB Joytester to display graph of wheel position and FFB force. Thus, you can see if there is a lag between FFB command and real wheel movement.

Thread 41 (2023-09-23):

Encoder Axis Troubleshooting

tote46, 2023-09-23:
Hello, i having a problem with games reading X axis (encoder axis i guess), both in AFFB GUI and some other apps like WheelCheck, DlView,DxTweak and even  in windows calibration X axis is read, but it seems like games (Automobilista 2 and F1 2023) cant read it for some reason.
Leonardo board and analog inputs are readed and work just fine, i made some pedals with hall sensors and potentiometers and they work fine in both games.
What can i do?

vsulako, 2023-09-24:
If axis works in windows gaming devices properties, game should see it too. (Though, some games like Forza Horizon work only with controllers known by them)
Don't know about F1 2023, but I tried Automobilista 2 - it works.
I chose custom wheel in control scheme tab, and then manually assigned steer left and steer right controls in edit assignments tab.
What can be a bit confusing - just moving wheel a little back and forth was not enough. I had to move axis all the way from center to limit and then back to center (actually, game says it in a sidebar) and only then axis was recognized as "joy axis X".

tote46, 2023-09-24:
Hi, yes i got f1 2023 to work and everything works even ffb works great, automobilista 2 i couldn't but i didnt try again after getting f1 working.
Maybe if i reduce steering angle to idk 180° and then try to assign the X axis its gonna be easier, idk gonna try later

Thread 42 (2023-11-25):

Using a multiplexer for button inputs

Zredy, 2023-11-25:
Hello, I want to use a multiplexer (4 pins for selecting the readable channel + 1 pin that reads the channel) to read the button states from my wheel.
I tried poking around and implemeting something but I can't figure out how the button values are stored in the "d" or "buttons" variable.
Are they stored in a bit fashion or some other way?
Any help would be appreciated :)

vsulako, 2023-11-26:
Every bit of 32-bit variable stores state of button. 1=pressed, 0=not pressed.
0b00000000000000000000000000000001 = button #1 is pressed
0b00000000000000000000000000000010 = button #2 is pressed
and so on.

Zredy, 2023-11-26:
Amazing stuff. I managed to implement it in my own way but this way with bitRead and bitWrite is so much sleeker. I have everything working, from HX711 brake(which im probably going to replace), to reading the angle and writing the force effect to an esp32 that's running FOC code for the stepper! Only thing, I tried Forza Horizon 5, and it reads all the buttons etc but the force feedback doesn't work, so i run Forza Emuwheel to get the feedback working, Have you seen anything similar?

vsulako, 2023-11-26:
In my case, Forza Emuwheel did not work with Forza. The only solution I could find was GIMX.

Thread 44 (2023-12-25):

Analog button

Ertugrulbabaci, 2023-12-25:
Hello. How many buttons can I connect to a single pin in the analog button connection? I want to use 4x4 matrix button connection (8 for gear and 8 for steering wheel). Also, are resistors necessary?

lazenyuk-dmitry, 2023-12-27:
As I understand it, you are talking about such a scheme.

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

I don’t understand at all what the circuit will look like if it is divided into two, 8 buttons each. This will be very difficult. And you will need to run 8 wires to your gearbox.

Now there is a diagram in the description where you can do all this using 3 wires. I don't think it makes sense to add buttons on a matrix circuit to the firmware.

Ertugrulbabaci, 2023-12-27:
The reason I want this system is because I have ready-made connections. And I asked, thinking that maybe there was a suitable scheme in the system you prepared. I don't think about money. Which system can I use the most buttons using the least amount of cables? Which one should I choose?

lazenyuk-dmitry, 2023-12-27:
> The reason I want this system is because I have ready-made connections. And I asked, thinking that maybe there was a suitable scheme in the system you prepared. I don't think about money. Which system can I use the most buttons using the least amount of cables? Which one should I choose?

Ok. Well, I don’t think it will be difficult to redo the wires on your assembly. It would be better and more compact. But you can ask @vsulako to do this if he wants. But again, other connection options are much better.

vsulako, 2023-12-27:
1) There is no limit for analog pin buttons, you can connect up to 32 buttons to single pin. But, this type of connection can not detect two or more pressed buttons, only one at a time, so it is not a good choice for usual buttons, it can be ok for a shifter, because it selects only one gear per time.
2) Sorry, no button matrix support for now. It required too many pins - 4x4 matrix will take 8 pins. Also, matrix wiring is somewhat messy. I didn't think someone would need it. Will try to add when have some time.
3) I think simplest connection for buttons is with i2c extenders: PCF8575/8574. They are cheap, 4 wires only, no need for extra resistors for every button, can be arranged in 4x8, 2x8+1x16 or 2x16 layouts.

Ertugrulbabaci, 2023-12-27:
thanks for the answer. I will try to use 74HC165 shift register for gear (8 buttons). (I hope I can succeed) I will try to make the 8 buttons on the steering wheel with analog button connection. This seems to be the easiest.

lazenyuk-dmitry, 2023-12-27:
> thanks for the answer. I will try to use 74HC165 shift register for gear (8 buttons). (I hope I can succeed) I will try to make the 8 buttons on the steering wheel with analog button connection. This seems to be the easiest.

You can do everything on analog buttons or everything on registers. Just keep in mind that you won't be able to press multiple buttons on an analog connection. Analog buttons are more suitable for gearboxes.

vsulako, 2023-12-28:
Added support for button matrix.
configuration:
```
#define BM                                //uncomment to enable
#define BM_COL_PINS   2,3,4    //pins for columns, comma-separated
#define BM_ROW_PINS   5,6,7  //pins for rows
#define BM_1ST_BTN    1          //number of first button (1-32)
```

Ertugrulbabaci, 2024-01-04:
Thank you very much. I think the other methods you mentioned make more sense. If I fail to do so, I will go back to the matrix link.

Ertugrulbabaci, 2024-01-05:
Hellı again. I'm trying to make a connection using the analog button method. I made the button connections with 4.7k resistors. I cannot assign buttons because I cannot see the values. How can I see the values? Also, can I use both analog connection and shift register at the same time?

vsulako, 2024-01-05:
- Yes, shift register and analog pin buttons can be used at same time. Analog pin buttons will rewrite corresponding shiftreg buttons.
- Connect to ardiuno with Serial Monitor and send command `apbout`. It will turn on outputting value from analog pin selected in config. (`#define APB` must be uncommented and `APB_PIN` defined)

Ertugrulbabaci, 2024-01-06:
Okay, I took care of the analog buttons. I decided to use matrix connection instead of shift register for gear, but I could not understand the pin connections in the matrix codes. 234 567 says 6 pins in total, but 8 cables are needed for 16 buttons. Should I make the connection according to the diagram in the picture above?

vsulako, 2024-01-06:
You say you already have button matrix.
With 16 buttons it should have 8 pins, 4 for rows and 4 for columns. Internal connections should be like on a picture above.
You need 8 free pins on arduino. I dont know which you have, but say for example, they are 2,3,4,5,6,7,A4,A5.
Just list them in config separated by commas, columns and rows pins separately.

````
#define BM            //enable
#define BM_COL_PINS   2,3,4,5
#define BM_ROW_PINS   6,7,A4,A5
#define BM_1ST_BTN    1
````
And connect to your button matrix accordingly.

Usually rows/cols pins are interchangeable, but sometimes matrix can have diodes inside, to prevent ghosting.
If if does not work, try to swap columns/rows pins (diode's cathode should be at row's pin)

Ertugrulbabaci, 2024-01-06:
I've been trying to find where the problem is for hours. I was connecting the buttons but it wasn't working. You have uploaded a new ino file. I was trying to write the Matrix code myself. When I downloaded the new ino file, my problem was solved. thanks a lot.

Ertugrulbabaci, 2024-01-19:
Hi bros again. After giving direction with hatswitches, can we add a button that we can use instead of backspace and enter? Is the button code available? @vsulako

vsulako, 2024-01-21:
What do you mean by backspace/ESC/enter? It's not a keyboard, it's a gaming controller, it does not have keyboard keys at all.
If you want to emulate keyboard button press, you can use software like [JoyToKey](https://joytokey.net/en/) and [similar](https://alternativeto.net/software/joytokey/).

Ertugrulbabaci, 2024-01-22:
For example, you entered the settings tab in the menu. I meant a button you can use when you want to go back to the main menu tab. Like the X and O buttons on the playstation controller. Is this possible?

vsulako, 2024-01-23:
Game should allow to define which controller button does actions like navigating in menus.
If not, just use a mapper to map buttons to esc/backspace/enter/whatever.
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

SoullessHax, 2025-05-29:
Hello everyone, I wanted to ask a question, there is no easier way to connect the buttons, I saw in another project that analog connectors and ordinary ones are simply used without power and grounding. I just want to temporarily change gears and that's it.

SoullessHax, 2025-05-29:
Нельзя сделать что то подобное
void G25_::setButtons(uint32_t btns)
{

  //первые 4 бита - кнопки крестовины (hat switch)
  uint8_t hat=(btns & 0xF);
  btns &= 0xFFFFFFF0;
  switch (hat)
  {
     case 0b00000001:
        btns |= HAT_UP;
        break;
     case 0b00000010:
        btns |= HAT_DOWN;
        break;
     case 0b00000100:
        btns |= HAT_LEFT;
        break;
    case 0b00001000:
        btns |= HAT_RIGHT;
        break;
     case 0b00000101:
        btns |= HAT_UP_LEFT;
        break;
     case 0b00001001:
        btns |= HAT_UP_RIGHT;
        break;
     case 0b00000110:
        btns |= HAT_DOWN_LEFT;
        break;
    case 0b00001010:
        btns |= HAT_DOWN_RIGHT;
        break;
    default:
        btns |= HAT_CENTER;
  };

  //перемещение кнопок: 16->20, 17->16, 18->17, 19->18, 20->19
  bool tmp=bitRead(btns,23);
  bitWrite(btns, 23, bitRead(btns, 19));
  bitWrite(btns, 19, bitRead(btns, 20));
  bitWrite(btns, 20, bitRead(btns, 21));
  bitWrite(btns, 21, bitRead(btns, 22));
  bitWrite(btns, 22, tmp);

  buttons=btns;
}

Thread 45 (2024-01-09):

Поиск центра без стопорных ограничений

Envi4, 2024-01-09:
Здравствуйте, а есть ли возможность сделать центровку при подключении к ПК, без стопорных механизмов, например торможением двигателя, а центр как то сохранять в прошивку значением энкодеры, а не силен в программировании, но если такая возможность есть, очень был бы рад ее увидеть в будущем

vsulako, 2024-01-09:
При включении и так текущее положение руля считается центром.
Просто выровняйте его перед подключением, или нажимайте кнопку центровки.
А если речь о том чтобы руль сам крутился и находил центр, то без механических ограничителей непонятно как он должен понять, где находится центр.  Разве что по Z-сигналу от энкодера, но он есть не на всех энкодерах. На моем нету.

lazenyuk-dmitry, 2024-01-09:
> При включении и так текущее положение руля считается центром. Просто выровняйте его перед подключением, или нажимайте кнопку центровки. А если речь о том чтобы руль сам крутился и находил центр, то без механических ограничителей непонятно как он должен понять, где находится центр. Разве что по Z-сигналу от энкодера, но он есть не на всех энкодерах. На моем нету.

Вроде все так. Только по Z сигналу. Если нету ограничителей. Иначе никак... И в прошивку сохранять это все Z по сигналу. Ну была бы прикольная фича) Может кто то тебе задонатит на энкодер с Z сигналом))

@Envi4, а вы заметили, что в описании есть про кнопку для центровки? Вы можете назначить любую кнопку и центрировать руль. Энкодеры с Z сигналом подороже будут.

Closed 2024-01-14.

Thread 46 (2024-01-10):

Использование драйвера мотора L298N

jhnf, 2024-01-10:
Поддерживает-ли Ваша прошивка подключение драйвера мотора L298N вместо BTS7960?

vsulako, 2024-01-10:
Можно и L298N.
входы IN1,IN2 - как R_RWM/L_PWM на BTS7960
ENA - как R_EN/L_EN.

lazenyuk-dmitry, 2024-01-10:
@jhnf  Вот здесь https://github.com/vsulako/AFFBWheel/discussions/32

Thread 47 (2024-01-14):

Проблемы с центрированием

Envi4, 2024-01-14:
Приветствую, решил сделать стопорные кольца для поиска центра, сделал модель, распечатал, поставил, но столкнулся с проблемой, подключаю руль, он начинает искать центр вначале влево, после направо, а после снова до упора влево и не останавливает двигатель упираясь в стопор, так же при подключении руля вместе с двигателем после этих махинаций поиска центра, он не видится системой, пишет no connection, подключается только если отключить двигатель и подключить руль без него

Darkmen203, 2024-01-18:
> Приветствую, решил сделать стопорные кольца для поиска центра, сделал модель, распечатал, поставил, но столкнулся с проблемой, подключаю руль, он начинает искать центр вначале влево, после направо, а после снова до упора влево и не останавливает двигатель упираясь в стопор, так же при подключении руля вместе с двигателем после этих махинаций поиска центра, он не видится системой, пишет no connection, подключается только если отключить двигатель и подключить руль без него

а какая у вас скорость и при этом все правильно отображается в программе драйвера?

Envi4, 2024-01-18:
К сожелению с ком порта не получилось взять данные, игрался с разными параметрами и в итоге сломал стопорные кольца и пришлось отключать плату, буду переделывать из опытом скажу, несколько раз у меня получалось завершить настройку и центр находило, каждый раз повышая силу мотора, с force 9500 начал более менее работать, но с такими настройками становится страшно использовать эту функцию, так при таких значениях он не факт что найдет, а 10000 сломало ограничитель

Darkmen203, 2024-01-18:
А что у вас за мотор?) У меня проблема ровно наоборот, я рукой прокручиваю мотор, потому что он импульсами сопротивляется

Envi4, 2024-01-18:
> А что у вас за мотор?) У меня проблема ровно наоборот, я рукой прокручиваю мотор, потому что он импульсами сопротивляется

pik 8-6/2.5 работает от 24v

Darkmen203, 2024-01-18:
Хм, ну это довольно мощный мотор, с которым обычно не используют ограничители, он сам может выступать ограничителем

Envi4, 2024-01-18:
> Хм, ну это довольно мощный мотор, с которым обычно не ограничивают ограничители, он сам может поддерживать ограничитель

Мне ограничитель нужен для создания автоматической центровки, дальше он не будет использоваться, раньше использовал по кнопке, но автор добавил такую возможность и я загорелся создать такую центровку, но пока есть проблемы

Darkmen203, 2024-01-18:
А вы на вал ставили руль уже? Вполне возможно, что вам силу приходится так увеличивать из-за того что руль тяжёлый и двигателю нужно много усилия прилагать чтобы прокрутить и он поэтому ваши стопоры ломает при этом не завершая процедуру калибровки

Envi4, 2024-01-18:
> А вы на вал уже поставили руль? Вполне возможно, что вам придется столкнуться с такой необходимостью из-за того, что руль тяжёлый и двигателю нужно приложить много усилий, чтобы прокрутить, и поэтому ваши стопоры ломаются при этом не завершая процедуру процедуры.

Без руля тестировал, он съёмный у меня, поэтому не понимаю почему нужна такая силу ему, спокойно одним пальцем прокручивается
А от стопорных колец сейчас отказался после их поломки пришла идея сделать резьбовой ограничитель

Darkmen203, 2024-01-18:
Хотел тоже вам сказать что можно попробовать гайкой, получается у вас на границах стоит по две гайки в виде контргаек и где-то по середине  ещё одна гайка, которая по-идее будет от ваших движений закручиваться или откручиваться, что-то подобное у меня получалось в первой конструкции, но были минусы, что чутка закусывали вал из-за этого, т.к. он у меня упирался в уголок (да и цель гайки была не быть ограничителем, а просто в виде контргайке держаться, но я забыл затянуть, хех)

jhnf, 2024-01-20:
> К сожалению, предположений нет. Двигатель, судя по всему, вращает в правильную сторону (если влево это против часовой) То что во время поиска центра контроллер недоступен - это так и должно быть, так было проще сделать. Немного обновил код, посмотрите что при поиске центра выводит в ком-порт. (по команде "autocenter")

А почему не сделать нахождение крайних положений через концевые выключатели, типа тех, что в 3Д принтерах работают? Кольцевой ограничитель упирается в выключатель, тот срабатывает, мотор стопорится, кольца целые. И повесить их не на виртуальные кнопки, а на пару свободных портов микроконтроллера.

vsulako, 2024-01-21:
> А почему не сделать нахождение крайних положений через концевые выключатели, типа тех, что в 3Д принтерах работают? Кольцевой ограничитель упирается в выключатель, тот срабатывает, мотор стопорится, кольца целые. И повесить их не на виртуальные кнопки, а на пару свободных портов микроконтроллера.

Можно и так. Надо будет как нибудь добавить.

Thread 48 (2024-01-15):

Проблема с ограничителем

Darkmen203, 2024-01-15:
Здравствуйте! Подключил все руль по схеме (драйвер мотора через пин). По итогу ограничение поворота какое-то слабенькое, больше похоже на импульс короткий, чем сопротивление. Ввиду этого очень легко ограничение перейти и затем сбивается центр. В чем может быть проблема?
Также еще есть проблема что в программе все отображается корректно, пока не зайдешь в игру, как только заходишь в игру, ощущение как будто появлются пропуски при считывании с энкодера и руль в игре и программе начинает вести себя не адекватно

Darkmen203, 2024-01-15:
использую инскрементальный энкодер(600ppr), мотор 775 и бтс

Darkmen203, 2024-01-15:
Сейчас ещё попробовал попроверять, получается когда просто условно с рабочего стола заходишь в программу affbwheel gui и пробуешь, не важно насколько быстро/медленно крутишь руль, всегда определяется одинаковое количество оборотов (если не выходить за ограничение)
Зашёл в игру и пробую крутить руль там (проверяю на етс2), итог, при медленной прокрутке как будто бы вообще в игре прогркучивается градусов на 10, когда физически прокрутил на примерно 90, когда кручу быстро как будто бы больше определяет градусов, СВОРАЧИВАЮ игру, оставляя ее активной и через приложение проверяю по итогу:
Во-первых, сбивается центр абсолютно непонятные значения выдает, во-вторых, оборотов становится физических около 6. Закрываю игру и сразу же все становится на свои места и все работает корректно. Настройка на 900 градусов. Не пойму в чем может быть проблема? Соединение напрямую энкодер к плате, могу попробовать через резисторы на 1к подключить. Опять же не думаю что это что-то даст, как будто бы дело всё-таки в чем-то другом, потому что  проблема возникает именно при запущенной игре и исчезает после. Также пробовал в другой(my summer car), там такая же проблема. Как будто бы игра перекалибровывает руль и он перестает работать корректно, но опять же вопрос почему тогда даже при свернутой игре, программатоже начинает криво регать энкодер

vsulako, 2024-01-16:
Мистика какая то.
Без обратной связи то же самое?
Проверьте правильно ли работает ось руля в [VKB Joytester](https://www.vkbcontrollers.com/pages/downloads) или [DXJoyTester](https://sites.google.com/site/diyheadtracking/home/joystick/dxjoytester).
Если там что-то не то - сбросьте настройки в свойствах контроллера (панель управления, настройка игровых USB контроллеров, свойства-параметры-восстановить)

Darkmen203, 2024-01-16:
Проверил с помощью DXJoyTester вкладкой Axes. Итог:
    если игра не запущена и просто смотрим данные в этой программе, то FPS в районе 750~,
    если игру запускаем и сворачиваем и снова просматривает данные с энкодера, то FPS максимум 61.
Думаю, что как раз в этом и проблема, только вот почему такое возникает? И вот самое главное как вообще может быть такое что игра на это влияет

Darkmen203, 2024-01-16:
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
скрин 1 - игра не запущена
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
скрин 2 - запустил игру и смотрю данные

Также, как вы сказали попробовал отключить ффб, но ничего не поменялось

vsulako, 2024-01-16:
Игра на FPS влиять особо не должна. У меня при игре ниже 600 не опускается. Разве что создается очень много эффектов ОС, но если это и с отключенной ОС, тогда не знаю.

Эти скрины DXjoytester - руль от края до края, или просто туда-сюда?

В ETS2 есть еще свои настройки которые могут повлиять на поведение руля.

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

Чувствительность руля - макс
Нелинейность руля - мин
порог чувствительность - мин

Darkmen203, 2024-01-16:
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
а может ли быть проблема тут? это в диспетчере устроиств свойства арудино

vsulako, 2024-01-16:
Нет, эти свойства ни на что не влияют.

FPS который показывает DXJoytester, похоже, зависит еще и от компьютера, он может скакать без видимых причин.
Реальную производительность контроллера можно посмотреть по команде timing в мониторе порта (число loops/sec).

Вообще игра никак не должна менять работу контроллера.
Есть ли возможность проверить на другом компьютере?

Darkmen203, 2024-01-16:
> Вообще игра никак не должна менять работу контроллера. Есть ли возможность проверить на другом компьютере?

как раз этим и занимался)

По результатам, получилось, что там все работает абсолютно идеально, как в игре, так и в DXJoytester.
    Основное что заметил ( за качество изменяюсь)

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
на компьютере, в котором все идеально
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
на компьютере с проблемой, при этом не понятно в чем причина.
    Основные отличия, что тот комп, на котором работает более старый и там не установлена ардуино ide. Ну в остальном не знаю что именно могло повлиять(

Darkmen203, 2024-01-16:
в компе с этой проблемой уже в разные порты пробовал, завтра попробую еще один компьютер, но в него вставлю диск с виндой проблемного компьютера, посмотрим что будет! Ну в любом случае это поможет исключить проблему винды, хех

Envi4, 2024-01-16:
А пробовали на компьютере с которым проблема, отключать все устройства ввода, может с каким-то устройством происходит конфликт

Darkmen203, 2024-01-16:
> А пробовали на компьютере с которым проблема, отключать все устройства ввода, может с каким-то устройством происходит конфликт

Хм, интересный вариант, завтра проверю, тебе пробовал отключать все устройства, т.к. будет тяжело проверить, но я попробую завтра что-то придумать чтобы остался только один руль

Darkmen203, 2024-01-17:
Решил проблему с неправильным поворотом, оказалось что дело в BIOS там была настрока LPT порта и стояло что-то типо
STD Printer Mode . Изменил на spp и все заработало. Спасибо большое за помощь)
А я уже все перепробовал все кроме материнки ставил в другой компьютер, а надо было просто с BIOS поиграться)
    Остался один вопрос по endstop, получается когда доходишь до границы очень медленно, то прям хорошо стопит, но в случае если около 400 градусов когда просто руками крутить дальше быстро, то проходишь границу и там ограничитель просто подает импульсами короткими напряжение и все, но руль не стопит. Заметил что это работает так, ограничение по параметру row примерно 10200 и на нем хорошо стопит, но если случайно прошел эту границу на скорости, то оказываешься примерно на 10400, то там уже руль не жестко стопится, а просто пытается с помощью короткого импульса вернуться (которые на самом деле очень слабый, почти не заметный.

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
Пробовал с такими настройками и + пытался поиграться с значениями параметров endstop

vsulako, 2024-01-18:
Что-то странное.
Через монитор порта дайте команду fvaout и покажите график из DXJoytester, что происходит при прохождении границы.
Значение ОС будет на оси rz.
Должно быть как то так:
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

Также включите вывод по оси X - `axisinfo 0` и посмотрите, какие там получаются значения у FFB. Должно быть  16383 или -16383.

vsulako, 2024-01-18:
Странно. На вид более-менее правильно, только непонятно почему упирается в 16382 а не 16383, и почему в dxjoytester не доходит до максимума. Пики, наверное, из-за работающего мотора. А если настройки (усиление, min/max force) установить на исходные?

Darkmen203, 2024-01-18:
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
сейчас поставил на такие значения, не помню какие были исходные...
В 16382 упирается потому что почему-то не выставляется 16383, когда ввожу это число стирается последняя цифра в приложении

Darkmen203, 2024-01-18:
сейчас через serial monitor выставил 16383

Darkmen203, 2024-01-18:
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
но при этом все равно когда вправо крутишь не получилось добиться 16383

vsulako, 2024-01-18:
Не получается повторить.
Можете выложить исходник прошивки который у вас загружен?

Darkmen203, 2024-01-18:
[AFFBWheel-master_Darkmen_set.zip](https://github.com/vsulako/AFFBWheel/files/13981383/AFFBWheel-master_Darkmen_set.zip)
вот мой исходник

Darkmen203, 2024-01-18:
У меня как будто бы импульсами работает и как будто бы не на 100% зажимает, а на 80, по сравнению с вашим графиком

vsulako, 2024-01-21:
Чертовщина какая то. И с этим исходником все работает как должно.
Выложите еще бинарный (скетч/экспортировать бинарный файл). В исходнике такой есть, с ним тоже работает нормально, но по моему, там немного другие настройки.
А как с другими эффектами? Если в FEdit создать эффект Constant с макс усилием - тоже импульсами на 80%?
И еще попробуйте без пина EN, в BTS выводы R_EN/L_EN посадить на +5v.

Darkmen203, 2024-01-21:
Ну сейчас я в итоге попробовал замерить блок питания, который использовал (12v 6.97A). В итоге оказалось что блок присаживается в момент нагрузки с 11.53v до 5v, решил пробовать другие блоки питания(использовал компьютерные)
1. Подключил блок питания 12v 17A.
          Мотор стал хорошо держать не импульсами, но если силой пройду ограничение, то мотор начинает сходить с ума и бесконечно крутить влево( при этом в программе обратно не выходит с границы), отключение блока питания и все становится на свои места, в программе сразу же определяет положение и все четко.
2. Подключил другой блок питания 12v 14A.
       И все отлично, полностью все хорошо работает, с ума ничего не сходит.

Итог: получается что блок питания должен быть чуть с запасом, но не сильным, если переборщить, то можно сгореть, хех, потому что теперь вся комната пропахлась запахом оплётки мотора хех. Не знаю так и должно быть или нет. Но все же получается также когда подключил блок питания 14А померил сколько было в пике ампер(подключением мультиметра в разрыв плюса), показалось 8а и при начале нагрузки около 7а. Т.е. итог минимум 10А для более менее нормлаьной работы, но кто ж знал

vsulako, 2024-01-21:
775 не должен столько потреблять. Тем более что еще и воняет. Он так сгорит.
У меня 775 с12в (а сам двигатель на 24),  и редуктор 1:25.  так когда просто крутит - потребляет ~250ма, а при блокировке - около 2а.
Ему ничего там не мешает? может закусывает где-то?

Darkmen203, 2024-01-21:
У меня 775 12в, воняет только когда я соединил с блоком 17ампер и когда завел за огранку с большим усилием и он начал с ума сходить, с 14амперами все нормально)

Darkmen203, 2024-01-21:
Ну у меня он не закусывает, просто стоит в соотношении 1:4 и на основном валу руль от defender adrenaline mini, получается что мб вес большой, хотя в планах ставит руль от реальной машины, поэтому он должен этот уж точно выдерживать, впринципе вот от 10ампер ему норм было бы)

Darkmen203, 2024-01-21:
Хм, очень странно, мб у меня какой-то неправильный 775

vsulako, 2024-01-21:
Ну они вообще разные бывают.
https://ae01.alicdn.com/kf/HTB15etNXPzuK1RjSspeq6ziHVXaR.jpg
https://ae01.alicdn.com/kf/HTB1EPjabBiE3KVjSZFMq6zQhVXaC.jpg

Darkmen203, 2024-01-27:
Извините, не видел ваше сообщение, все блок пытаюсь найти) Хорошо попробую сегодня замерить без нагрузки. Параллельно делал коробку передач и столкнулся с вопросом: будет 7-9 кнопок, хотел соединять их по схеме APB первый вариант, единственное, резистор подтягивающий от питания у меня больше (220ком) и вот проблема в данный момент соединил 7 кнопок и не пойму по какому принципу должно работать АЦП? У меня при отключении от пина аналогового провода seri monitor выдает 165 ( я думал что должно быть 0 или 255) и ещё вопрос vcc к 5v подключать?

Darkmen203, 2024-01-27:
> Ну они вообще разные бывают. https://ae01.alicdn.com/kf/HTB15etNXPzuK1RjSspeq6ziHVXaR.jpg https://ae01.alicdn.com/kf/HTB1EPjabBiE3KVjSZFMq6zQhVXaC.jpg
>
> А есть возможность его снять и измерить ток без нагрузки?

Замерил вообще без нагрузки 0.6а

Darkmen203, 2024-01-28:
@vsulako сейчас еще раз все поменял, нашел резистор как на схеме (100 Ком), VCC подключил к 5V, GND к GND. Единственное заметил, что случайно купил на 4.7 Ком резисторы к кнопкам. Попробовал замерить мультиметром что происходит и значения почему-то не меняются. И вот вопрос, правильная ли схема? (В интернете большинство схем по-другому выглядят. И как расчитать какие должны быть резисторы, как правильно проверить? У меня АЦП вообще не меняется.

Darkmen203, 2024-03-17:
в целом сейчас более менее нормально все, но буду увеличивать отношение вала к рулю. Еще есть доп вопрос, есть ли возможность возврата руля к центру аля как в logitech, только засчет двигателя. Т.е. чтобы это можно было настроить отдельно от игры?

vsulako, 2024-03-18:
нет, постоянных эффектов нет.

Darkmen203, 2024-03-22:
Понял, спасибо, все остальные проблемы решил путем изменения соотношения шкивов, преднатяжителем и установкой другого БП. Остальное пока в планах, а именно сделать кнопки на спорт руль, лепестки и педали. Потом мб покажу, если будет все красиво сделано) Пока что хаос)

Closed 2024-03-22.

Thread 50 (2024-01-23):

RGB Light

Mahovski, 2024-01-23:
Congratulations, you did a good job. It would be a lot of fun to add RGB rev lights like this.

https://www.youtube.com/watch?v=u5kZjg_sJdg
https://forum.arduino.cc/t/shift-light-code-am-i-doing-it-right/648661/2

Mahovski, 2024-02-01:
@vsulako

vsulako, 2024-02-01:
I think adding support for RGB strip to firmware is not possible - not much free space in flash left, I prefer to save it for more controller-related features, and it likely will not be enough anyway.
This is by design independent from controller, one always can take a separate nano/uno and add a rev indicator like that to any wheel.

Thread 51 (2024-01-26):

Центрирование

Envi4, 2024-01-26:
Пробовал кольца, резьбу, но моя конструкция с мощным мотором увы не способна жить для такой центровки, появилась идея, правда не уверен что оно возможна в реальной жизни, а не только в моей голове

Идея такая, на валу ставится магнит на кольцо или на ту же шестерню, этот магнит мы ставим так что это 0 положение руля, напротив ставится as5600 при запуске начинается поиск магнита, когда он найдется он центрирует руль по нему
Я не уверен что моя идея имеет права на жизнь, но вдруг вам это понравится и вы захотите сделать это

Thread 52 (2024-02-04):

Проблема с использованием MCP23017

mitiaborodada, 2024-02-04:
Привет!
Очень нужна помощь с прооблемой использования модуля MCP23017.
Всё сделал согласно схеме, но почему-то, при подключении к ПК сразу срабатывают 01 / 09 кнопки, иногда 01/ 02 /09 /10
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

mitiaborodada, 2024-02-04:
Дополнение.
Видимо был где-то плохой контакт, т.к. сейчас при включении срабатывают сразу 6 кнопок: 01, 02, 03  и 09, 10, 11 (физически кнопки даже не подключены к платам)
Причём, остальные кнопки работаю нормально, если каждую замкнуть на МИНУС.

vsulako, 2024-02-04:
Попробуйте увеличить значение параметра I2C_DELAY.

mitiaborodada, 2024-02-05:
Не работает. Попробовал поменять пины:
#define I2C_PIN_SDA 2
#define I2C_PIN_SCL 3
и I2C_DELAY делал от1 до 5

При подключении параллельно AS5600 и MCP23017 вообще ничего не работает, если оставить AS5600, то датчик поворота работает, Но если вообще отключить датчики от пинов 2 и 3, то  срабатывают все кнопки сразу. А датчик MCP23017 отдельно никак не хочет работать. Даже не знаю куда копать.

mitiaborodada, 2024-02-10:
> Попробуйте увеличить значение параметра I2C_DELAY.

Приветствую!

Уже проверил несколько раз схему и все соединения прозвонил и перепаял. Сначала думал, что это из-за того, что модули разнесены - один стоит в КПП, другой на руле.  Но потом модули поставил рядом. Провода, соединенияющие модули по  SDA и SCL минимальны - 5 см.

Пробовал 2C_DELAY с разными значениями от 1 до 400. Руль при этом работает, а кнопки не хотят. Т.е. работают, кроме тех, что на скрине - они постоянно включены. При некотрых значениях 2C_DELAY добавляется ещё по одной включенной кнопки с каждой стороны.

Вообще уже не понимаю в чём косяк.

Буду очень рад, если поможете решить проблему с модулями.

mitiaborodada, 2024-02-11:
В дополнение.  Если поменять адреса модулей, например так:
MCP23017_ADDR1  0x22
MCP23017_ADDR2  0x24
то тогда вообще никакой реакции нет. Ни одна кнопка не включается. Разные варианты пробовал, ничего не помогает.

jhnf, 2024-02-14:
@mitiaborodada а длина проводов какая?

вот что нашёл:
> при разработке устройств с MCP23017 (и всех аналогичных по принципу работы) следует избегать подключение к шине I2C датчиков и сенсоров с длинными проводами, по возможности их стоит перенести на другую шину (например на ESP32 их две)

mitiaborodada, 2024-02-14:
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

5 см. Я как раз это написал во втором сообщении. До этого модули были разнесены, но результат тот же.

Между модулями и контролёром 5 см.

Вчера пробовал вообще отключить всё, кроме этих модулей. Пробовал разные адреса для них, но единственное чего добился, это одна включенная кнопка постоянно. При включении остальных кнопок могут сработать сразу две в разных местах. Думаю, может быть, проблема с модулями? Может брак попался?

mitiaborodada, 2024-02-19:
Надоели танцы с бубном с этими модулями. Решил пойти самым простым путём. Большинство кнопок разделю на блоки по 6-7 штук и повешу на разные аналоговые входы. Т.к. большинство кнопок работают сами по себе и не требуют проверки одновременного нажатия, то это самый быстрый и простой вариант, не требующий глобальных изменений в коде прошивки.
Исключением являются  2 кнопки на ручке КПП, отвечающие за переключение рядов и уровень передач.

Thread 53 (2024-02-10):

Проблема с настройкой педалей

IvanZagrebin, 2024-02-10:
В утилите аффбвхил ось встает в упор при нажатой педали на половину(кнопка Макс не помогает)

mitiaborodada, 2024-02-11:
> В утилите аффбвхил ось встает в упор при нажатой педали на половину(кнопка Макс не помогает)

1. Какие датчики используете на педалях?
2. На всех педалях такая проблема?
3. Какую схему используете для педалей? Их автор предлапгает несколько.
4. При нажатии на педаль данные, которые считываются с датчиков, плавно нарастают?

PS Это как в службе поддержке, по тексту клиента ничего не понятно, кроме того, что не работаетЮ поэтому столько вопросов)))

IvanZagrebin, 2024-02-11:
Использую потенциометры, на всех педалях такая проблема, педаль достаточно плавно.
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

IvanZagrebin, 2024-02-11:
Может лучше в ВК перейти

IvanZagrebin, 2024-02-11:
Так удобнее

lazenyuk-dmitry, 2024-02-11:
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

Я общался с Иваном ВК) Вот чето я думаю что косяк именно на стороне оборудования. Похожих проблем ни у кого не было. У меня педали на простых потенциометрах. Все четко. Так же есть стик и одна вертелка и тоже все отлично работает.

@IvanZagrebin а потенциометры новые? Какие. Скинь сюда фотки своих печалей. Потенциометры и как подключено.

IvanZagrebin, 2024-02-11:
Потенциометры из джойстика старого, но работал он нормально

lazenyuk-dmitry, 2024-02-11:
> Потенциометры из джойстика старого, но работал он нормально

Опа... А вот и проблема наверно) я ставлю все на косяковые потенциометры. Тем более из джойстика. Даже не знаю как ты их туда вкорячил. Я знаю в стихах стоят они мелкие капец. Поставь нормальные потенциометры. Хоть из старой советской техники.

IvanZagrebin, 2024-02-11:
Да они норм, люфта нет вроде

IvanZagrebin, 2024-02-11:
Можно конечно на мультиметре проверить

IvanZagrebin, 2024-02-11:
Крепил на суперклей

IvanZagrebin, 2024-02-11:
Кстати так подумал может затек

IvanZagrebin, 2024-02-11:
Я прошивку перезаливал

IvanZagrebin, 2024-02-11:
Попробую

lazenyuk-dmitry, 2024-02-11:
Ну проверь сперва потенциометры. Прошить успеешь.

IvanZagrebin, 2024-02-11:
потенциометр подозрительно работает

IvanZagrebin, 2024-02-11:
показание до 20 ком а потом 0

IvanZagrebin, 2024-02-11:
сейчас перепаяю
на новый

IvanZagrebin, 2024-02-11:
видимо дело в потах, с новым ситуация получше(из за потенциометра ось скачет, но ему тоже плохо
 )

IvanZagrebin, 2024-02-11:
ура! проблема решена

IvanZagrebin, 2024-02-11:
спасибо за помощ

Thread 54 (2024-02-15):

Подскажите как подключить gimx

Envi4, 2024-02-15:
Прикупил cp2102, не могу понять как правильно подключить
Соединить TXD, RXD, GND с моей платой ардуино леонардо и подключить gimx и леонардо по юсб в 2 порта? И так же если этот вариант правильный, можно ли cp2102 повесить на тот же usb выход что и ардуино леонардо
Или надо еще отдельную плату ардуино иметь к cp2102?
gimx нужен для адекватной работы ffb в forza

lazenyuk-dmitry, 2024-02-15:
Собираешь GIMX. Если играешь на ПК то нужно включить оба usb в ПК. Потом подключить руль к ПК и настроить кнопки руля на эмуляцию в коныигураторе GIMX. У тебя будет и твой пуль в диспетчере устройств и эмулятор руля например g25.

Envi4, 2024-02-18:
Благодарю все получилось, но столкнулся с такой проблемой что Форза хорайзен все адекватно работает, а решил попробовать мотоспорт новый и gimx просто крашется с ошибкой невозможно обновить эффект, может знаете как можно решить

Closed 2024-06-18.

Thread 55 (2024-02-20):

Проблема с подключением кнопок руля G27

adn88, 2024-02-20:
Подскажите пожалуйста как решить.
Имеется руль от логитека g27. Внутри на плате распаяны две микросхемы одна 74hc165d на кнопки и другая hc595ag на светодиоды.
Подключился к 74hc165d согласно схеме но первый ряд кнопок работает наоборот, то есть нажаты все 16 кнопок когда кнопки физически не нажаты, когда физически нажимаешь на кнопку она отжимаеться в свойствах джойстика виндовс. Может кто знает как их инвертировать?

adn88, 2024-02-21:
Спасибо за быстрый ответ, позже отредактирую код в прошивке.

adn88, 2024-03-01:
Спасибо за информацию. Заработали кнопки как положено, только второй ряд 8 кнопок были всегда нажаты, на руле только 8 кнопок и одна микросхема. Немного подредактировал код заработали как положено.
Вот таким образом.
### ```
#if BUTTONS_TYPE == BT_74HC165

  #ifdef HC165_PIN_PL
    digitalWriteFast(HC165_PIN_PL,1);
  #else
    digitalWriteFast(HC165_PIN_SCK, 0);
    digitalWriteFast(HC165_PIN_SCK, 1);
  #endif

  i=0x80;
  do
  {
      if (digitalReadFast(HC165_PIN_DATA1))
         d[0]|=i;

      digitalWriteFast(HC165_PIN_SCK, 0);
      digitalWriteFast(HC165_PIN_SCK, 1);

  } while(i>>=1);

  #ifdef HC165_PIN_PL
    digitalWriteFast(HC165_PIN_PL,0);
  #endif

#endif
```
Подозреваю что все остальные каналы кнопок я отключил, да мне они и не нужны.
Для теста обратной связи и кнопок на руле мне хватило.
Первое что могу сказать как пользователь руля логитек g27, очень малая сила центрирования руля в повороте. В assetto corsa competizione еще можно как-то настроить но вот в том же race 07 она отсутствует напрочь. Может что-то не донастроил, времени больше не было.
Удивила возросшая точность, эффекты вибрации при жестком торможении
и на грани сцепления с трассой.
Все тестировал на том же железе логитека 27, моторы, энкодер и блок питания родные.
Может позже будет время дотестирую. Оригинальная обратная связь после вашей реализации AFFB неинформативная и какая-то вялая.
Спасибо за ваш труд и удачи.

Closed 2025-02-08.

Thread 56 (2024-02-21):

use with steering pot

mckelektronik, 2024-02-21:
hi, I really like the library.congratulations on being stable. do you think it is possible to replace the steering wheel with a potensiometers instead of an encoder?

Thread 57 (2024-03-10):

Use the digital pin to map action

5nax, 2024-03-10:
I am very new in programming this sort of stuff so please help me through. I have a couple of digital pins free on my pro micro. is it possible to map the free digital pins ( not used for anything else ) to be mapped to the HAT buttons? for example if I have pin number 8 free
`#define HAT_BTN_DOWN   8
`
will the hat button down work?

```
#define HATSWITCH           //uncomment to enable feature
#define HAT_BTN_UP     20   //button numbers for hat directions
#define HAT_BTN_DOWN   21
#define HAT_BTN_LEFT   22
#define HAT_BTN_RIGHT  23
#define HAT_CLR_BTNS   	    //if this line is commented, selected buttons will continue to register presses along with hat switch

```

vsulako, 2024-03-11:
Hatswitch config does not use pin numbers, it uses controller button numbers.

If you want to map arduino pin as button, use direct-pin-to-button section.

Example:
```
//buttons directly connected to pins
#define DPB        //Enable
#define DPB_PINS       3,4,5,8  //comma-separated list of pins
#define DPB_1ST_BTN    1
```
Here, pins 3,4,5,8 will be mapped to buttons 1,2,3,4.  These buttons should connect selected pin to GND when pressed.

Then, you can select these buttons (1,2,3,4) as hat switch directions.

5nax, 2024-03-11:
Thanks for the input, I got it working.

But now i have another issue i am trying to use an analog joystick module for H Shifter

```
//analog H-shifter
#define ASHIFTER
#define ASHIFTER_PINX     A7
#define ASHIFTER_PINY     A8
#define ASHIFTER_POS      8   //6 or 8 positions
#define ASHIFTER_Y1       137
#define ASHIFTER_Y2       255
#define ASHIFTER_X1       0
#define ASHIFTER_X2       139
#define ASHIFTER_X3       199
#define ASHIFTER_1ST_BTN  25
```

Is it possible to use average value for the bounding zones for x1,x2,x3 and y1,y2 cause my joystick sends unstable value 2-3 offset.

5nax, 2024-03-11:
Could i use the bottom code to add tolerance?

```
//analog shifter
#ifdef ASHIFTER
  // Assume TOLERANCE is defined somewhere in your code, e.g., #define TOLERANCE 10
  uint8_t x = analogReadFast(ASHIFTER_PINX) >> 2;
  uint8_t y = analogReadFast(ASHIFTER_PINY) >> 2;
  uint8_t g = 0;

  if (ashifter_out) {
    Serial.print(F("Analog shifter X:"));
    Serial.print(x);
    Serial.print(" Y:");
    Serial.println(y);
  }

  // Clear bits for different positions
  #if ASHIFTER_POS == 8
  wheel.buttons &= ~((uint32_t)0xff << (ASHIFTER_1ST_BTN - 1));
  #elif ASHIFTER_POS == 6
  wheel.buttons &= ~((uint32_t)0x3f << (ASHIFTER_1ST_BTN - 1));
  #endif

  // Set bits with tolerance
  if (y <= ASHIFTER_Y1 + TOLERANCE && y >= ASHIFTER_Y1 - TOLERANCE) {
    g = 0b00000001;
  } else if (y >= ASHIFTER_Y2 - TOLERANCE && y <= ASHIFTER_Y2 + TOLERANCE) {
    g = 0b00000010;
  } else {
    return; // If Y is not within tolerance of Y1 or Y2, exit early
  }

  if (x >= ASHIFTER_X1 - TOLERANCE && x < ASHIFTER_X2 - TOLERANCE) {
    // No need to shift g, as it's already set for the first range
  } else if (x >= ASHIFTER_X2 - TOLERANCE && x < ASHIFTER_X3 - TOLERANCE) {
    g <<= 2; // Shift for the second range
  }
  #if ASHIFTER_POS == 8
  else if (x >= ASHIFTER_X3 - TOLERANCE) {
    g <<= 2;
  }
  if (x >= ASHIFTER_X3 - TOLERANCE && x < ASHIFTER_X4 - TOLERANCE) {
    g <<= 2;
  }
  else if (x >= ASHIFTER_X4 - TOLERANCE) {
    g <<= 4;
  }
  #endif

  wheel.buttons |= ((uint32_t)g << (ASHIFTER_1ST_BTN - 1));
#endif
```

i used the help of chatgpt for this code and the gear shifter is working as expected but i dont know if it affects any other codes..

vsulako, 2024-03-12:
Yes, it should not affect anything.

5nax, 2024-03-13:
Thank you! Appreciate it.

Closed 2024-03-13.

Thread 58 (2024-03-25):

Auto find range problem

Ertugrulbabaci, 2024-03-25:
Hello. I added physical limiters in two directions, left and right. I set it to 900 degrees. When I activate it as you say in the codes, it goes first to the left and then to the right. Then, instead of finding the middle point, it starts to turn left forever. There is no midpoint. what is the reason of this?

vsulako, 2024-03-25:
I changed code a bit, please update and check if it helps.

Ertugrulbabaci, 2024-03-26:
It now finds the midpoint, but there is a left turn of -8 degrees. Can I make it stop at the midpoint? Also, can a button be assigned to operate this system?

Ertugrulbabaci, 2024-03-26:
It now finds the midpoint, but there is a left turn of -8 degrees. Can I make it stop at the midpoint? Also, can a button be assigned to operate this system? https://github.com/vsulako/AFFBWheel/assets/154468129/c8e1324c-6a91-43bf-8909-780a86037604

oscarMO7, 2024-03-29:
I added this feature it is really useful but it would be better if I you assign it to a button @vsulako

vsulako, 2024-04-03:
> It now finds the midpoint, but there is a left turn of -8 degrees. Can I make it stop at the midpoint?
try to lower AFC_FORCE. Applied force turns of when reaching center, but wheel can go further because of inertia.
Need to rewrite this procedure.

> Also, can a button be assigned to operate this system?
Added this.  `#define AFC_BUTTON` in config.h

Thread 59 (2024-04-02):

Пропали звуки тормозной системы в ATS и ETS

mitiaborodada, 2024-04-02:
Привет!
У меня возникла такая проблема. В какой-то момент в ATS пропал звук тормозов (когда нажимаешь на педаль слышны всякие "пшыкающие" звуки)
Пропал именно звук тормоза. Все остальное работает. Что интересно, такая же проблема и с ETS 2.
Заметил одну деталь, если вместо педали использовать клавиатуру, то звук тормозов есть. Как такое может быть??? Что произошло в системе, что реакция на педаль перестала работать?

Может есть какие-то идеи? Очень нужна помощь. Буду очень благодарен 🙏

vsulako, 2024-04-03:
Чертовщина какая то. Даже не представляю, в чем может быть дело.

mitiaborodada, 2024-04-04:
Оно как бы не критично, но эффект симуляции пропадает😁 И уже просто становится интересным, в чем причина. Сначала, переустановил сам мод, отвечающий за звуки. Не сработало, вспомнил, что у меня есть же ETS, захожу туда, а там тоже самое, звук тормозов пропал. Значит дело не в игре. Возможно ошибка кроется в usb - драйвер, либо виртуальный com порт. У меня ещё на ноуте установлена игра, там попробую.

mitiaborodada, 2024-04-04:
Как говорится, дело было не в бобине)))
Попробовал на нотнике. Всё работает.
Значит проблема в ПК. Но как и почему??? Это точно не с игрой проблема, т.к. звук сразу пропал в обеих играх одновременно. Значит проблема в передаче данных через протоколы обмена.

Thread 60 (2024-05-01):

Value problem

Ertugrulbabaci, 2024-05-01:
I use analog button connection. Sometimes it comes to an irrelevant value when pressing the buttons. Therefore, the button I want to press is pressed on an external button. Is there anything I can do to make the values more stable? For example, a button may suddenly display a value of 120 when it should be 95+-.

Thread 61 (2024-05-28):

2 joy 16 b

Brandy0841, 2024-05-28:
Nice work, congratulations. I have a question. Is it possible to make a steering wheel with 2 joysticks and 16 buttons? It would be nice to be able to use 2 joysticks for games like farming simulator and snowrunner. Thanks! @vsulako

vsulako, 2024-06-16:
I don't understand what do you mean by 2 joysticks. Are they thumbsticks?
Gaming controller can have up to 8 analog axes. 1 axis is wheel, 3 are for pedals, and there are 4 spare axes, so nothing prevents from connecting 2 thumbsticks (2 axes each).

Ertugrulbabaci, 2024-06-21:
Is the maximum limit that Arduino can take 8 axes or is it related to the codes written? For example, can't you change the codes to 10 axes?

Ertugrulbabaci, 2024-06-21:
> I don't understand what do you mean by 2 joysticks. Are they thumbsticks? Gaming controller can have up to 8 analog axes. 1 axis is wheel, 3 are for pedals, and there are 4 spare axes, so nothing prevents from connecting 2 thumbsticks (2 axes each).

Is the maximum limit that Arduino can take 8 axes or is it related to the codes written? For example, can't you change the codes to 10 axes?

vsulako, 2024-06-24:
It is DirectInput limitation. Windows will only recognize up to 8 axes and 128 buttons in a single HID gaming controller, even if more are declared, excess ones will not work.
Also, there are only 8 axis names in HID specifications for a generic controller: x,y,z, rx,ry,rz, slider,dial. May be it matters too.

Thread 62 (2024-06-15):

2 ProMicros: Steering Wheel + Pedals and Buttonbox (74HC165) + shifter (74HC165 using limit switch)

spry02, 2024-06-15:
Hi, first of all I want to make two separate circuits due to analog limitations (can be changed to one circuit but don't know if I can use enough analog inputs, one of the joysticks can be removed)
### **First circuit:**
I want to make few buttons, two joysticks, steering wheel and pedals
### **Second circuit:**
7 buttons gearbox with buttonbox + handbrake as analog

I wonder if you have any idea about functionality of this setup, I want to use this steering wheel with ETS2.

**My question/problem:**
I want to make gearbox with two selectable ranges using bistable switch. I thought about solution like this (Using 7 limit switches, two 74HC165 with separated DATA pins selectable with switch. Limit switches will be connected to both HC165, both HC circuits are linked together, but as I told DATA connection will be selected with bistable switch.)

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

### Would it work as for example:
Range 1 buttons: 1, 2, 3, 4, 5, 6, 7
**and then after switch flick**
Range 2 buttons: 8, 9, 10, 11, 12, 13, 14
(in my mind it works like: you engage first gear, then flick the switch, and now it is seventh gear)

**or**

buttons will override as same inputs?
(you engage first gear, then flick the switch, and it's still first gear)

If you have any advices or better idea to fulfill my idea please let me know. I appreciate every form of help.

vsulako, 2024-06-16:
This circuit will work on second scenario (engage first gear, then flick the switch, and it's still first gear).
Switch does nothing here, both sides of switch leads to identical circuitry.
You don't need second HC165, just make switch change DATA wire from arduino's side (in one position DATA from HC165 connects to pin 2, in other position it connects to pin 7).
On the other side,  is this really necessary? ETS2 supports Range/Splitter buttons, which should do the same thing: when Range button is unpressed, shifter changes 1,2,3,4,5,6 gears, when it is pressed - they becomes 7,8,9,10,11,12 gears.
https://steamcommunity.com/sharedfiles/filedetails/?l=polish&id=1215476496
Also, ETS2 can only assign 6 keys for forward gears.

spry02, 2024-06-17:
Damn thanks a lot, i honestly didn't look to much into ets2 settings, kinda delayed that to other time because I'm still completing my parts and gaining enough budget, thanks to you I won't make such a stupid mistake. So now I can really easily make 24 buttons on my button box and still have fully functional gearbox for trucking with friends.

When I finally begin to make whole setup I will keep posting updates of my work if you are interested. Also when I won't be sure of some solutions I will ask for help.

Once again, thanks a lot mate. You are making really great job! Take care!

Thread 63 (2024-07-06):

GIMX x AFFBWHEEL

oscarMO7, 2024-07-06:
Hello. I want to use my steering wheel set on PS or Xbox with the help of gimx. Is it possible to integrate your codes with the codes provided in gimx's open source (https://github.com/matlo/GIMX) instead of buying an extra Arduino? In this way, we avoid unnecessary cable crowds and unnecessary expenses. thanks.

Thread 64 (2024-07-17):

Добавление ещё одного джойстика на Pro Micro

alivergg, 2024-07-17:
Можно ли убрать линию PL(как указано в документации), перекинуть пины для управления драйвером на 3 и 5 цифровые пины(у них есть PWM) и докинуть ещё 1 джойстик на пины A9 A10(9 и 10 пины аналоговые)?

vsulako, 2024-07-18:
Нет. Во первых, пины управления драйвером нельзя так просто поменять, там управление не через analogWrite, а через таймер 1, у которого выходы на пины 9-10.
Во вторых, у контроллера все равно может быть не больше 8 осей (больше Windows не увидит).

Closed 2024-07-19.

Thread 65 (2024-09-07):

Using SimpleFOC to control the motor

jairov96, 2024-09-07:
Hello,

I'm going to embark in the challenge of using a small BLDC motor and the SimpleFoc library to create a little desktop FFB controller ( https://www.youtube.com/watch?v=7g6O4G1OXd4 like this, but with FFB).

By any chance are you familiar with the simpleFoc library? I am trying to make some sense of your project in order to figure out where exactly do I need to initiate the driver and how to exactly do the wiring, as simplefoc wants 3 PWM signals in order to control the motor poles.

In any case, I wanted to thank you for this project. I already got it up and working for controlling the in-game steering and pedals, just missing how to adapt the FFB to work.

Thanks

Thread 66 (2025-02-06):

Vibration at center

cartaio, 2025-02-06:
Hi, i've been using your code for more than a year, i'm the guy from issue 35... work flowlesly other that i have in some games (assetto corsa is the worst for now), where i have a lot of vibration at the middle... one issue i found is that if i do the ac lut calibration it wont complete because it cannot find the center for some reason, do anyone had the same problem? i'll put a video if needed to explain it better...
thank you.

vsulako, 2025-02-20:
What is ac lut calibration?

cartaio, 2025-02-21:
It's really bad because it cannot get to the center when you try to calibrate it... i will upload a private video on yt so i can show you what it does...

cartaio, 2025-02-25:
[https://www.youtube.com/shorts/lJTymzJuInE?feature=share](url) Video of lut generation(yes is this bad in game too)
[https://imgur.com/a/jAePHpk](url) lut results...

Thread 68 (2025-02-11):

Инвертирован FFB в левую сторону для игры Forza Motosport

swellskam, 2025-02-11:

swellskam, 2025-02-11:
Такая же проблема наблюдается и с прошивкой VNWheel  от туда Вы брали HID. Возможно где то HID описание не правильно задано. Я не силен в этом, но я тоже программирую на языке C# хотелось бы понять где копать эту проблему.

vsulako, 2025-02-20:
Судя по тому что удалось найти в интернете, эта проблема в Forza Motorsport встречается и на других устройствах, .
Как будто бы игра игнорирует знак обратной связи, должно быть в отрицательную сторону, а она дает команду на положительную. Инвертирование ОС в игре у меня вообще не работало.
Если на той прошивке работает правильно, то можно попробовать разобраться. Попробую посмотреть, если будет время, но ничего обещать не могу.

vsulako, 2025-02-22:
Кажется, нашел причину.
Надо проверить.
Вот файл. [FfbEngine.zip](https://github.com/user-attachments/files/18924317/FfbEngine.zip)
Внутри ffbengine.cpp, замените им тот, что в папке проекта, прошейте заново и попробуйте снова.

swellskam, 2025-02-22:
Спасибо что ответили да в этом файле я его уже исправил там же и обратной связи не было на Gimx, но для себя я переделал его кардинально я работал над обратной связью в целом, а так же сделал регулировку в процентах. Спасибо еще раз очень хорошая работа фитбек отличный.

swellskam, 2025-02-22:
https://prnt.sc/G-d3s4YCDDoV

swellskam, 2025-02-22:
Мое решение вот такое https://prnt.sc/juWcoGJGw02H

vsulako, 2025-02-22:
Вообще впервые вижу чтобы игра использовала параметр directionX.
Поэтому черт его знает, как правильно.

> https://prnt.sc/juWcoGJGw02H
По моему, на скрине потенциальный баг - меняется знак не конкретного эффекта, а totalForce.
А если одновременно создать два эффекта с directionX>127? знак поменяется дважды.
Наверное, вряд ли такое произойдет, но вдруг?

Ну и кстати еще можно оптимизировать немного. зачем каждый раз рассчитывать знак? я бы перенес это в обработку SetEffect, а в цикле ОС один раз умножал на заранее сохраненный знак в int8_t.

swellskam, 2025-02-22:
Ну я делал на ощуп а не по научному. Дело в том что я со сдвигами не дружу я понимаю что на сдвигах быстрее работает но пока я до них не дорос я не силён C++и потому я понимаю как есть но если это работает правильно на ощуп значит мне кажется то и пусть работает. Кстати применил я ваше исправление правда уже в свем коде пропала сила раза в три а то и четыре.

vsulako, 2025-02-22:
Может, вы переделывали hid descriptor и изменяли пределы magnitude у Constant effect?
Ну или мой синус неверно работает.

swellskam, 2025-02-22:
Нет я не трогал дескриптор там все так и осталось? но я убрал сдвиги в aplyGain изменил возвращаемый тип для всех эффектов он сейчас у меня int32_t потому я применил totalForce += к каждому эффекту убрал tmpForce в общем сделал так как я встречал в других кодах. Я просто ну не понимаю я сдвигов. И все это я делал с помощью deepseek это типа gpt chat. Да были проблемы с переполнениями но с горем пополам я это все осилил. Я поубирал бесполезные мне прибомбасы сделал для своего руля g29 он у меня сгорел и я решил сделать на Arduino сейчас фитбек на руле лучше чем был он с завода а самое главное множество настроек. Основная работа Ваша я не спорю но там не нужного было много для меня. Тем самым я сделал передачу в конфигурационную программу я сделал json так как места много освободилось. Программа еще не доделана но скриншоты я приложу Вы сами поймете что лучше обратить внимание на то что нужнее. https://prnt.sc/kWIztVMY7Mul      https://prnt.sc/W6G-QqAHAXh_

swellskam, 2025-02-23:
Да кстати я проверил Ваше исправление в Вашей прошивке да на вашем не тронутом коде исправление актуально только минус спереди не нужен он инвертирует то есть тянет от средины до края хотя в EndStop упирается корректно. Спасибо, что не игнорировали меня.

ertoben, 2025-07-26:
Can you share the version of the file that works without any problems in Forza Motosport? @swellskam @vsulako
