vsulako/AFFBWheel/(commit log)

2022-04-26 update readme
    removing resistor R1 if AS5600 is powered with 5v
2022-05-02 add analog buttons
    Update AFFBWheel.ino
2022-05-02 add hat switch
    Update wheel.h
2022-05-30 Add motor enable pin
2022-06-03 added endstop tuning
2022-06-08 endstop settings saving
    upd
2022-07-05 Add more informations for wiring diagram
2022-09-25 ADS7828 support
    i2c
2023-12-28 button matrix
2024-04-03 afc button
